avav10985/flightflight/docs/media/boot-screen.jpg

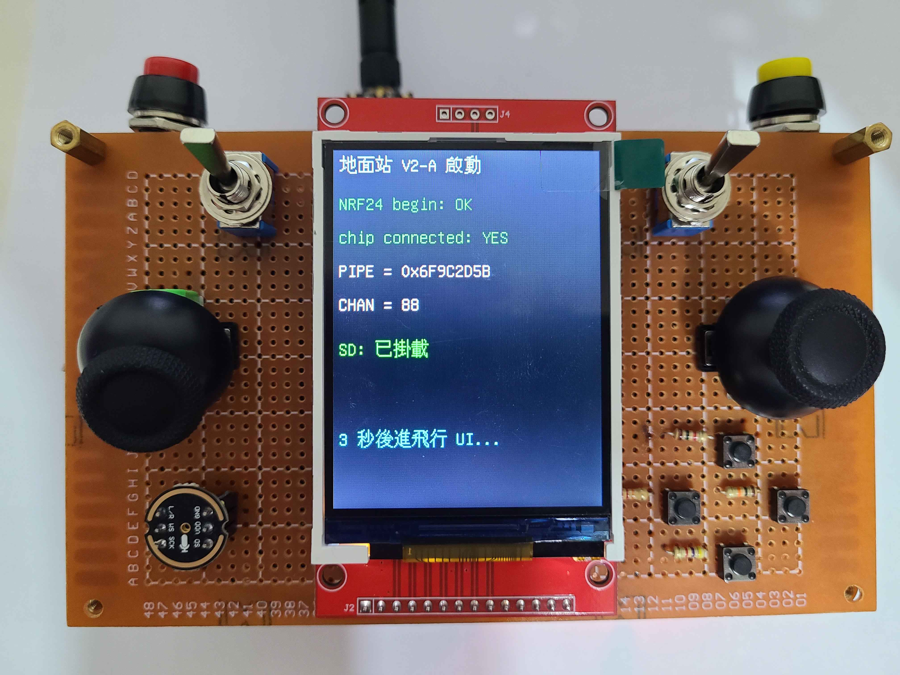
docs/media/boot-screen.jpg
