avav10985/flightflight/docs/media/drone-front.jpg

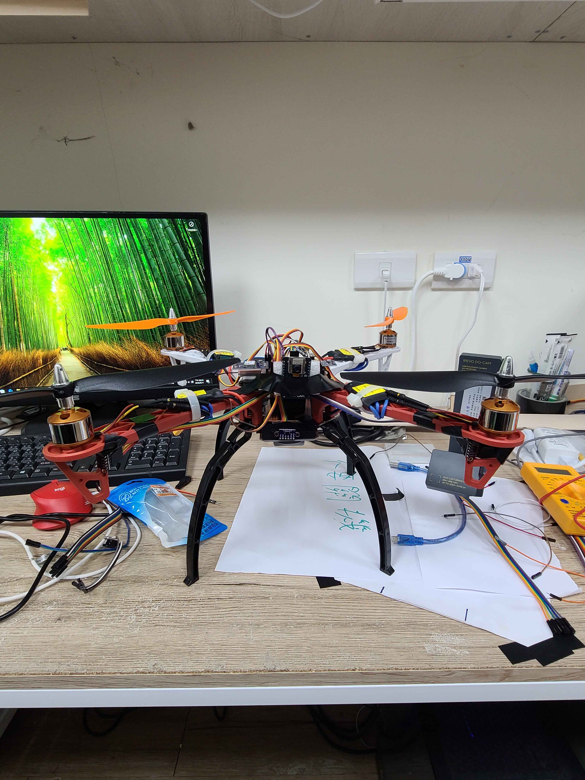
docs/media/drone-front.jpg
