avav10985/flightflight/文件/手把接線總表_V2.md

## 手把接線總表（V2-A：ESP32-S3-N16R8 + MSP2806 SPI TFT 直立）

> 焊接 + 買料用的單一對照表。對應程式：`Ground_TX_ESP32`（V2-A）。
> 設計理由與全套規劃見 `手把V2_討論摘要.md`；本檔只列「買什麼、接哪裡」。
> 注意：V1（30-pin WROOM + 2004A LCD）已跳過，舊的 `手把接線總表.md` 不再對應實作。
>
> **2026-06-02 變更**：螢幕從 MAR2406 並列 8-bit 換成 **MSP2806 2.8" SPI 直立 240×320**，
> 省 9 隻 GPIO（GPIO 11~18 釋出）+ A↔C 杜邦線從 26 降到 17。MAR2406 留為備用。
>
> **2026-06-02 再變更**:左搖桿 X 軸(VRx)從「不接」改接 **GPIO 2**(ADC1_CH1),
> 當作可選的 yaw 來源(預設仍是肩鍵,選擇 UX 等手把做好再加)。
> A↔C 杜邦線 17→18,C↔B 排線 11→12,腳位 26→27。
> V2-B I²S 保留腳 5→4(剛好夠 BCLK/WS/DIN/DOUT)。
>
> **2026-06-03 再三變更**:**GPIO 2 ↔ GPIO 10 對調**——左搖桿 yaw 改 GPIO 2、右搖桿 pitch 改 GPIO 10。
> 規律變整齊:**右側 ESP32 = 左搖桿訊號(throttle GPIO 1 + yaw GPIO 2)**、**左側 ESP32 = 右搖桿訊號(pitch GPIO 10 + roll GPIO 4)**。
>
> **2026-06-03 再再變更**:**TFT MSP2806 物理上搬到 B 板**(裝在前面板上,跟搖桿一起),
> C 板還在(電阻中繼)。TFT 訊號**用一條獨立的 6 條副排線**從 B 走到 C(不擠 12 條主排線),
> 再經 A↔C 杜邦回 A:CS、DC、SCK、MOSI、MISO、**RESET** 共 6 條。
> VCC/GND/LED 從 B 板既有 **3V3 軌**取(維持 3.3V 跟訊號同位準);
> RESET 線從 B 走副排線 #6 進 C 板,經 **R10 10kΩ 上拉到 3V3 軌**(保留未來加 GPIO 控制 RESET 的彈性)。

---

## 〇、元件對元件接線

> **架構**(2026-06-03 最新版):A 板腦 + **C 板電阻中繼** + B 板前面板(含 TFT)。
> A↔C 用**杜邦線 18 條**(可拔);C↔B 用**主排線 12 條**(輸入訊號)+ **副排線 6 條**(TFT 訊號)。
> ⚠️ 2026-06-06 試燒驗證:**MSP2806 LED 腳直接拉 B 板 3V3 軌常亮**(LED 內部沒接 VCC,接 GPIO PWM 不會亮),GPIO 15 回歸真正釋出。
> **11 顆電阻 + 肩鍵連接終點在 C 板**,B 板沒電阻。**TFT MSP2806 物理上裝在 B 板**(前面板),
> 訊號走 4 條副排線到 C → 再經 A↔C 杜邦回 A。
> 左搖桿兩軸都用:Y=油門(拆彈簧)、**X=可選 yaw 來源**(預設肩鍵,程式選單切換)。

### A 板(腦)上有什麼

| 元件 | 數量 | 備註 |
|--|:--:|--|
| ESP32-S3-N16R8 | 1 | 用 2×22 排母可拔 |
| NRF24L01+PA/LNA | 1 | 用排母可拔,緊貼右側 GPIO 38~42 |
| 100µF 電解電容 C1 | 1 | 焊在 NRF24 VCC↔GND(< 5mm)|
| 0.1µF 陶瓷電容 C2 / C3 / C4 | 3 | 選用:NRF24、S3、buck 出口各一 |
| buck 降壓模組 | 1 | MP1584 或 LM2596,OUT 先量好調 5.0V |
| 電源開關(SPST) | 1 | 串電池 + |
| 電池接頭(2S 7.4V) | 1 | XT60 / JST |
| **18 條杜邦排針**(4 組) | 1 套 | 對外接 C 板:電源3 + TFT 中繼2(CS/DC) + SPI/SD 4(SCK/MOSI/MISO/SD_CS,C 板上分歧給 SD 和 TFT) + B訊號9(含左搖桿 X) |

> A 板**沒有電阻**(R11 已搬到 C 板,跟其他電阻集中)。

### C 板(電阻中繼 + 訊號分歧點)

| 元件 | 數量 | 備註 |
|--|:--:|--|
| **R1:1kΩ** | 1 | ＋鈕串聯 |
| **R2:4.7kΩ** | 1 | −鈕串聯 |
| **R3、R5、R6、R7、R8、R9、R10、R11:10kΩ ×8** | 8 | OK 串聯 + 選單下拉 + SW_A 分壓×2 + SW_B 分壓×2 + **R10 LCD_RST 上拉**(從副排線 #6 進來) + SD_CS 上拉 |
| **R4:22kΩ** | 1 | 返回鈕串聯 |
| 肩鍵 L、R 連接終點 | 2 套 | 實體鈕鎖在外殼,線拉到 C |
| microSD 卡模組 | 1 | **定案用這個**(免轉接卡,模組小不頂搖桿)。MSP2806 內建 SD 座永遠空著別插卡 |
| 18 條杜邦排針(對 A 板) | 1 套 | 跟 A 板分組順序一致 |
| 12 條主排線接座(對 B,輸入訊號) | 1 套 | 給 B 板主排線插 |
| **6 條副排線接座(對 B,TFT 訊號)** | 1 套 | 給 B 板 TFT 副排線插(CS / DC / SCK / MOSI / MISO / RESET) |

> R10 重新啟用:TFT RESET 從 B 板經副排線 #6 進 C 板,接 R10 一端,R10 另一端接 C 板 3V3 軌(平常拉高 = 不重置;保留未來加 GPIO 控制 RESET 的彈性)。
> **TFT 不在 C 板了,搬到 B 板**。C 板變純電阻中繼 + SPI 訊號分歧點(SCK/MOSI/MISO 在 C 板上分歧:一路給 SD,一路經副排線給 B 板 TFT)。

### B 板(前面板:玩家會看到/摸到的東西)

| 元件 | 數量 | 備註 |
|--|:--:|--|
| **TFT MSP2806(2.8" SPI ILI9341)** | 1 | 鎖在前面板正中,**單排 14 隻排針**直接插 B 板的母排座 |
| **1×14 母排座(2.54mm)** | 1 | 插 MSP2806 那排排針(完全對齊洞洞板) |
| 搖桿模組(PS5 拇指搖桿) | 2 | 左=油門(Y,拆彈簧)**+ 可選 yaw(X,留彈簧)**;右=pitch/roll(留彈簧)|
| MTS-103 3 段開關 | 2 | SW_A、SW_B,ON-OFF-ON |
| 6mm 輕觸按鈕 | 4 | 選單 ＋/−/OK/Back |
| 12 條主排線接座(對 C,輸入訊號) | 1 套 | 給 C 板主排線插 |
| **6 條副排線接座(對 C,TFT 訊號)** | 1 套 | 給 C 板 TFT 副排線插(CS / DC / SCK / MOSI / MISO / RESET) |

> B 板**沒有電阻、沒有肩鍵**,但**有 TFT**(2026-06-03 從 C 搬過來,因為螢幕本來就要在前面板上跟搖桿一起)。

### 不在板上(整套手把的一部分)

- **肩鍵 L、R**:實體鎖在外殼上半部(食指位置),線拉到 C 板
- **2S LiPo 電池**
- **杜邦線 18 條**(A↔C,可彩虹色)
- **主排線 12 條**(C↔B,輸入訊號)
- **副排線 6 條**(C↔B,TFT 訊號:CS / DC / SCK / MOSI / MISO / RESET)
- **TFT LED 腳** 直接接 B 板 3V3 軌(不走副排線、不接 GPIO)
- **外殼**:面板開孔給 TFT、搖桿、開關、按鈕;上半部開孔給肩鍵

### V2-B 階段才會加(現在還沒放)

| 元件 | 數量 | 備註 |
|--|:--:|--|
| INMP441 麥克風模組 | 1 | I²S 數位麥克風,語音輸入用 |
| MAX98357A I²S 放大模組 | 1 | I²S → 喇叭驅動 |
| 小喇叭 | 1 | 4Ω 或 8Ω,3W 內 |
| I²S 4 條線 | — | BCLK、WS(LRCK)、DIN(麥)、DOUT(喇叭) |
| (V2-B 開工時)犧牲一條 debug UART | — | 釋出 GPIO 19/20(原生 USB)或 43/44(UART0)給 I²S |

> V2-B 走線:**I²S 4 條腳改用釋出腳 GPIO 11~14**(MSP2806 SPI 換來的)。GPIO 19/20、43/44 保持作為 debug 序列埠(兩條都活)。

---

### 螢幕(MSP2806 2.8" SPI ILI9341)↔ ESP32-S3

> MSP2806 **物理上裝在 B 板**(前面板),單排 14 隻排針插 B 板的 1×14 母排座。
> 訊號從 B 板出來經 **5 條副排線 → C 板 → A↔C 杜邦 → A 板**(SPI 部分跟 NRF24/SD 共用,在 C 板上分歧)。

| ESP32-S3 | MSP2806 排針 | 訊號路徑 |
|:--:|:--:|--|
| GPIO 48 | **CS** | A 板 GPIO 48 → A↔C 杜邦「TFT CS」→ C 板 → 副排線 #1 → B 板 TFT CS |
| GPIO 21 | **DC**(或 RS) | A 板 GPIO 21 → A↔C 杜邦「TFT DC」→ C 板 → 副排線 #2 → B 板 TFT DC |
| GPIO 38 | **SCK** | A 板 GPIO 38 → A↔C 杜邦「SCK」→ C 板(分歧:給 SD + 副排線 #3 → B 板 TFT SCK)|
| GPIO 39 | **SDI(MOSI)** | A 板 GPIO 39 → A↔C 杜邦「MOSI」→ C 板(分歧:給 SD + 副排線 #4 → B 板 TFT MOSI)|
| GPIO 40 | **SDO(MISO)** | A 板 GPIO 40 → A↔C 杜邦「MISO」→ C 板(分歧:給 SD + 副排線 #5 → B 板 TFT MISO)|
| (不接 GPIO) | **RESET** | B 板 TFT RESET → 副排線 #6 → C 板 R10 一端 → R10 另一端 → 3V3 軌(平常拉高)|
| (不接 GPIO)| **LED**(背光) | **直接接 B 板 3V3 軌常亮**(MSP2806 LED 內部沒接 VCC,試燒驗證 PWM 不會亮)|

TFT 其他腳(在 B 板上**直接**接,不走副排線):

| MSP2806 排針 | 接到 | 說明 |
|:--:|--|--|
| **VCC** | B 板 3V3 軌(3V3 從 C↔B 主排線 #1 來) | 主電源 |
| **GND** | B 板 GND 軌 | — |
| **T_CLK / T_CS / T_DIN / T_DO / T_IRQ** | **不接** | 觸控版才用,V2-A 沒觸控 |

(**RESET** 走副排線 #6 到 C 板的 R10 上拉、**LED** 直接接 B 板 3V3 軌常亮)

**省下來的 GPIO 11~18**(原本給並列資料的 8 隻)**全部釋出**——可給 V2-B、額外按鈕、LED 等。
**R10 變備用**:留 C 板上但無功能(MSP2806 不需要 RESET 上拉,直接拉 3V3 軌即可)。

---

### NRF24L01+PA/LNA ↔ ESP32-S3

| ESP32-S3 | NRF24 |
|:--:|:--:|
| GPIO 41 | CE |
| GPIO 42 | CSN |
| GPIO 38 | SCK |
| GPIO 39 | MOSI |
| GPIO 40 | MISO |

NRF24 其他腳:

| NRF24 腳 | 接到 |
|:--:|--|
| VCC | 3V3 |
| GND | GND |
| IRQ | 不接 |
| 100µF 一端 | NRF24 VCC |
| 100µF 另一端 | NRF24 GND |

---

### SD 卡 ↔ ESP32-S3(獨立 microSD 模組,放 C 板)

> ⚠️ **2026-06-09 暫時停用**:現有 SD 模組内含 level shifter,共 SPI 會搶 bus 拖爆
> NRF24 init(實證 begin: FAIL)。**飛行測試先把 SD VCC 拔掉**,程式 `ENABLE_SD = 0`
> 跳過 init。GPIO 47(SD CS)暫時空閒。
> 長期解法:換 3V3 直連、不含 level shifter 的 SD 模組。

> **定案用獨立 microSD 模組**(放 C 板)。
> 原因:MSP2806 內建是全尺寸 SD 座,卡插入後會凸出 ~7mm 頂到搖桿。
> MSP2806 板上的 SD 座**永遠空著別插卡**(電氣上 CS 也不接)。

| ESP32-S3 | 獨立 microSD 模組 | 說明 |
|:--:|:--:|--|
| **GPIO 0** | **CS** | 經 **R11:10kΩ 上拉**到 3V3;BOOT 腳開機 HIGH 安全 |
| GPIO 38 | **SCK** | 跟 NRF24 / TFT 共用 |
| GPIO 39 | **MOSI** | 跟 NRF24 / TFT 共用 |
| GPIO 40 | **MISO** | 跟 NRF24 / TFT 共用 |
| 3V3 軌 | VCC | |
| GND 軌 | GND | |

---

### 左搖桿(油門 + 可選 yaw)↔ ESP32-S3

| ESP32-S3 | 左搖桿 |
|:--:|:--:|
| GPIO 1 | VRy(Y 軸抽頭 → 油門,拆彈簧)|
| **GPIO 2** | **VRx(X 軸抽頭 → 可選 yaw,留彈簧)** |
| 3V3 | VCC |
| GND | GND |

左搖桿的 SW 不接。
**yaw 來源預設用肩鍵**;選單可切換到左搖桿 X(UX 等手把做好再加)。
**訊號全在 ESP32 右側**(GPIO 1 右#4 + GPIO 2 右#5,相鄰整齊)。

---

### 右搖桿(pitch / roll)↔ ESP32-S3

**訊號全在 ESP32 左側**(GPIO 10 左#16 + GPIO 4 左#4)。

| ESP32-S3 | 右搖桿 |
|:--:|:--:|
| **GPIO 10** | VRy(Y 軸抽頭 → pitch) |
| GPIO 4 | VRx(X 軸抽頭 → roll) |
| 3V3 | VCC |
| GND | GND |

右搖桿的 SW 不接。

---

### 模式開關 SW_A(MTS-103,3 段)↔ ESP32-S3

| ESP32-S3 | SW_A |
|:--:|:--:|
| GPIO 5 | 中腳(common) |
| 3V3 | 上腳(throw1) |
| GND | 下腳(throw2) |

GPIO 5 上同時並聯兩顆電阻:

| 電阻 | 一端 | 另一端 |
|:--:|--|--|
| R6:10kΩ | GPIO 5 | 3V3 |
| R7:10kΩ | GPIO 5 | GND |

---

### 模式開關 SW_B(MTS-103,3 段)↔ ESP32-S3

| ESP32-S3 | SW_B |
|:--:|:--:|
| GPIO 6 | 中腳(common) |
| 3V3 | 上腳 |
| GND | 下腳 |

GPIO 6 上同時並聯兩顆電阻:

| 電阻 | 一端 | 另一端 |
|:--:|--|--|
| R8:10kΩ | GPIO 6 | 3V3 |
| R9:10kΩ | GPIO 6 | GND |

---

### 選單 4 鈕(共用 GPIO 7,4 顆鈕電阻不同)

每顆鈕**有 2 腳**:一腳接 3V3,另一腳經自己的電阻接到 GPIO 7。

| ESP32-S3 | 經這顆電阻 | 來自哪顆鈕的「非 3V3 那腳」 |
|:--:|:--:|:--|
| GPIO 7 | R1:1kΩ | ＋鈕 |
| GPIO 7 | R2:4.7kΩ | −鈕 |
| GPIO 7 | R3:10kΩ | OK 鈕 |
| GPIO 7 | R4:22kΩ | 返回鈕 |

GPIO 7 還有一顆下拉:

| 電阻 | 一端 | 另一端 |
|:--:|--|--|
| R5:10kΩ | GPIO 7 | GND |

每顆鈕的「另一腳」全部接 3V3。

---

### 肩鍵 L ↔ ESP32-S3

| ESP32-S3 | 肩鍵 L |
|:--:|:--:|
| GPIO 8 | 一腳 |
| GND | 另一腳 |

---

### 肩鍵 R ↔ ESP32-S3

| ESP32-S3 | 肩鍵 R |
|:--:|:--:|
| GPIO 9 | 一腳 |
| GND | 另一腳 |

---

### 電源(buck / 電池 / 開關)

| 一端 | 另一端 |
|:--:|:--:|
| 電池 + 紅線 | 電源開關 一端 |
| 電源開關 另一端 | buck IN+ |
| 電池 − 黑線 | buck IN− |
| buck OUT+ | ESP32-S3 5V 腳;再經 A↔C 杜邦 → C 板 5V 軌(若 TFT 用 5V 則經主排線到 B 板 TFT VCC)|
| buck OUT− | ESP32-S3 GND;GND 全部共接 |

---

### C↔B 板 12 條排線(C 是中繼,B 沒有電阻)

| # | C 板端(電阻/節點端) | B 板端(實體元件端) |
|:--:|--|--|
| 1 | C 板 3V3 軌 | B 板 3V3 軌 |
| 2 | C 板 GND 軌 | B 板 GND 軌 |
| 3 | (上接 A 杜邦 → GPIO 1) | 左搖桿 VRy(throttle) |
| 4 | (上接 A 杜邦 → **GPIO 2**)| **左搖桿 VRx(可選 yaw)** |
| 5 | (上接 A 杜邦 → **GPIO 10**)| 右搖桿 VRy(pitch) |
| 6 | (上接 A 杜邦 → GPIO 4) | 右搖桿 VRx(roll) |
| 7 | (上接 A 杜邦 → GPIO 5)+ R6/R7 分壓 | SW_A 中腳 |
| 8 | (上接 A 杜邦 → GPIO 6)+ R8/R9 分壓 | SW_B 中腳 |
| 9 | R1(1kΩ)→ 選單節點 | ＋鈕「非 3V3 腳」 |
| 10 | R2(4.7kΩ)→ 選單節點 | −鈕「非 3V3 腳」 |
| 11 | R3(10kΩ)→ 選單節點 | OK 鈕「非 3V3 腳」 |
| 12 | R4(22kΩ)→ 選單節點 | 返回鈕「非 3V3 腳」 |

> 選單節點(R1~R4 匯流 + R5 下拉)在 C 板,4 顆鈕各自拉一條線過來。
> 肩鍵 L/R 不在 B↔C 排線裡,從外殼直接拉短線到 C 板。

### C↔B 板 6 條副排線(TFT 訊號專用)

> TFT MSP2806 物理上在 B 板,訊號從 B 板的 14 隻母排座引出 7 條,經副排線送到 C 板,再經 A↔C 杜邦回 A 板。
> **跟 12 條主排線分開**(實體用兩束排線,免訊號擠在一起)。

| # | C 板端 | B 板端(MSP2806 排針) |
|:--:|--|--|
| 1 | (從 A 來)GPIO 48「TFT CS」| **CS** |
| 2 | (從 A 來)GPIO 21「TFT DC」| **DC**(或 RS)|
| 3 | C 板 SPI SCK 節點(分歧:給 SD + 給此線)| **SCK** |
| 4 | C 板 SPI MOSI 節點(分歧:給 SD + 給此線)| **SDI(MOSI)** |
| 5 | C 板 SPI MISO 節點(分歧:給 SD + 給此線)| **SDO(MISO)** |
| 6 | C 板 **R10 一端**(R10 另一端接 3V3 軌,上拉)| **RESET** |

> **VCC/GND 從 B 板既有 3V3/GND 軌取**(維持 3.3V 跟訊號同位準),所以副排線只有 7 條訊號(原本含 LED 應該再多 1 條,但 LED 走 PWM 是訊號線,放在副排線裡)。

### A↔C 板 18 條杜邦線(分 4 組排針)

| 組 | 內容 | 條數 |
|--|--|:--:|
| 電源 | 3V3、5V、GND | **3** |
| **TFT 中繼**(進 C 後轉副排線給 B) | CS(GPIO 48)、DC(GPIO 21) | **2** |
| SPI / SD(共用) | SCK、MOSI、MISO、SD_CS(SCK/MOSI/MISO 在 C 板上分歧:給 SD + 給副排線到 B 的 TFT)| **4** |
| B 訊號 + 肩鍵 | throttle / 左搖桿 X(yaw)/ pitch / roll / SW_A / SW_B / 選單節點 / 肩L / 肩R | **9** |
| **小計** | | **19** |

> 從 26 條(MAR2406 並列年代)降到 18 條——SPI 換掉並列省 9 條,加左搖桿 X(+1)。LED PWM(2026-06-04 一度加入,2026-06-06 試燒驗證 MSP2806 LED 不能 PWM 撤回)。
> 兩端排針順序**完全一樣**,杜邦線一條條平行插不交叉。V2-B 加 I²S 時還不用多杜邦(I²S 走 11~14,跟 V2-A 線路無關)。
> TFT 訊號(CS/DC + SCK/MOSI/MISO + RESET)**在 C 板上轉換成副排線 6 條**送到 B 板的 TFT 母排座。LED 直接在 B 板接 3V3 軌不走副排線。

---

### 11 顆電阻(整理:每顆兩端接哪)

| 電阻 | 一端 | 另一端 |
|:--:|--|--|
| R1:1kΩ | ＋鈕 一腳 | ESP32-S3 GPIO 7 |
| R2:4.7kΩ | −鈕 一腳 | ESP32-S3 GPIO 7 |
| R3:10kΩ | OK 鈕 一腳 | ESP32-S3 GPIO 7 |
| R4:22kΩ | 返回鈕 一腳 | ESP32-S3 GPIO 7 |
| R5:10kΩ | ESP32-S3 GPIO 7 | GND 軌 |
| R6:10kΩ | ESP32-S3 GPIO 5 | 3V3 軌 |
| R7:10kΩ | ESP32-S3 GPIO 5 | GND 軌 |
| R8:10kΩ | ESP32-S3 GPIO 6 | 3V3 軌 |
| R9:10kΩ | ESP32-S3 GPIO 6 | GND 軌 |
| R10:10kΩ | (備用,**留在 C 板但不接**;原本 TFT RESET 上拉,改為 RESET 在 B 板直接接 3V3 軌)| — |
| R11:10kΩ | ESP32-S3 GPIO 0 | 3V3 軌 |

### 4 顆電容(整理:每顆兩端接哪)

| 電容 | 一端 | 另一端 |
|:--:|--|--|
| C1:100µF 電解(必接) | NRF24 VCC 腳 | NRF24 GND 腳 |
| C2:0.1µF 陶瓷(選用) | NRF24 VCC 腳 | NRF24 GND 腳(跟 C1 並聯)|
| C3:0.1µF 陶瓷(選用) | ESP32-S3 3V3 腳 | ESP32-S3 GND 腳(就近)|
| C4:0.1µF 陶瓷(選用) | buck OUT+ | buck OUT− |

---

## 一、材料清單

| 元件 | 數量 | 規格 | 備註 |
|---|:--:|---|---|
| **ESP32-S3-N16R8** | 1 | 44 腳, 16MB Flash + 8MB OCTAL PSRAM, 雙 USB-C, IPEX 天線 | 已有 |
| **MSP2806 TFT**(主用) | 1 | 2.8", 240×320, ILI9341 **SPI**, 板上含 SD 座(**不用,空著**), 無觸控;**裝在 B 板上**(前面板)| 已有 |
| 1×14 母排座(2.54mm) | 1 | 裝在 B 板上,插 MSP2806 那排排針 | |
| 6 條短排線(B↔C TFT 副排線) | 1 套 | 給 TFT 訊號 CS/DC/SCK/MOSI/MISO/RESET 用 | |
| ~~MAR2406 TFT~~(備用) | 1 | 2.4", 320×240, ILI9341 並列 8-bit | 留備用,不在 V2-A 接線中 |
| **NRF24L01+PA/LNA** | 1 | 另需 100µF（VCC-GND，不能省）| 沿用 V1 |
| 100µF 電解電容 | 1 | ≥10V，焊在 NRF24 VCC-GND | |
| **搖桿模組** | 2 | 左=油門（拆彈簧）、右=pitch/roll（留彈簧）| 沿用 V1（PS5 拇指搖桿） |
| 3 段開關 MTS-103 | 2 | ON-OFF-ON, 3 腳（中間斷開）| 沿用 V1 |
| 輕觸按鈕 6mm | 6 | 4 選單鈕 + 2 肩鍵 | 沿用 V1 |
| 電阻 1/4W | 9 | 見「電阻總表」 | 沿用 V1 |
| **buck 模組** | 1 | MP1584/LM2596，調 **5.0V** | 沿用 V1 |
| 2S LiPo + 接頭 | 1 | 7.4V | 已有 |
| 電源開關（建議） | 1 | SPST 串電池正極 | |
| SD 卡（選） | 1 | 用 TFT 板上的座；也可不放 | |
| 主控與螢幕**插拔座** | — | 排針排母（方便燒錄取下） | 使用者習慣 |

V2-B 之後才買的:INMP441 麥克風、MAX98357A 放大、**喇叭(已備:JINHUA 28mm 8Ω/2W 內磁,跟 MAX98357A 完美配對)**。

---

## 二、完整腳位表（V2-A 18 個 GPIO + V2-B 4 個 = 22 個 GPIO)

| GPIO | 接什麼 | 怎麼接 | 階段 |
|:--:|---|---|:--:|
| **0** | SD CS(10k 上拉到 3V3)| BOOT 腳,開機 HIGH 安全;接獨立 microSD 模組 CS | V2-A |
| **1** | 左搖桿 油門(Y)抽頭 | ADC1;搖桿兩端 3V3/GND | V2-A |
| **2** | **左搖桿 X(VRx)= 可選 yaw** | ADC1_CH1;預設不啟用,選單切換 | V2-A |
| **4** | 右搖桿 roll(X)抽頭 | ADC1 | V2-A |
| **5** | 模式開關 A common | ADC1 三階 + 10k/10k 分壓 | V2-A |
| **6** | 模式開關 B common | ADC1 三階 + 10k/10k 分壓 | V2-A |
| **7** | 選單鈕電阻階梯節點 | ADC1 + 電阻階梯 | V2-A |
| **8** | 肩鍵 L(預設 yaw 左) | 另一腳 → GND(內部上拉)| V2-A |
| **9** | 肩鍵 R(預設 yaw 右) | 另一腳 → GND(內部上拉)| V2-A |
| **10** | **右搖桿 pitch(Y)抽頭** | ADC1_CH9 | V2-A |
| **11** | **I²S BCLK** | 共用:INMP441 SCK + MAX98357A BCLK | **V2-B** |
| **12** | **I²S WS / LRCLK** | 共用:INMP441 WS + MAX98357A LRC | **V2-B** |
| **13** | **I²S DOUT** | MAX98357A DIN(ESP32→放大器) | **V2-B** |
| **14** | **I²S DIN** | INMP441 SD(麥克風→ESP32) | **V2-B** |
| **15** | **真正釋出可用**(原本想 TFT LED PWM,2026-06-06 撤回)| 不接 | — |
| 16、17、18、47 | **真正釋出可用**(V2-C/D 用) | — | — |
| **21** | MSP2806 **DC**(在 B 板) | 經 A↔C 杜邦 → C 中繼 → 副排線 #2 | V2-A |
| **48** | MSP2806 **CS**(在 B 板) | 經 A↔C 杜邦 → C 中繼 → 副排線 #1 | V2-A |
| MSP2806 RESET | 走副排線 #6 → C 板 R10 → 3V3 軌(經 10kΩ 上拉)| 不接 GPIO | V2-A |
| **38** | NRF24 SCK + SD SCK + TFT SCK(共用 SPI)| C 板上分歧 | V2-A |
| **39** | NRF24 MOSI + SD MOSI + TFT MOSI(共用)| C 板上分歧 | V2-A |
| **40** | NRF24 MISO + SD MISO + TFT MISO(共用)| C 板上分歧 | V2-A |
| **41** | NRF24 CE | | V2-A |
| **42** | NRF24 CSN | | V2-A |
| **19** | **保留**:native USB CDC debug(USB-C 直接看 Serial)| 不接 | debug |
| **20** | **保留**:native USB CDC debug | 不接 | debug |
| **43** | **保留**:UART0 debug TX(CH-340 那邊)| 不接 | debug |
| **44** | **保留**:UART0 debug RX | 不接 | debug |

**V2-B I²S 語音 4 隻**:**11、12、13、14**(BCLK/WS/DOUT/DIN,用 MSP2806 SPI 換來的釋出腳)。
**TFT LED**:直接接 B 板 3V3 軌常亮(不接 GPIO,2026-06-06 試燒確認)。
**真正釋出可用** 5 隻:**15**、16、17、18、47(2026-06-06 起含 GPIO 15)。
**Debug 序列埠都保留**:19/20(native USB CDC)+ 43/44(UART0)——V2-B 加完還能燒程式 + 看 Serial。
**避開**:3(避開)、26~37(內部 Flash + PSRAM 永久佔用)、45、46(strapping)。

---

## 三、各元件接法細節

### 搖桿（2 顆）
- **左搖桿**:上下(Y) → **GPIO1**(油門,已拆彈簧);**左右(X) → GPIO 2**(可選 yaw,彈簧留著)。
- **右搖桿**:上下(Y) → **GPIO 10**(pitch)、左右(X) → **GPIO4**(roll);彈簧留著。
- VCC → **3V3（不能 5V！）**、GND → GND、各軸抽頭 → 對應 ADC 腳。
- yaw 控制有兩個來源,**預設用肩鍵**(GPIO 8/9);程式選單可切換到左搖桿 X 軸(GPIO 2)。
- 規律:**左搖桿訊號全在 ESP32 右側**(GPIO 1+2 相鄰)、**右搖桿訊號全在左側**(GPIO 4+10)。

### 模式開關 A / B（各一顆 MTS-103，3 腳）
```
上腳 ──────── 3V3
中腳(common) ─ GPIO（A=5 / B=6）
下腳 ──────── GND

節點(GPIO) 加分壓定義中檔：
節點 ──[10kΩ]── 3V3
節點 ──[10kΩ]── GND
```
撥上=0、中(斷)=1、下=2；**模式 = A×10 + B 兩位數編碼**（00/01/02/10/11/12/20/21/22，見 `Ground_TX_ESP32.ino` L876）。

### 選單鈕電阻階梯（4 鈕共用 GPIO7）
```
3V3 ─┬─[＋鈕]──[1kΩ]───┐
     ├─[−鈕]──[4.7kΩ]──┤
     ├─[確定]──[10kΩ]───┼──→ GPIO7
     └─[返回]──[22kΩ]───┘
                         │
                       [10kΩ]   ← 下拉，定義「都沒按 = 0V」
                         │
                        GND
```
門檻與 V1 同（3250 / 2415 / 1665 / 640），程式內可實測微調。

### 肩鍵 L / R
每顆按鈕：一腳 → GPIO8 / 9，另一腳 → GND。按下接通（內部上拉，按下讀 LOW）。

### TFT MSP2806(2.8" SPI ILI9341,直立 240×320)— **物理在 B 板**

| MSP2806 排針 | 接到 | 路徑 |
|--|--|--|
| **CS** | GPIO 48 | 副排線 #1 → C 板 → A↔C 杜邦「TFT CS」→ A 板 GPIO 48 |
| **DC**(或 RS) | GPIO 21 | 副排線 #2 → C 板 → A↔C 杜邦「TFT DC」→ A 板 GPIO 21 |
| **RESET** | **副排線 #6 → C 板 R10 → 3V3 軌**(經 10kΩ 上拉)| 平常拉高 = 不重置 |
| **SDI(MOSI)** | GPIO 39 | 副排線 #4 → C 板 SPI 分歧點 → A↔C 杜邦「MOSI」→ A 板 GPIO 39(跟 NRF24/SD 共用)|
| **SCK** | GPIO 38 | 副排線 #3 → C 板 SPI 分歧點 → A↔C 杜邦「SCK」→ A 板 GPIO 38(共用)|
| **SDO(MISO)** | GPIO 40 | 副排線 #5 → C 板 SPI 分歧點 → A↔C 杜邦「MISO」→ A 板 GPIO 40(共用;TFT 用來回傳 ID,init 確認晶片)|
| **LED** | **B 板 3V3 軌** | 背光常亮 |
| **VCC** | **B 板 3V3 軌**(推薦)或 5V 軌(都可) | 規格 3.3V~5V,90mA |
| **GND** | **B 板 GND 軌** | |
| **T_CLK / T_CS / T_DIN / T_DO / T_IRQ** | **不接** | MSP2806 無觸控,觸控腳留空 |
| **板上 SD 卡座** | **永遠空著別插卡**(全尺寸 SD 卡會頂搖桿,改用 C 板上的獨立 microSD 模組) | 不接 CS |

> MSP2806 排針單排 14 隻 2.54mm,**插 B 板的 1×14 母排座**——免做轉接小板。
> ⚠️ 訊號線**必須 3.3V 邏輯**(ESP32-S3 原生支援)。不能用 5V MCU 直接接,會燒。

### NRF24L01+PA/LNA（與 SD 共用 SPI）
| NRF24 腳 | 接 ESP32-S3 | 備註 |
|--|--|--|
| VCC | **3V3（不能 5V！）** | + **100µF 電容 VCC-GND** |
| GND | GND | |
| CE | **GPIO 41** | |
| CSN | **GPIO 42** | |
| SCK | **GPIO 38**（與 SD 共用）| |
| MOSI | **GPIO 39**（與 SD 共用）| |
| MISO | **GPIO 40**（與 SD 共用）| |

---

## 四、供電（2S 7.4V → buck → 5V）

```
2S 7.4V ─[電源開關]─→ buck(調 5.0V) ─┬→ ESP32-S3 5V/VIN
                                       └→ (V2-B 加 MAX98357A 5V)

ESP32-S3 3V3 ─┬→ NRF24 VCC (+100µF)
              └→ 經 A↔C 杜邦進 C 板 3V3 軌
                  ├→ R6 / R8(SW 上拉)
                  ├→ R10 一端(另一端 → 副排線 #6 → B 板 TFT RESET)
                  ├→ R11(SD_CS 上拉,SD 視位置在 B 或 C)
                  └→ 經 C↔B 主排線 #1 進 B 板 3V3 軌
                      ├→ 兩顆搖桿 VCC
                      ├→ MSP2806 TFT VCC + LED(LED 跟 VCC 都接 3V3 軌常亮)
                      └→ 模式開關 / 選單階梯 的 3V3 參考

所有 GND 共接。
```

⚠️ **手把不做電池監測**（V2 設計決定，LCD 變暗自己會發現要充電）。

---

## 五、電阻總表（共 11 顆，1/4W）

| 阻值 | 數量 | 用在哪 |
|:--:|:--:|---|
| 1kΩ | 1 | 選單「＋」串聯 |
| 4.7kΩ | 1 | 選單「−」串聯 |
| 10kΩ | **8** | 選單「確定」串聯×1 + 選單節點下拉×1 + 開關 A 2 顆 + 開關 B 2 顆 + LCD_RST 上拉×1 + SD_CS 上拉×1 |
| 22kΩ | 1 | 選單「返回」串聯 |

---

## 六、三條鐵則

1. **搖桿、NRF24 都吃 3V3，不能 5V**（搖桿超壓打壞 ADC、NRF24 直接燒）。
2. **buck 先接電池量 OUT、轉到剛好 5.0V，再接 ESP32**（LM2596 出廠電壓亂的）。
3. **NRF24 的 100µF 電容不能省**（發射尖峰微秒級，靠它補，buck 來不及）。

---

## 七、燒錄後桌上驗證

| 驗證 | 怎麼看 / 怎麼修 |
|---|---|
| 油門方向 | 推到底 TFT 顯示 `Thr 0%`；反了改程式 `REV_THROTTLE` |
| 模式碼 | 撥開關，模式應為 上上=0 … 下下=8；不對改 `readSwitch3` 門檻 |
| 選單鈕 | 按各鈕認對；ADC 偏了改 `readMenuBtn` 門檻 |
| 肩鍵 yaw 方向 | 反了把 GPIO 8/9 兩腳對調 |
| TFT 顯示 | 開機看到模式名稱 + 遙測；亂碼/反色檢查 LovyanGFX 的 panel config |
| NRF24 雙向遙測 | TFT 出現飛機姿態/電量、`Link OK`（要飛機端同時開機） |
| SD 卡 | 序列埠看 `SD mounted` 或 `SD missing`；V2-A 不寫入，能掛載即可 |

> ⚠️ 飛機端 `Drone_FC_PID` 已改成 9 模式封包（V1 時改的），與 V2 手把相容。**兩支同時重燒**，不然封包對不上會收到亂碼。

---

## 八、Arduino IDE 設定

| 項目 | 設定 |
|--|--|
| 開發板 | **ESP32S3 Dev Module** |
| USB CDC On Boot | **Enabled**（從原生 USB 拿 Serial）|
| Flash Size | **16MB** |
| Partition Scheme | **16M Flash (3MB APP/9.9MB FATFS)** 或類似有 OTA 的 |
| PSRAM | **OPI PSRAM**（N16R8 是 OCTAL）|
| Upload Speed | 921600 |
| USB Mode | Hardware CDC and JTAG |

> 函式庫:**LovyanGFX**(Library Manager 搜尋)、**RF24**(TMRh20)、**SD**(內建)、**SPI**(內建)。

---

## 九、完整逐 pin 接線表

> 焊接時對著這節看,每顆元件、每隻腳、每顆電阻、每條線都寫出來。
> 「→」=「接到」;**節點**=洞洞板上同一個焊點(可以是多隻腳共享)。
> 軌(GND / 3V3 / 5V)= 沿洞洞板邊邊那條粗線。

### 9.1 ESP32-S3 左側 22 隻 pin(由天線端往 USB 端)

| # | 絲印 | V2-A 用途 | 接到 |
|:--:|:--:|--|--|
| 1 | 3V3 | 3V3 輸出 | 3V3 軌 |
| 2 | 3V3 | 3V3 輸出 | 3V3 軌(同上,並聯) |
| 3 | RST | reset | 不接(板上 RST 鈕已夠) |
| 4 | 4 | **roll** | B 排線 #5 → 右搖桿 X 軸抽頭 |
| 5 | 5 | **SW_A** | B 排線 #6 → 模式開關 A 節點 |
| 6 | 6 | **SW_B** | B 排線 #7 → 模式開關 B 節點 |
| 7 | 7 | **MENU_BTN** | B 排線 #8 → 選單階梯節點 |
| 8 | 15 | **真正釋出可用** | 不接(原本想做 TFT LED PWM,2026-06-06 試燒驗證 LED 不能 PWM 控,改成直接接 3V3 軌)|
| 9 | 16 | **釋出**(原 TFT D5) | 同上 |
| 10 | 17 | **釋出**(原 TFT D6) | 同上 |
| 11 | 18 | **釋出**(原 TFT D7) | 同上 |
| 12 | 8 | **SHOULDER_L** | B 排線 #9 → 肩鍵 L 一腳 |
| 13 | 3 | 避開 | 不接 |
| 14 | 46 | ⚠️ strapping,避開 | **絕對不接**(N16R8 的 strapping 腳)|
| 15 | 9 | **SHOULDER_R** | B 排線 #10 → 肩鍵 R 一腳 |
| 16 | 10 | **右搖桿 VRy(pitch)** | A↔C 杜邦「pitch」→ B 排線 #5 → 右搖桿 Y 軸抽頭 |
| 17 | 11 | **V2-B I²S BCLK** | 給 INMP441 SCK + MAX98357A BCLK(共用) |
| 18 | 12 | **V2-B I²S WS/LRCLK** | 給 INMP441 WS + MAX98357A LRC(共用) |
| 19 | 13 | **V2-B I²S DOUT** | 給 MAX98357A DIN(ESP32→放大器) |
| 20 | 14 | **V2-B I²S DIN** | 給 INMP441 SD(麥克風→ESP32) |
| 21 | 5V | 5V 輸入 | 5V 軌(從 buck OUT+) |
| 22 | GND | GND | GND 軌 |

### 9.2 ESP32-S3 右側 22 隻 pin(由天線端往 USB 端)

| # | 絲印 | V2-A 用途 | 接到 |
|:--:|:--:|--|--|
| 1 | GND | GND | GND 軌 |
| 2 | TX(43) | UART0 debug TX | **保留**(V2-B 改用釋出腳 11~14,不犧牲 debug)|
| 3 | RX(44) | UART0 debug RX | **保留**(同上)|
| 4 | 1 | **THROTTLE** | B 排線 #3 → 左搖桿 Y 軸抽頭 |
| 5 | 2 | **左搖桿 X(可選 yaw)** | A↔C 杜邦「左 X」→ B 排線 #4 → 左搖桿 X 軸抽頭 |
| 6 | 42 | **NRF24 CSN** | NRF24 CSN(板內短線) |
| 7 | 41 | **NRF24 CE** | NRF24 CE(板內短線) |
| 8 | 40 | **SPI MISO** | NRF24 MISO + SD MISO(共用) |
| 9 | 39 | **SPI MOSI** | NRF24 MOSI + SD MOSI(共用) |
| 10 | 38 | **SPI SCK** | NRF24 SCK + SD SCK(共用) |
| 11 | 37 | ❌ OPI PSRAM 佔用 | **絕對不接**(N16R8 內部接 PSRAM,碰它 PSRAM 會掛)|
| 12 | 36 | ❌ OPI PSRAM 佔用 | **絕對不接** |
| 13 | 35 | ❌ OPI PSRAM 佔用 | **絕對不接** |
| 14 | 0 | **SD CS** | 經 R11 10kΩ 上拉 → 接 C 板上獨立 microSD 模組的 CS |
| 15 | 45 | 避開 | 不接 |
| 16 | 48 | **TFT CS** | 經 A↔C 杜邦 → C 板 → 副排線 #1 → B 板 TFT CS |
| 17 | 47 | **釋出**(原 TFT WR) | SPI 不用,可給 V2-B |
| 18 | 21 | **TFT DC** | 經 A↔C 杜邦 → C 板 → 副排線 #2 → B 板 TFT DC |
| 19 | 20 | native USB CDC debug | **保留**(V2-B 改用釋出腳,不犧牲)|
| 20 | 19 | native USB CDC debug | **保留**(同上)|
| 21 | GND | GND | GND 軌 |
| 22 | 3V3 | 3V3 輸出 | 3V3 軌 |

### 9.3 NRF24L01+PA/LNA(在 A 板上,排母可拔)

| NRF24 腳 | 接到 |
|--|--|
| VCC | 3V3 軌 |
| GND | GND 軌 |
| **100µF 電容** | 跨在 NRF24 的 VCC 腳 ↔ GND 腳之間(< 5mm) |
| 0.1µF 電容(選) | 同上位置,跟 100µF 並聯 |
| CE | S3 右 #7(GPIO 41) |
| CSN | S3 右 #6(GPIO 42) |
| SCK | S3 右 #10(GPIO 38) |
| MOSI | S3 右 #9(GPIO 39) |
| MISO | S3 右 #8(GPIO 40) |
| IRQ | 不接 |

### 9.4 buck 模組(在 A 板上)

| buck 腳 | 接到 |
|--|--|
| IN+ | 電源開關輸出端 |
| IN− | GND 軌(= 電池 −) |
| OUT+ | 5V 軌(經 0.1µF 對 GND 補一顆,選) |
| OUT− | GND 軌 |

### 9.5 電源(電池 + 開關)

| 元件腳 | 接到 |
|--|--|
| 電池接頭 紅(+) | 電源開關 一端 |
| 電池接頭 黑(−) | GND 軌(= buck IN−) |
| 電源開關 一端 | 電池 + |
| 電源開關 另一端 | buck IN+ |

### 9.6 TFT MSP2806(鎖在外殼前面板,**插 B 板的 1×14 母排座**)

> MSP2806 排針**單排 14 隻 2.54mm**,直接對齊 B 板洞洞板,免轉接小板。
> **訊號 6 條走副排線到 C 板**(CS / DC / SCK / MOSI / MISO / RESET);電源 VCC/GND/**LED 都接 B 板 3V3 軌**(LED 常亮)。

| MSP2806 排針 | 接到(B 板上) |
|--|--|
| **CS** | C↔B 副排線 #1(→ C 板 → A↔C 杜邦 → S3 GPIO 48) |
| **DC**(或 RS) | C↔B 副排線 #2(→ C 板 → A↔C 杜邦 → S3 GPIO 21) |
| **SCK** | C↔B 副排線 #3(→ C 板 SPI 分歧點 → 共用 SPI → S3 GPIO 38) |
| **SDI(MOSI)** | C↔B 副排線 #4(→ C 板 SPI 分歧點 → 共用 SPI → S3 GPIO 39) |
| **SDO(MISO)** | C↔B 副排線 #5(→ C 板 SPI 分歧點 → 共用 SPI → S3 GPIO 40;LovyanGFX init 用來讀 ID 確認晶片)|
| **RESET** | C↔B 副排線 #6(→ C 板 R10 10kΩ 上拉 → 3V3 軌;平常拉高 = 不重置)|
| **LED**(背光) | **B 板 3V3 軌**(直接接,常亮 100%;2026-06-06 試燒驗證 MSP2806 LED 不能 PWM)|
| **VCC** | **B 板 3V3 軌**(**用 3V3 跟訊號同位準才穩,不要接 5V**)|
| **GND** | **B 板 GND 軌** |
| T_CLK / T_CS / T_DIN / T_DO / T_IRQ | **不接**(MSP2806 無觸控) |

### 9.7 SD 卡(獨立 microSD 模組,放 C 板)

> **定案用獨立 microSD 模組**。MSP2806 內建的全尺寸 SD 座永遠空著別插卡(卡會凸出頂搖桿)。

| SD 模組腳 | 接到 |
|--|--|
| CS | S3 GPIO 0,**經 R11 10kΩ 上拉到 3V3** |
| SCK | GPIO 38(跟 NRF24/TFT 共用) |
| MOSI | GPIO 39(共用) |
| MISO | GPIO 40(共用) |
| VCC | C 板 3V3 軌 |
| GND | C 板 GND 軌 |

> 程式跟 MSP2806 內建版**完全相容**——對 ESP32 來說都只是一張接在 SPI 上的 SD。

### 9.8 左搖桿(B 板,油門 Y 拆彈簧、X 留彈簧當可選 yaw)

| 搖桿腳 | 接到 |
|--|--|
| VCC | 3V3 軌 |
| GND | GND 軌 |
| VRy(Y 軸抽頭) | B 排線 #3(→ S3 GPIO 1, throttle) |
| **VRx(X 軸抽頭)** | **B 排線 #4(→ S3 GPIO 2, 可選 yaw)** |
| SW(按下) | 不接 |

> Y 軸拆彈簧(油門要停留)、X 軸留彈簧(yaw 要自動回中);程式預設用肩鍵 yaw,選單切換到 X 才會讀。

### 9.9 右搖桿(B 板,pitch/roll)

| 搖桿腳 | 接到 |
|--|--|
| VCC | 3V3 軌 |
| GND | GND 軌 |
| VRy(Y 軸抽頭) | B 排線 #5(→ S3 GPIO 10, pitch) |
| VRx(X 軸抽頭) | B 排線 #6(→ S3 GPIO 4, roll) |
| SW(按下) | 不接 |

### 9.10 模式開關 A(B 板,MTS-103)

| 開關腳 | 接到 |
|--|--|
| 上腳(throw1) | 3V3 軌 |
| 中腳(common) | **「SW_A 節點」** |
| 下腳(throw2) | GND 軌 |

「SW_A 節點」還連:
- R6:10kΩ → 3V3 軌
- R7:10kΩ → GND 軌
- B 排線 #7(→ S3 GPIO 5)

### 9.11 模式開關 B(B 板,MTS-103)

| 開關腳 | 接到 |
|--|--|
| 上腳 | 3V3 軌 |
| 中腳(common) | **「SW_B 節點」** |
| 下腳 | GND 軌 |

「SW_B 節點」還連:
- R8:10kΩ → 3V3 軌
- R9:10kΩ → GND 軌
- B 排線 #8(→ S3 GPIO 6)

### 9.12 選單 4 鈕電阻階梯(B 板)

4 顆鈕**共用「選單節點」**,各自串聯不同電阻:

| 按鈕 | 接腳 1 | 接腳 2 | 串聯電阻 |
|--|--|--|--|
| ＋ | 3V3 軌 | R1:1kΩ → 選單節點 | R1 = 1kΩ |
| − | 3V3 軌 | R2:4.7kΩ → 選單節點 | R2 = 4.7kΩ |
| OK | 3V3 軌 | R3:10kΩ → 選單節點 | R3 = 10kΩ |
| 返回 | 3V3 軌 | R4:22kΩ → 選單節點 | R4 = 22kΩ |

「選單節點」(在 C 板)還連:
- R5:10kΩ → GND 軌(下拉,定義「都沒按」)
- **A↔C 杜邦「選單節點」線(→ S3 GPIO 7)**

> 流向:＋/−/OK/返回 各自從 B 板經 B 排線 #9~#12 → C 板上的 R1~R4 → 匯流到「選單節點」→ 再一條 A↔C 杜邦線回 A 板 GPIO 7。

### 9.13 肩鍵 L、R(實體鈕鎖外殼,線拉到 C 板)

| 肩鍵 | 腳 | 接到 |
|--|--|--|
| L | 一腳 | A↔C 杜邦線「肩 L」(→ S3 GPIO 8) |
| L | 另一腳 | C 板 GND 軌 |
| R | 一腳 | A↔C 杜邦線「肩 R」(→ S3 GPIO 9) |
| R | 另一腳 | C 板 GND 軌 |

> 肩鍵不在 B↔C 排線裡,從外殼直接拉短線進 C 板。預設用作 yaw 控制。

### 9.15 ⚠️ (歷史)A↔B 10 條排線——已不適用,僅供對照

> **舊版**(C 板架構出現前的「A 直連 B」版本)。
> 目前架構是 **A↔C 18 條杜邦 + C↔B 12 條排線**,請看 **〇節**「A↔C 板 18 條杜邦線」+「C↔B 板 12 條排線」兩張表。
> 此表保留只是讓你對照「以前長什麼樣 / 信號名對得起來」,**焊接時不要照這張**。

| #(芯) | 顏色建議 | A 板端 | B 板端 |
|:--:|--|--|--|
| 1 | 棕 | 3V3 軌 | 3V3 軌 |
| 2 | 紅 | GND 軌 | GND 軌 |
| 3 | 橙 | S3 GPIO 1(右#4) | 左搖桿 VRy |
| 4 | 黃 | S3 GPIO 2(右#5) | 左搖桿 VRx(可選 yaw) |
| 5 | 綠 | S3 GPIO 4(左#4) | 右搖桿 VRx |
| 6 | 藍 | S3 GPIO 5(左#5) | SW_A 節點 |
| 7 | 紫 | S3 GPIO 6(左#6) | SW_B 節點 |
| 8 | 灰 | S3 GPIO 7(左#7) | 選單節點 |
| 9 | 白 | S3 GPIO 8(左#12) | 肩鍵 L 一腳 |
| 10 | 黑 | S3 GPIO 9(左#15) | 肩鍵 R 一腳 |

> 兩端各寫個 ▲ 標記同一邊朝上,焊歪會把 3V3 接到 GND 燒板。

### 9.16 TFT MSP2806 在 B 板:訊號清單

> MSP2806 SPI 介面,**單排 14 隻排針插 B 板的母排座**(完全對齊 B 板洞洞板)。
> 訊號 **4 條走副排線到 C 板**(CS / DC / SCK / MOSI),其他從 B 板既有 3V3/GND 軌取。

| MSP2806 排針 | 接到(在 B 板上) | 走線 |
|--|--|--|
| **VCC** | B 板 3V3 軌(推薦)/ 5V 軌 | (B 板既有電源軌)|
| **GND** | B 板 GND 軌 | (同上)|
| **CS** | 副排線 #1 → C 板 → A 板 GPIO 48 | 副排線 |
| **RESET** | 副排線 #6 → C 板 R10 → 3V3 軌(經 10kΩ 上拉)| 副排線 |
| **DC** | 副排線 #2 → C 板 → A 板 GPIO 21 | 副排線 |
| **SDI(MOSI)** | 副排線 #4 → C 板 SPI 分歧點 → A 板 GPIO 39 | 副排線(共用 SPI)|
| **SCK** | 副排線 #3 → C 板 SPI 分歧點 → A 板 GPIO 38 | 副排線(共用 SPI)|
| **LED** | B 板 3V3 軌(直接接) | 常亮 100%(MSP2806 LED 內部沒接 VCC,需外接)|
| **SDO(MISO)** | 副排線 #5 → C 板 SPI 分歧點 → A 板 GPIO 40 | 副排線(共用 SPI;LovyanGFX init 讀 ID 用)|
| 板上 SD CS | **不接**(MSP2806 內建 SD 座不用,改走 C 板上的獨立 microSD 模組) | — |
| T_CLK / T_CS / T_DIN / T_DO / T_IRQ | **不接** | MSP2806 無觸控 |

> 訊號跟 A 板的連接走 **18 條杜邦線**(A↔C)+ **6 條副排線**(C↔B,TFT 專用)。
> 完整分組見〇節「A↔C 板 18 條杜邦線」+「C↔B 板 6 條副排線」兩張表。

### 9.17 全部電阻清單(11 顆,1/4W 金屬膜)

| 編號 | 阻值 | 一端 | 另一端 | 在哪片板 |
|:--:|:--:|--|--|--|
| R1 | 1kΩ | ＋鈕 一腳(經 B 排線 #8 過來) | 選單節點 | **C 板** |
| R2 | 4.7kΩ | −鈕 一腳(經 B 排線 #9) | 選單節點 | **C 板** |
| R3 | 10kΩ | OK 鈕 一腳(經 B 排線 #10) | 選單節點 | **C 板** |
| R4 | 22kΩ | 返回鈕 一腳(經 B 排線 #11) | 選單節點 | **C 板** |
| R5 | 10kΩ | 選單節點 | GND 軌 | **C 板**(下拉) |
| R6 | 10kΩ | SW_A 節點 | 3V3 軌 | **C 板** |
| R7 | 10kΩ | SW_A 節點 | GND 軌 | **C 板** |
| R8 | 10kΩ | SW_B 節點 | 3V3 軌 | **C 板** |
| R9 | 10kΩ | SW_B 節點 | GND 軌 | **C 板** |
| R10 | 10kΩ | TFT LCD_RST(從副排線 #6 進來)| 3V3 軌 | **C 板** |
| R11 | 10kΩ | S3 GPIO 0(SD CS,經 A↔C 杜邦線 SD_CS 那條) | 3V3 軌 | **C 板** |

**統計**:1kΩ ×1、4.7kΩ ×1、**10kΩ ×8**、22kΩ ×1 = **11 顆**

### 9.18 全部電容清單

| 電容 | 規格 | 兩端接 | 在哪片板 | 作用 |
|--|--|--|--|--|
| C1 | 100µF / ≥10V 電解 | NRF24 VCC ↔ GND | A 板(緊貼 NRF24) | 補發射尖峰,**不能省** |
| C2 | 0.1µF 陶瓷 | NRF24 VCC ↔ GND | A 板(跟 C1 並聯,選用) | 補高頻 |
| C3 | 0.1µF 陶瓷 | S3 VIN ↔ GND | A 板(緊貼 S3 電源腳,選用) | S3 高頻穩 |
| C4 | 0.1µF 陶瓷 | buck OUT+ ↔ GND | A 板(緊貼 buck 輸出,選用) | 補 buck 輸出 |

> C2/C3/C4 是「選用」——沒接也能跑,接了更穩。C1 是必接。

### 9.19 共享節點清單(同一個焊點要接多隻腳的)

| 節點名稱 | 位置 | 連到哪些 |
|--|--|--|
| 3V3 軌 | A 板頂邊 | S3 三個 3V3 腳、NRF24 VCC、兩顆搖桿 VCC、開關/階梯的 3V3 端,詳見下面 |
| 5V 軌 | A 板頂邊 | S3 5V 腳、TFT VCC、buck OUT+ |
| GND 軌 | A 板頂邊 | 所有元件的 GND |
| SW_A 節點 | **C 板** | R6 一端、R7 一端、B 排線 #7(從 SW_A common 來)、A↔C 杜邦「SW_A」(→ S3 GPIO 5) |
| SW_B 節點 | **C 板** | R8 一端、R9 一端、B 排線 #8(從 SW_B common 來)、A↔C 杜邦「SW_B」(→ S3 GPIO 6) |
| 選單節點 | **C 板** | R1~R4 一端、R5 一端、A↔C 杜邦「選單」(→ S3 GPIO 7) |

**3V3 軌實際連到**:
- S3 左 #1、#2(兩個 3V3)
- S3 右 #22(3V3)
- NRF24 VCC + 100µF 一端
- 經 A↔C 杜邦進 C 板 3V3 軌:
  - R6、R8(SW 上拉)
  - R10(TFT RESET 上拉,線從副排線 #6 進來)
  - R11(SD_CS 上拉)
- 經 C↔B 主排線進 B 板 3V3 軌:
  - 兩顆搖桿 VCC
  - MTS-103 A/B 各自上腳
  - 4 個選單鈕的 3V3 那腳
  - TFT VCC + LED(兩個都接 3V3 軌,LED 常亮)

> 看起來很多,實際就是「沿 A 板頂邊一條粗紅線,沿途分支接出去」。

---

**全部接線到此為止。** 焊每個焊點前對著這節找一次,焊完打勾。
