avav10985/flightflight/文件/程式說明.md

# 四軸無人機 飛控程式說明報告

> 專案：ESP32 (LOLIN D32) 四軸無人機
> 主控：LOLIN D32（ESP32-WROOM-32）
> 遙控：Arduino Nano + NRF24L01+PA/LNA

---

## 1. 概述

本專案的飛控程式採「**分階段開發**」設計，每個階段一支獨立程式，
功能由簡到繁逐步疊加。每通過一個階段的驗證，才進入下一支程式，
目的是讓除錯範圍縮小、避免一次堆太多功能找不到問題。

飛機端程式共 4 支（依階段）：

```
Gyro ──→ Manual ──→ PID ──→ Full
階段1     階段2      階段3    階段4
```

另有地面端發射器程式 1 支與多支感測器獨立測試程式。

---

## 2. 飛機端飛控程式

### 2.1 Drone_FC_Gyro（階段 1：感測器驗證）

| 項目 | 內容 |
|---|---|
| **目的** | 驗證 MPU6050 姿態感測器接線正確、讀數合理 |
| **硬體** | LOLIN D32 + MPU6050（I²C）|
| **功能** | 讀加速度計 + 陀螺儀、互補濾波算出 Roll/Pitch、序列埠輸出 |
| **不含** | NRF24、ESC、PID |

**用途說明：**
最基礎的程式，只做一件事——確認 MPU6050 能正確讀到姿態。
開機自動校正陀螺儀偏移，並用「互補濾波」融合加速度計與陀螺儀，
輸出 Roll（翻滾角）、Pitch（俯仰角）、Yaw 角速度。
此階段用來確認感測器軸向對齊與讀值正確。

---

### 2.2 Drone_FC_Manual（階段 2：手動油門）

| 項目 | 內容 |
|---|---|
| **目的** | 驗證無線通訊與 4 顆馬達接線、轉向 |
| **硬體** | 階段 1 + NRF24L01+PA/LNA + ESC × 4 |
| **功能** | 接收搖桿訊號、4 顆馬達「同油門」轉動、失聯保護 |
| **不含** | PID 自穩（所以**不會飛**）|

**用途說明：**
在感測器驗證後，加入無線遙控與動力。此版本 4 顆馬達**轉速相同**，
不做姿態修正，因此無法穩定飛行，僅用於驗證：
- NRF24 通訊正常（搖桿數值有傳到）
- 4 顆 ESC 接線正確
- 馬達轉向符合 X 型配置（對角同向、相鄰反向）

⚠️ 此階段**絕對不裝螺旋槳**。

---

### 2.3 Drone_FC_PID（階段 3：PID 自穩）★ 主力版本

| 項目 | 內容 |
|---|---|
| **目的** | 飛機能自我穩定、可實際飛行 |
| **硬體** | 同階段 2 |
| **功能** | PID 自穩、X 型馬達混控、序列埠即時調參、aux2 觸發校正 |

**用途說明：**
加入飛控核心——PID 控制器。透過比較「搖桿期望姿態」與
「MPU6050 實測姿態」，計算修正量並分配給 4 顆馬達，
使飛機保持水平或依搖桿傾斜。

**核心技術：**
- **Roll / Pitch**：角度模式 PID（搖桿給期望角度）
- **Yaw**：角速度模式 PID（無磁力計，只控旋轉速度）
- **X 型混控公式**：
  ```
  M1 (前左) = 油門 + pitch + roll - yaw
  M2 (前右) = 油門 + pitch - roll + yaw
  M3 (後左) = 油門 - pitch + roll + yaw
  M4 (後右) = 油門 - pitch - roll - yaw
  ```

**特色功能：**
- 開機自動校正陀螺儀偏移 + 水平基準
- 序列埠即時調 PID 參數（kp/ki/kd/ypp/yi），不必重燒
- **9 模式武裝邏輯**：mode 00=安全/校準（永遠 disarm）；可武裝白名單 `modeFlyable()` = **01 手動自穩、10 語音控制**；其餘模式拒武裝
- **開機 LOCK**：上電後必須先把模式開關切到 00 一次才解鎖，否則拒絕武裝
- **進入 mode 0 自動觸發陀螺儀校正**（取代舊的 aux2）
- 失聯 1 秒自動解除武裝
- **NRF24 雙向 ACK：回傳遙測（姿態/電量/武裝）給地面站**
- **可接收地面站傳來的 PID 參數，即時套用**
- **電池電壓監測（GPIO34 分壓）**

**已調定參數：** Kp=2.0、Ki=0.02、Kd=0.5（Roll/Pitch）、Kp_y=1.5、Ki_y=0.02（Yaw）

這是目前可實際試飛的版本。

---

### 2.4 Drone_FC_Full（階段 4：完整版）

| 項目 | 內容 |
|---|---|
| **目的** | 加入定位、定高、避障感測器，邁向自動飛行 |
| **硬體** | 階段 3 + BMP280 + GPS + VL53L0X |
| **功能** | PID 全部 + 三組感測器（旗標啟用）|

**用途說明：**
在 PID 自穩基礎上，加入三組進階感測器，用 `ENABLE_xxx` 旗標
逐個啟用（接好哪個就開哪個），避免未接的感測器卡住程式：

```cpp
#define ENABLE_BMP280   0   // 氣壓計（定高）
#define ENABLE_GPS      0   // GPS（定位、自動飛行）
#define ENABLE_VL53L0X  0   // 雷射測距（避障）
```

**三組感測器用途：**
| 感測器 | 介面 | 未來功能 |
|---|---|---|
| BMP280 | I²C | 自動維持高度 |
| GY-NEO6MV2 GPS | UART | 飛到指定座標、自動返航 |
| VL53L0X × 2 | I²C（透過 TCA9548A）| 前後障礙偵測、自動煞車 |

目前感測器只讀值、印序列埠，**尚未整合進飛行控制邏輯**
（定高、導航、避障為後續開發）。

---

## 3. 地面端程式

地面端有兩個版本：簡易的 Nano 版（備援）與功能完整的 ESP32 版。

### 3.1 Ground_TX（Nano 版，備援）

| 項目 | 內容 |
|---|---|
| **硬體** | Arduino Nano + NRF24L01+PA/LNA + 雙搖桿 + 開關 |
| **功能** | 讀搖桿、打包指令、單向發送給飛機 |

沿用原本 6 通道發射器電路，**佈局已從固定翼改成四軸 Mode 2**
（左搖桿 油門+yaw、右搖桿 pitch+roll）。
程式頂端有 `REV_xxx` 方向反轉設定，測試後不對就改 true/false。
NRF24 設定與飛機端一致（pipe `0xABCDABCD71`、channel 88、250kbps）。※ 原寫 channel 100 與飛機不符;此 Nano 版原始碼已於 2026-07 清理時移出 repo。

### 3.2 Ground_TX_ESP32（V2-A：ESP32-S3 + MAR2406 彩色 TFT）★

> **V1 已跳過**（原本的 30-pin WROOM + 2004A LCD 不做了），直接做 V2-A。
> 規劃文件：`手把V2_討論摘要.md`、`手把接線總表_V2.md`。
> 舊文件（`手把系統規格.md`、`手把接線總表.md`）保留供參考但**不對應實作**。

| 項目 | 內容 |
|---|---|
| **硬體** | ESP32-S3-N16R8 + MAR2406 並列 8-bit TFT 320×240 + 雙搖桿（油門拆彈簧）+ 3 段開關 × 2 + 肩鍵 × 2 + 選單鈕 × 4 + NRF24 + SD 卡 |
| **功能** | 9 模式控制 + 肩鍵 yaw + 彩色 TFT 遙測 + 手把上 PID 選單調參 + SD（V2-A 只 mount） |

**用途說明：**
V2-A 是完整地面站。除了發送指令，還能：
- **TFT 彩色顯示**（模式名稱、姿態、武裝狀態、電量、連線、SD）；未定義模式顯示「保留」
- **9 模式**：兩個 3 段開關組合 `mode = A×10 + B` 兩位數編碼（00=安全校準、01=手動自穩、02=GPS導航、10=語音控制、11=電腦控制、12/20/21/22=保留）
- **肩鍵 yaw**：L/R 肩鍵按著＝固定 ±60°/s 原地旋轉
- **選單系統**：只在 mode 0 按「OK」進入，4 個電阻階梯鈕（＋/−/OK/Back）調 PID，
  改完即時透過 NRF24 傳給飛機
- **開機安全**：飛機端上電 LOCKED，須先切到 mode 00 解鎖（飛機端邏輯）
- NRF24 雙向 ACK Payload（送指令同時收遙測）
- **NRF24 與 SD 卡共用 SPI**（CS 各自獨立）

**接腳：**
| 功能 | GPIO |
|---|---|
| 油門（左上下，無彈簧）/ pitch / roll | 1 / 2 / 4（ADC1）|
| 模式開關 A / B（3 段，ADC 三階） | 5 / 6 |
| 選單鈕 ＋/−/OK/Back（電阻階梯） | 7 |
| 肩鍵 L / R（yaw，數位 PULLUP） | 8 / 9 |
| TFT 並列 D0~D7 / RS / WR / CS | 11~18 / 21 / 47 / 48（RST/RD 接 3V3）|
| NRF24 + SD（共用 SPI） | SCK=38 MOSI=39 MISO=40；NRF CE=41 CSN=42；SD CS=0 |

**函式庫**：LovyanGFX（per-sketch config，免改 library 檔）、RF24、SD、SPI。

**V2-B（之後）**：加 INMP441 麥克風 + MAX98357A 放大 + 喇叭做語音 I/O，需犧牲一條 debug 序列埠釋出 I²S 腳。

---

## 4. 感測器獨立測試程式

開發過程中，每個感測器先用獨立程式驗證「沒壞、接線對」，
再整合進飛控。這些程式燒在不同板子上：

| 程式 | 測試對象 | 燒在哪 |
|---|---|---|
| **BMP280_Test** | BMP280 氣壓計 | LOLIN D32 |
| **GPS_Test** | GY-NEO6MV2 GPS（含衛星 SNR + 藍牙輸出）| LOLIN D32 |
| **ESP32CAM_Test** | ESP32-CAM 相機（AP 模式）| ESP32-CAM |
| **ESP32CAM_Flight** | ESP32-CAM 飛行版（Station 模式 + 即時調畫質）| ESP32-CAM |

---

## 5. 系統架構

```
┌─────────────── 無人機 ───────────────┐
│  LOLIN D32（飛控）                    │
│   ├ MPU6050（姿態）                   │
│   ├ BMP280（氣壓，預留）              │
│   ├ GPS（定位，預留）                 │
│   ├ VL53L0X × 2（避障，預留）         │
│   ├ 電池監測（GPIO34 分壓）           │
│   ├ NRF24（雙向：收指令 + 回傳遙測）  │
│   └ ESC × 4 → 無刷馬達 × 4            │
│                                       │
│  ESP32-CAM（影像，獨立 WiFi）         │
└───────────────────────────────────────┘
   ▲ 2.4G NRF24（雙向）    ▲ WiFi
   │                       │
┌──┴──────────────────────────┐   ┌┴────────────┐
│ ESP32-S3 地面站（V2-A）      │   │  電腦/手機  │
│ + 雙搖桿（油門拆彈簧）       │   │  看影像/AI  │
│ + 9 模式開關 + 肩鍵 yaw      │   └─────────────┘
│ + MAR2406 並列彩色 TFT       │
│ + NRF24 + SD + PID 選單      │
└──────────────────────────────┘
```

接線圖：`drone_wiring2.png`（飛機端）、`ground_wiring.png`（地面站）

---

## 6. 開發進度

| 階段 | 程式 | 狀態 |
|---|---|---|
| 1 | Drone_FC_Gyro | ✅ 完成（感測器驗證）|
| 2 | Drone_FC_Manual | ✅ 完成（通訊 + 馬達）|
| 3 | Drone_FC_PID | ✅ PID 調定 + 雙向遙測，待試飛 |
| 4 | Drone_FC_Full | ⏳ 感測器整合中 |
| — | Ground_TX_ESP32 | ✅ V2-A 程式完成（S3 + MAR2406 TFT），待接線測試 |
| — | BMP280 | ✅ 測試正常 |
| — | GPS | ⏳ 測試中（戶外衛星數待提升）|
| — | ESP32-CAM | ✅ 影像 OK + 即時調畫質 |

---

## 7. 後續開發方向

1. **拘束測試 + 首飛**：用 Drone_FC_PID，裝螺旋槳做繩綁測試後試飛
2. **地面站接線測試**：ESP32 + 搖桿 + LCD + NRF24，確認雙向遙測顯示
3. **感測器整合**：BMP280 定高、GPS 自動導航、VL53L0X 避障
4. **影像 + AI**：ESP32-CAM 串流到電腦，YOLO 物體辨識
5. **語音控制**：電腦端 Whisper 語音 → 指令（或手把 ESP32-S3）

---

*本報告隨開發進度更新。最新程式碼見專案各資料夾。*
