avav10985/flightflight/文件/進度.md

# 四軸無人機 + 多功能手把 進度確認表

> 單一進度來源(高層級)。詳細決策日誌看 `對話紀錄/`。
> 三欄定義:
> - **程式** = 對應程式碼寫好(能編譯燒錄)
> - **硬體** = 該模組實體接線/焊接完成
> - **實測** = 接好後實際通電、行為驗證通過
>
> 符號:✅ 完成 ｜ ⏳ 進行中 ｜ ❓ 待確認 ｜ ☐ 未做 ｜ — 不適用
>
> **最後更新:2026-06-14**

---

## 1. 飛機端飛控(Drone_FC_Full,主力,LOLIN D32)

| 項目 | 程式 | 硬體 | 實測 | 備註 |
|---|:--:|:--:|:--:|---|
| MPU6050 姿態 + 互補濾波 | ✅ | ✅ | ✅ | 0.98/0.02 融合 |
| NRF24 雙向通訊 + ACK 遙測 | ✅ | ✅ | ✅ | CH88,姿態/高度/航向/GPS 回傳 |
| ESC × 4 動力 + X 型混控 | ✅ | ✅ | ✅ | 轉向校正完成 |
| 三軸 PID 自穩 | ✅ | ✅ | ⏳ | 程式 OK;穩定飛行調校未完成 |
| 武裝安全鏈(開機 LOCK / 白名單 / 油門 / 失聯)| ✅ | — | ✅ | 失聯 1 秒 disarm |
| IMU 校準(快速/完整 + 動作偵測拒寫)| ✅ | ✅ | ✅ | NVS 持久化 |
| 懸停水平自學習 | ✅ | — | ⏳ | 需穩定懸停才驗得到 |
| 線上 PID 調參(NVS 保存)| ✅ | ✅ | ✅ | 手把選單即時調 |
| QMC5883 磁力計(航向)| ✅ | ✅ | ❓ | 自動偵測 3 種晶片 |
| 語音單馬達 demo(mode 10 paramID 110/111)| ✅ | ✅ | ☐ | 待接飛機實測(之前手邊無機) |

## 2. 地面站手把(Ground_TX_ESP32,ESP32-S3 N16R8)

| 項目 | 程式 | 硬體 | 實測 | 備註 |
|---|:--:|:--:|:--:|---|
| 雙搖桿 + 肩鍵 yaw + 模式開關 + 按鍵叢 | ✅ | ✅ | ✅ | |
| **MSP2806 2.8" SPI TFT**(ILI9341)| ✅ | ✅ | ✅ | LovyanGFX,中文;非舊版 MAR2406 |
| NRF24 雙向(SPI2:38/39/40,CE41/CSN42)| ✅ | ✅ | ✅ | |
| SD 卡(獨立 SPI3:15/17/47/0)| ✅ | ✅ | ✅ | level shifter 搶 bus 已解 |
| PID 調參選單 | ✅ | ✅ | ✅ | |
| **Mode 10 語音控制**(雲端 Whisper+Llama)| ✅ | ✅ | ✅ | 辨識通;雙核心不卡控制迴圈 |
| Mode 10 語音回應(預錄 WAV)| ✅ | ✅ | ✅ | 喇叭唸確認句 |
| **Mode 12 媒體**(SD 影片 MJPEG + 音樂)| ✅ | ✅ | ✅ | 含選單/音量/暫停 |
| **Mode 22 WiFi 環境掃描**(被動)| ✅ | ✅ | ☐ | 剛完成,待燒測 |

## 3. 進階感測器(飛機端)

| 項目 | 程式 | 硬體 | 實測 | 備註 |
|---|:--:|:--:|:--:|---|
| BMP280 氣壓計 | ✅ | ✅ | ✅ | 驅動 OK,定高 PID 未整合 |
| GPS GY-NEO6MV2 | ✅ | ✅ | ⏳ | 戶外鎖星待驗(下雨收不到) |
| TCA9548A I²C 多工器 | ✅ | ✅ | ✅ | |
| VL53L0X × 4 雷射 | ☐ | ✅ | ☐ | **硬體已全裝**,避障邏輯待寫 |
| Mode 02 GPS 導航 | ⏳ | — | ☐ | 數學+狀態機完成,待接 PID |

## 4. 電源(手把,雙 LDO 架構)

| 項目 | 程式 | 硬體 | 實測 | 備註 |
|---|:--:|:--:|:--:|---|
| 2S 電池 → buck 5V | — | ✅ | ✅ | |
| 板載 AMS1117(晶片軌)| — | ✅ | ✅ | WiFi brown-out 已解 |
| 外掛 LD1117(周邊軌)+ 100µF | — | ✅ | ✅ | TFT/NRF24/麥克風 |
| USB / 電池互斥規則 | — | — | ✅ | 燒寫拔電池、飛行拔 USB |

## 5. 語音 / 影像

| 項目 | 程式 | 硬體 | 實測 | 備註 |
|---|:--:|:--:|:--:|---|
| INMP441 麥克風(I²S)| ✅ | ✅ | ✅ | |
| MAX98357A 喇叭(I²S)| ✅ | ✅ | ✅ | 開機靜音消雜訊 |
| ESP32-CAM 串流 | ✅ | ✅ | ✅ | AP 模式 192.168.4.1 |

## 6. 遊戲模擬器(手把當掌機)

| 項目 | 程式 | 硬體 | 實測 | 備註 |
|---|:--:|:--:|:--:|---|
| NES_Test(arduino-nofrendo)| ✅ | ✅ | ✅ | 單獨 NES,Arduino |
| **Retro-Go 全主機**(NES/GB/GBC/SMS/GG)| ✅ | ✅ | ✅ | ESP-IDF,神奇寶貝實測 OK |
| └ 自訂 target + 編譯 + 燒錄 | ✅ | — | ✅ | 畫面方向已喬正(MADCTL 0x08)|

## 7. 報告 / 文件

| 項目 | 狀態 | 備註 |
|---|:--:|---|
| 技術報告網站(GitHub Pages)| ✅ | 6 章 + 互動圖 + 實機照片影片 + QR |
| README | ✅ | repo 首頁 |
| 接線總表 / 程式說明 | ✅ | |

---

## 8. 整機里程碑(飛行向,照順序)

- ☐ **拘束測試**:綁桿裝槳,調 PID(不自由飛)
- ☐ 室內手動懸停
- ☐ 戶外首飛
- ☐ Mode 02 GPS 導航閉環
- ☐ BMP280 定高整合
- ☐ VL53L0X × 4 避障整合
- ☐ 語音→飛行完整映射(現為單馬達 demo,程式已備)

## 9. 未來大版本

- **ESP-SR 本地離線語音**(取代雲端,免 WiFi/限流)
- **手把 v3**:Pi 主控 + ESP32 協處理器雙腦、物件導向,趨近 Linux 掌上電腦(報告後)

---

> 更新方式:做完一項改符號,或跟 Claude 說「XX 完成了」幫你改。
