avav10985/flightflight/docs/media/drone-serial.png

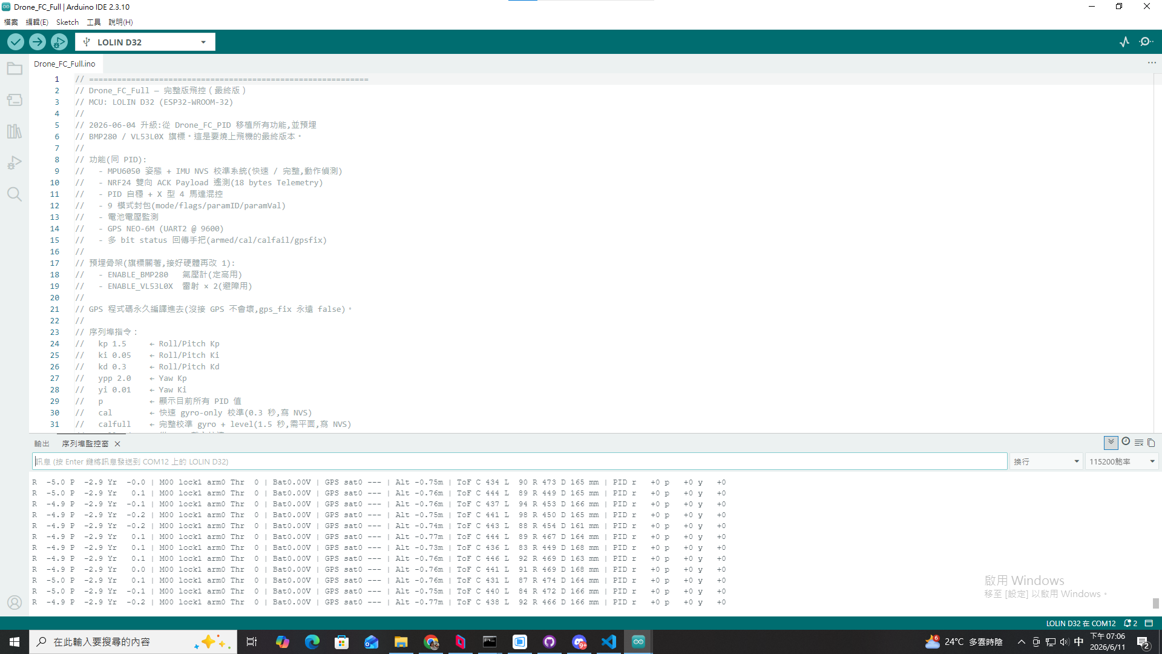
docs/media/drone-serial.png
