avav10985/flightflight/docs/media/drone-top.jpg

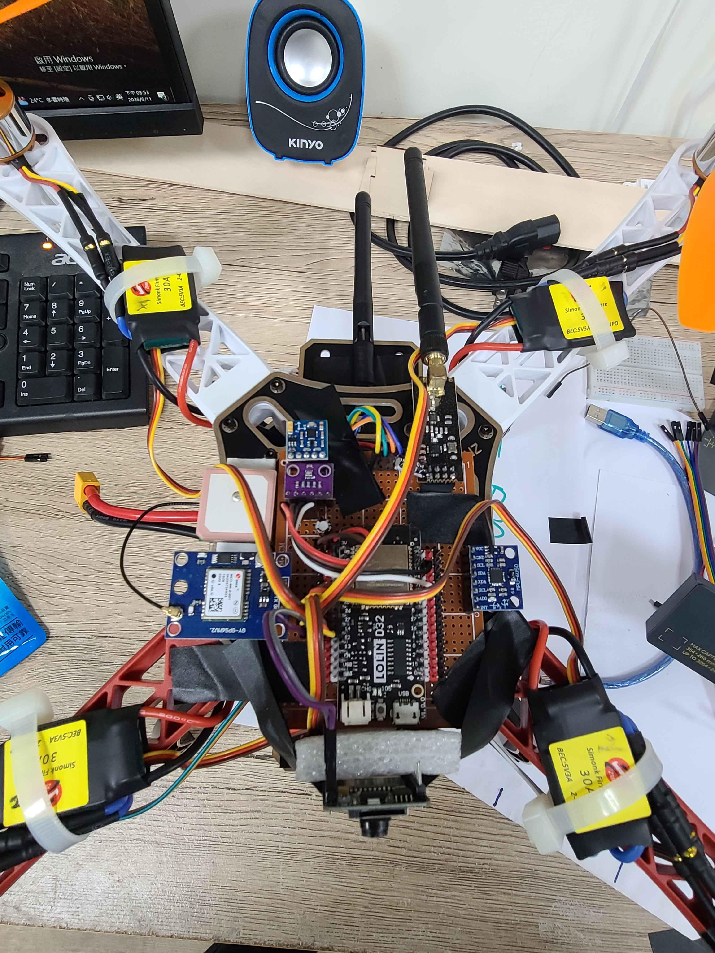
docs/media/drone-top.jpg
