avav10985/flightflight/docs/media/handle-front.jpg

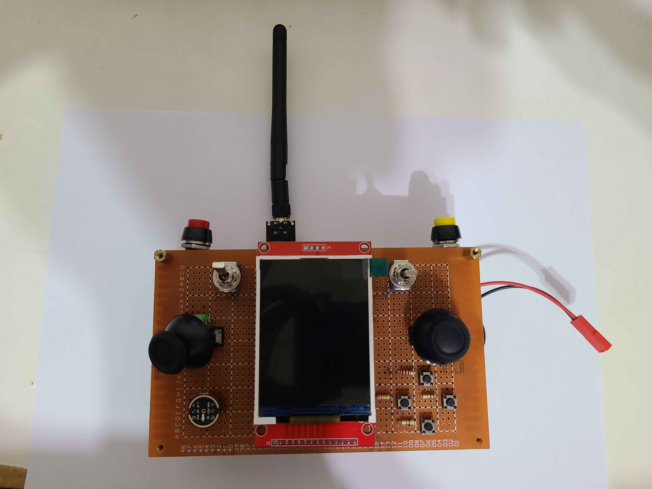
docs/media/handle-front.jpg
