avav10985/flightflight/docs/media/mode00.jpg

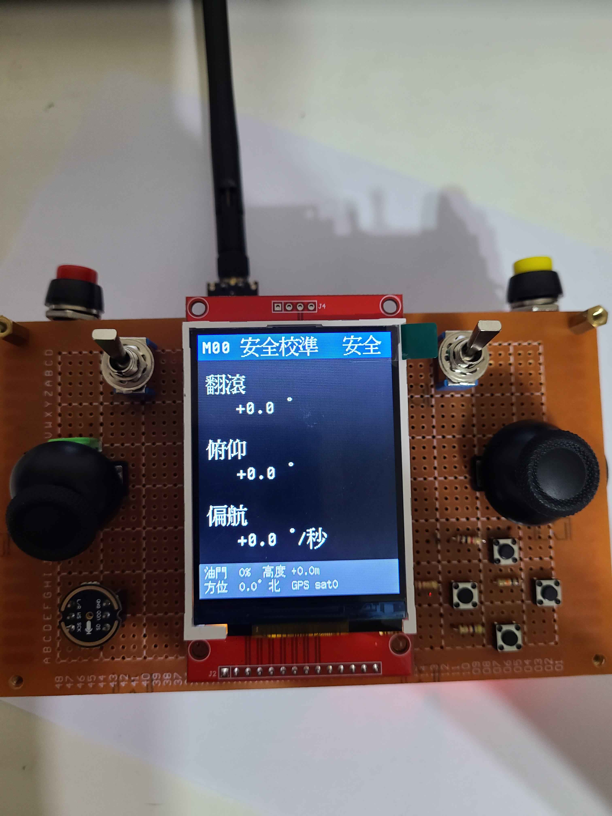
docs/media/mode00.jpg
