avav10985/flightflight/docs/media/mode01.jpg

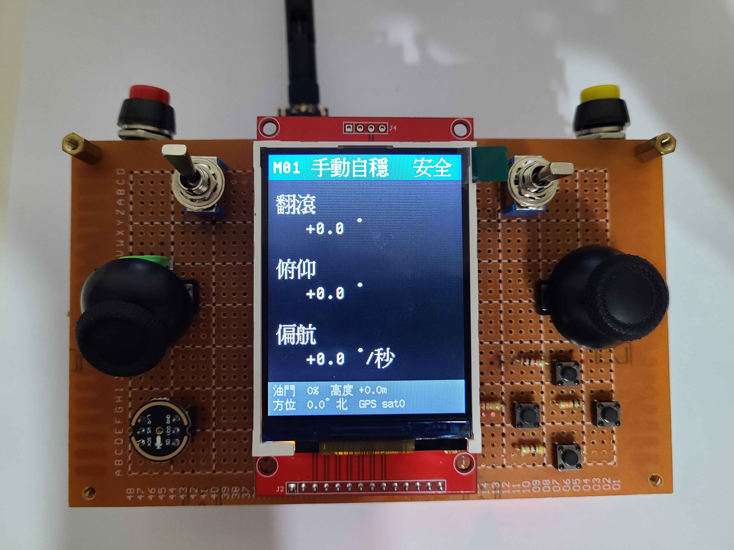
docs/media/mode01.jpg
