avav10985/flightflight/docs/media/pid-menu.jpg

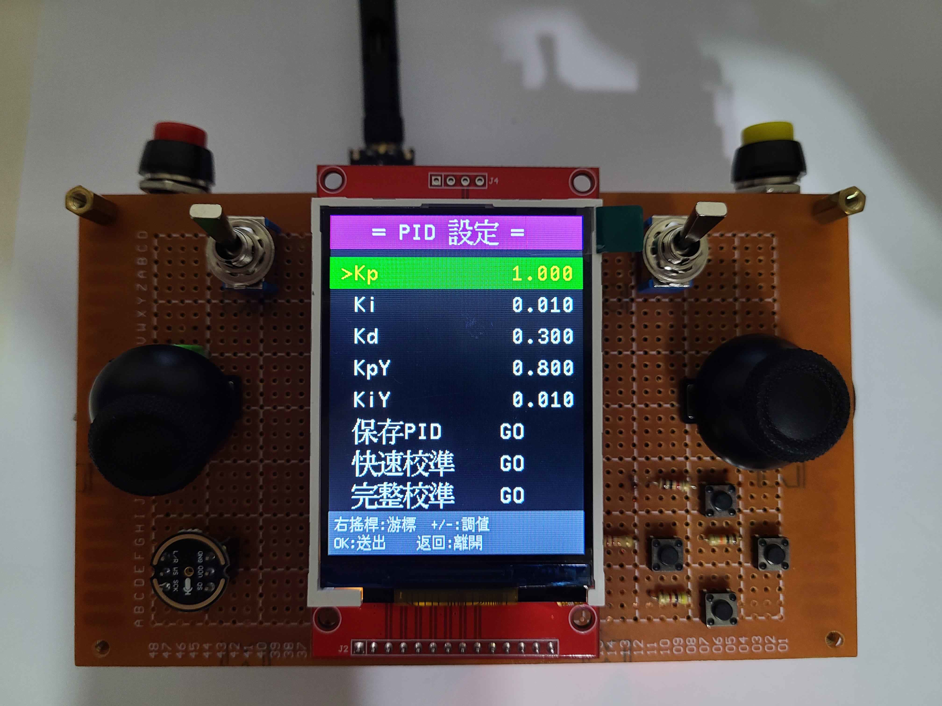
docs/media/pid-menu.jpg
