avav10985/flightflight/docs/qr.png

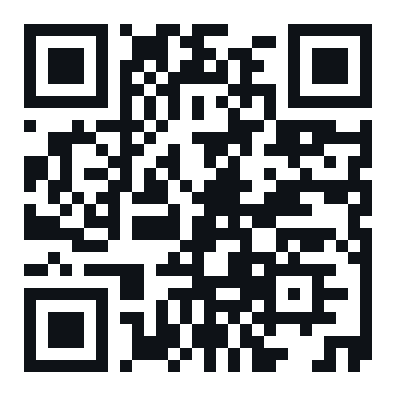
docs/qr.png
