avav10985/flightflight/Ground_TX_ESP32/Ground_TX_ESP32.ino

// ============================================================
// 地面站發射器 V2-A:ESP32-S3-N16R8 + MSP2806 2.8" SPI TFT(直立)
//
// 功能:
//   - 油門(左搖桿上下,拆彈簧)/ pitch / roll
//   - yaw 由肩鍵 L / R(按著 = 固定 ±60°/s)
//   - 兩個 3 段開關組 9 模式,**mode = A×10 + B 兩位數編碼**:
//     00=安全/校準、01=手動、02=GPS、10=語音、11=PC、12/20/21/22=預留
//   - NRF24 雙向 ACK(送指令 + 收遙測)
//   - MSP2806 2.8" SPI ILI9341 TFT 240×320 直立顯示模式/姿態/狀態
//     (跟 NRF24/SD 共用 SPI 匯流排,只佔 CS=48 + DC=21 兩隻獨立腳)
//   - mode 0 按「OK」進選單,4 鈕電阻階梯調 PID
//   - SD 卡與 NRF24 共用 SPI(V2-A 只 mount,未寫入)
//
// 硬體接線見 手把接線總表_V2.md。
//
// 開發板:ESP32S3 Dev Module;USB CDC On Boot=Enabled;
//          Flash=16MB;PSRAM=OPI PSRAM;Partition=16M with OTA。
//
// 函式庫:LovyanGFX(per-sketch config,下面 LGFX class)、RF24、SD、SPI。
//
// 飛機端 Drone_FC_PID 已改成新封包(mode/flags/paramID/paramVal),
// 兩端必須同時重燒,封包對不上會收到亂碼。
//
// V2-A 變更歷程:
//   - 原本用 MAR2406 並列 8-bit TFT,佔 11 隻 GPIO
//   - 2026-06-02 換成 MSP2806 SPI TFT,只佔 2 隻 + 共用 SPI,省 9 隻
//     GPIO 11~18 全部釋出給 V2-B 或其他擴充
// ============================================================

#include <SPI.h>
#include <RF24.h>
#include <SD.h>
#include <driver/i2s_std.h>   // 音樂播放 I²S TX(ENABLE_MUSIC)
#define LGFX_USE_V1
#include <LovyanGFX.hpp>

// ============================================================
// LovyanGFX：MSP2806 2.8" SPI ILI9341
// 配置照 tyty/tyty.ino 試燒成功的設定為基準,只改我們共用 SPI 必要的部分
// 直立 240×320
// ============================================================
class LGFX : public lgfx::LGFX_Device {
  lgfx::Bus_SPI       _bus_instance;
  lgfx::Panel_ILI9341 _panel_instance;
public:
  LGFX() {
    {
      auto cfg = _bus_instance.config();
      cfg.spi_host    = SPI2_HOST;
      cfg.spi_mode    = 0;
      cfg.freq_write  = 40000000;
      cfg.freq_read   = 16000000;
      cfg.pin_sclk    = 38;                // 跟 NRF24/SD 共用(設計如此)
      cfg.pin_mosi    = 39;                // 同上
      cfg.pin_miso    = 40;                // 跟 SD 共用 SPI 必須設 40,否則 SD 拿不到 MISO 掛載失敗
      cfg.pin_dc      = 21;
      _bus_instance.config(cfg);
      _panel_instance.setBus(&_bus_instance);
    }
    {
      auto cfg = _panel_instance.config();
      cfg.pin_cs        = 48;
      cfg.pin_rst       = 16;              // GPIO 16 主動驅動(同 tyty,沒上拉電阻)
      cfg.pin_busy      = -1;
      cfg.memory_width  = 240;
      cfg.memory_height = 320;
      cfg.panel_width   = 240;
      cfg.panel_height  = 320;
      cfg.readable      = false;
      cfg.invert        = false;
      cfg.rgb_order     = false;
      cfg.dlen_16bit    = false;
      cfg.bus_shared    = true;            // ★ 跟 NRF24/SD 共用 SPI 必開(tyty 是 false 因獨立)
      _panel_instance.config(cfg);
    }
    setPanel(&_panel_instance);
  }
};
LGFX tft;

// ---- 腳位（V2-A 已定案,見 手把接線總表_V2.md）----
// 2026-06-04 GPIO 2 ↔ 10 對調:左搖桿訊號集中右側、右搖桿集中左側
// 2026-06-07 試燒實測:使用者只接了油門(GPIO 1)+ 右搖桿 Y(GPIO 4)
//   GPIO 2(左 X)、GPIO 10(右 X) 兩條線還沒接
//   把 J_PITCH 改到 GPIO 4(有訊號),J_ROLL 留 GPIO 10(以後接 右 X 才動)
#define J_THROTTLE   1    // 左搖桿 Y(油門,拆彈簧)— ✅ 已接
#define J_LEFT_X     2    // 左搖桿 X(可選 yaw)— ❌ 還沒接
#define J_PITCH      4    // 右搖桿 Y(俯仰)— ✅ 已接(從 GPIO 10 對調過來)
#define J_ROLL      10    // 右搖桿 X(翻滾)— ❌ 還沒接(從 GPIO 4 對調過來)
#define SW_A         5
#define SW_B         6
#define MENU_BTN     7
#define SHOULDER_L   8
#define SHOULDER_R   9

// TFT LED:MSP2806 的 LED 腳沒內接 VCC,**直接外接 B 板 3V3 軌常亮**(不走 GPIO/PWM)
// GPIO 15 因此回歸「真正釋出」可用腳
#define PIN_NRF_CE   41
#define PIN_NRF_CSN  42
#define PIN_SPI_SCK  38
#define PIN_SPI_MOSI 39
#define PIN_SPI_MISO 40
// SD 卡:獨立第二組 SPI(SPI3/HSPI),跟 NRF24/TFT 的 bus 完全分開。
// 2026-06-12 實測:SD 模組 level shifter 在共用 bus 上不放開 MISO,
// 連新電源架構也救不了 → 搬到專用腳位,讓它佔自己的線。
// MISO 曾誤選 GPIO 3(接線總表標「避開」,實測也失敗),改用 47;
// CS 回歸接線總表原始設計 GPIO 0(BOOT 腳輸出閒置 HIGH 安全,R11 上拉)
#define PIN_SD_CS    0   // SD CS(原始設計,R11 10k 上拉)
#define PIN_SD_SCK  15   // SD 專用 SCK(真正釋出腳)
#define PIN_SD_MOSI 17   // SD 專用 MOSI(真正釋出腳)
#define PIN_SD_MISO 47   // SD 專用 MISO(原 CS 腳讓出來)

// ====== V2-B 跟其他 feature 旗標(2026-06-06)======
// 硬體 / API key 齊全才改 1,**程式編譯時不會占用太多 flash**
#define ENABLE_PC_MODE11        0   // Mode 11:PC 透過 USB Serial 控制飛機(透明橋接)
#define ENABLE_VOICE_MODE10     1   // Mode 10:語音控制(需 secrets.h + WiFi 熱點,2026-06-12 開)
#define ENABLE_MUSIC            1   // 任意 mode 都可放音樂(需 SD + MAX98357A,2026-06-12 開)
#define ENABLE_VIDEO_MODE12     1   // Mode 12:媒體模式,SD /video/*.mjp 影片播放
                                    // (需 ENABLE_MUSIC=1 共用 I²S + JPEGDEC 函式庫)
#define ENABLE_WIFI_SCAN_MODE22 1   // Mode 22:WiFi 環境掃描(被動,列附近 AP 訊號/通道)
#define ENABLE_PERSISTENT_MENU  0   // TFT 下方常駐選單(肩鍵 L 長按 1 秒進入)
#define ENABLE_SD               1   // SD 卡模組:1 = 啟用(2026-06-11 新電源架構後重測。
                                    // 2026-06-09 曾因模組 level shifter 搶 SPI bus 拖爆 NRF24 停用;
                                    // 若 chip connected 變 NO 或飛機連不上,改回 0)
#define PIN_I2S_BCLK   11           // V2-B 語音模組腳位(共用 INMP441 + MAX98357A)
#define PIN_I2S_WS     12
#define PIN_I2S_DOUT   13           // → MAX98357A DIN
#define PIN_I2S_DIN    14           // INMP441 SD →
#define PIN_AMP_SD     18           // MAX98357A SD(shutdown):LOW=休眠靜音、HIGH=啟用
                                    // 預設拉低消除「沙沙」雜訊,Mode 10 / 音樂 要播放時設 HIGH

#if ENABLE_VIDEO_MODE12
#include <JPEGDEC.h>                // Library Manager 搜 JPEGDEC(Larry Bank)
#if !ENABLE_MUSIC
#error "ENABLE_VIDEO_MODE12 需要 ENABLE_MUSIC=1(共用 I2S TX 通道)"
#endif
void enterVideoMode();
void exitVideoMode();
void videoModeLoop(int btnEdge);
#endif

#if ENABLE_VOICE_MODE10
#include <esp_task_wdt.h>
#include <WiFi.h>
#include <WiFiClientSecure.h>
#include "secrets.h"                // WIFI_SSID / WIFI_PASS / GROQ_API_KEY(gitignore 擋住)
#if !ENABLE_MUSIC
#error "ENABLE_VOICE_MODE10 需要 ENABLE_MUSIC=1(I2S 全雙工共用時脈)"
#endif
void enterVoiceMode();
void exitVoiceMode();
void voiceModeUi();
void applyVoiceOverride();
void voiceTask(void* arg);

// ---- 主迴圈(核心1)↔ 語音 task(核心0)共享變數,單寫者原則 ----
volatile bool    g_vMode10 = false;  // 主迴圈寫:目前在 mode 10
volatile bool    g_vPTT    = false;  // 主迴圈寫:左肩鈕按住中
volatile uint8_t g_vAction = 0;      // task 寫:0無 1takeoff 2land 3stop 4move
volatile int8_t  g_vDirX = 0, g_vDirY = 0, g_vDirZ = 0;   // move 方向(roll/pitch/throttle)
volatile uint8_t g_vDur  = 0;        // move 秒數
volatile uint8_t g_vMotor = 1;       // spin 動作:轉哪顆馬達(1~4)
volatile uint8_t g_vSpeak = 0;       // 語音回應:0無 1起飛 2降落 3停 4~7馬達1-4 8聽不懂
volatile bool    g_vFresh = false;   // task 寫 true → 主迴圈消化後寫 false
char             g_vStatus[48] = "開機中";   // task 寫狀態字串(主迴圈顯示)

#define VREC_RATE     32000          // I²S 實際取樣(跟音樂共用時脈,不能改)
#define VREC_WAV_RATE 16000          // 上傳取樣率:2:1 降採樣,檔小一半傳更快
#define VREC_MAXSEC   8
#define VREC_MAXSAMP  (VREC_WAV_RATE * VREC_MAXSEC)
int16_t* vRecBuf   = nullptr;        // PSRAM 錄音緩衝(setup 配置)
uint32_t vRecCount = 0;
#endif

// ---- 方向反轉（測試後不對就改）----
const bool REV_THROTTLE = true;
const bool REV_PITCH    = true;
const bool REV_ROLL     = true;
// yaw 方向若相反，把 SHOULDER_L / SHOULDER_R 兩腳對調即可

// ---- NRF24 ----
// 2026-06-07 換新 pipe + channel(跟 Drone_FC_Full PIPE_IN 必須一致)
const uint64_t PIPE_OUT    = 0x4E6F9C2D5BLL;
const uint8_t  NRF_CHANNEL = 88;

RF24 radio(PIN_NRF_CE, PIN_NRF_CSN);

// ---- 通訊結構（與飛機端一致）----
// mode 兩位數編碼,9 個值:00/01/02/10/11/12/20/21/22(見上面 header)
struct Signal {
  byte throttle, pitch, roll, yaw;
  byte mode;        // SW_A×10 + SW_B(各 0/1/2),例:01=A上+B中
  byte flags;       // bit0=完整校準觸發
  byte paramID;     // 0=無、1=Kp、2=Ki、3=Kd、4=Kp_y、5=Ki_y
  float paramVal;
};

// 飛機 → 手把(NRF24 ACK Payload,**必須跟飛機端 Telemetry struct 完全一致**)
// 2026-06-09 移除 battery_mV(使用者沒裝),改放 altitude + heading
struct Telemetry {
  int16_t  roll;        // 角度 ×10
  int16_t  pitch;       // 角度 ×10
  int16_t  yawRate;     // 角速度 ×10°/s
  int16_t  altitude_dm; // 相對高度 ×10(decimeter,範圍 ±3276.7m)
  int16_t  heading;     // 機頭方位 ×10(0~3599,0=北 900=東 1800=南 2700=西)
  uint8_t  status;      // 多 bit:見下面 STATUS_*
  uint8_t  satCount;    // GPS 衛星數
  int32_t  lat_e7;      // 緯度 ×10^7
  int32_t  lon_e7;      // 經度 ×10^7
  // 2026-06-18 飛機回傳目前 PID(各 ×1000),開機同步顯示 + 存檔確認
  int16_t  kp_rp_m;     // Kp_rp × 1000
  int16_t  ki_rp_m;     // Ki_rp × 1000
  int16_t  kd_rp_m;     // Kd_rp × 1000
  int16_t  kp_y_m;      // Kp_y  × 1000
  int16_t  ki_y_m;      // Ki_y  × 1000
};   // 30 bytes(對齊 32 = ACK 上限,**必須跟飛機端一起重燒**)

// status 位元定義(跟飛機端一致)
#define STATUS_ARMED         0x01   // bit0:已 armed
#define STATUS_CALIBRATING   0x02   // bit1:正在校準
#define STATUS_CAL_FAILED    0x04   // bit2:上次校準失敗
#define STATUS_GPS_FIX       0x08   // bit3:GPS 有效定位

Signal    data;
Telemetry tele;
bool      teleOK = false;
bool      sdOK   = false;
#if ENABLE_SD
SPIClass  spiSD(HSPI);   // SD 專用第二組 SPI(S3 上 HSPI = SPI3)
#endif

// ---- 模式名稱(中文化,2026-06-06)----
// 兩位數 mode 編碼,值為 0/1/2/10/11/12/20/21/22(9 個離散值)
const char* getModeName(byte m) {
  switch (m) {
    case 0:  return "安全校準";   // 安全 / 校準 / 設定 hub
    case 1:  return "手動自穩";   // 手動自穩(目前唯一可飛)
    case 2:  return "GPS導航";    // GPS 自動到目標 + 避障 + 降落
    case 10: return "語音控制";   // 喚醒詞「啟動」
    case 11: return "電腦控制";   // PC 透過 USB 控制
    case 12: case 20:
    case 21: case 22:    return "保留";    // 預留
    default:             return "未知";    // 無效值
  }
}

// 哪些 mode 已實作(影響 TFT「MODE NOT IMPLEMENTED」提示)。
// 目前只有 00(安全/設定畫面)跟 01(手動飛行)有完整 UI 跟邏輯。
// 將來 02 / 10 / 11 加進來後也要更新這個 list。
bool modeImplemented(byte m) { return m == 0 || m == 1; }

// ---- 選單鈕 ----
enum { BTN_NONE, BTN_PLUS, BTN_MINUS, BTN_OK, BTN_BACK };

// ---- UI 狀態 ----
enum UiState { UI_FLIGHT, UI_MENU };
UiState ui = UI_FLIGHT;

// PID 本地副本(開機與飛機預設一致)
// 2026-06-09 跟飛機 Drone_FC_Full(commit fe466f0)同步降到保守值
// 避免一進選單就送舊高值給飛機 → 飛機 PID 被覆蓋成激進值
// isAction = true → 動作項目(校準/存檔),OK 觸發、不顯示數值
// 動作項目用 paramVal 當 pulse counter,每按一次 +1,飛機 dedup 看 (id,val) 變化才動作
struct Param { const char* name; float val; float step; byte id; bool isAction; };
Param params[] = {
  { "Kp ",      1.0f,  0.1f,   1,   false },
  { "Ki ",      0.01f, 0.005f, 2,   false },
  { "Kd ",      0.3f,  0.05f,  3,   false },
  { "KpY",      0.8f,  0.1f,   4,   false },
  { "KiY",      0.01f, 0.005f, 5,   false },
  { "保存PID",  0.0f,  1.0f,   102, true  },
  { "快速校準",  0.0f,  1.0f,   100, true  },
  { "完整校準",  0.0f,  1.0f,   101, true  },
  { "音樂",     0.0f,  1.0f,   200, true  },   // id 200 = 本地動作,不送飛機
};
const int N_PARAM = 9;

#if ENABLE_MUSIC
void musicToggle();   // 前置宣告,實作在音樂區塊
#endif
int menuCursor = 0;

unsigned long lastDrawTime = 0;

// ============================================================
// 公用函式
// ============================================================
int centerMap(int raw, bool reverse) {
  raw = constrain(raw, 0, 4095);
  int out = map(raw, 0, 4095, 0, 255);
  return reverse ? 255 - out : out;
}

// ESP32 ADC 單次讀會跳幾十,多次取樣平均壓雜訊(12 次約 0.6ms,50Hz 迴圈吃得下)
int analogReadAvg(int pin) {
  long s = 0;
  for (int i = 0; i < 12; i++) s += analogRead(pin);
  return (int)(s / 12);
}

byte readSwitch3(int pin) {
  int v = analogRead(pin);
  // 2026-06-06 試燒發現實體開關上下與 ADC 讀值相反,把回傳值對調
  // 撥到上 = ADC 低電位 → 回傳 0;撥到下 = ADC 高電位 → 回傳 2
  if (v > 2730) return 2;   // 下
  if (v < 1365) return 0;   // 上
  return 1;                  // 中(開路分壓中點)
}

// 全 redraw flag:drawFlightStatic 設 true,drawFlightDynamic 第一次跑會強制重畫所有
// (從 PID 選單返回後 mode 沒變但畫面被清掉,沒這個會空一片)
bool g_flightDirty = false;
bool g_menuDirty   = false;

// ---- 校準畫面提示 ----
// FC 校準時 sampleIMU() 會阻塞 0.3~1.5 秒,期間不回 telemetry,所以「校準中」
// 不能等 telemetry 的 STATUS_CALIBRATING(手把根本收不到那個瞬間),改由手把
// 「自己送出校準觸發」的時刻驅動;校準中結束後再讀 STATUS_CAL_FAILED 判成敗。
unsigned long g_calBusyStart    = 0;    // 校準開始 millis(算進度條用)
unsigned long g_calBusyUntil    = 0;    // 顯示「校準中」到此 millis
const char*   g_calBusyName     = "";   // "快速校準" / "完整校準"
bool          g_calResultPending = false; // 校準中結束後,要顯示一次成敗

void triggerCalPrompt(const char* name, unsigned long durMs) {
  g_calBusyName      = name;
  g_calBusyStart     = millis();
  g_calBusyUntil     = millis() + durMs;
  g_calResultPending = true;
}

// 參數重送窗口:調 PID / 觸發動作後,持續送同一個 paramID 一小段時間,
// 避免 nRF24 偶爾丟一包就漏掉(FC 端 lastID/lastVal 去重,重送只會套用一次)
unsigned long g_paramHoldUntil = 0;

// 最近一次收到遙測的時刻:判斷飛機是否真的在線(校準結果不能在飛機沒開時誤報完成)
unsigned long g_lastTeleMs = 0;

// PID:開機收到第一筆有效遙測後,把選單值同步成飛機的實際 PID(一次性,之後手把端為主)
bool          g_pidSynced    = false;
unsigned long g_pidSaveUntil = 0;   // 顯示「PID 已存」確認屏到此 millis

// 把選單 PID(前 5 列)同步成飛機回傳的實際值。只在開機第一筆有效遙測時做一次,
// 之後手把端為準(使用者調的值送給飛機,不再被回傳覆蓋)。
void syncPidFromTele() {
  // 防呆:飛機若還是舊韌體(沒回傳 PID),欄位會是 0/垃圾 → Kp 不可能 ≤0,跳過不同步
  if (tele.kp_rp_m <= 0 || tele.kp_rp_m > 30000) return;
  params[0].val = tele.kp_rp_m / 1000.0f;   // Kp
  params[1].val = tele.ki_rp_m / 1000.0f;   // Ki
  params[2].val = tele.kd_rp_m / 1000.0f;   // Kd
  params[3].val = tele.kp_y_m  / 1000.0f;   // KpY
  params[4].val = tele.ki_y_m  / 1000.0f;   // KiY
  g_pidSynced = true;
  g_menuDirty = true;   // 選單若正開著,強制重畫成新值
}

// 2026-06-07 試燒實測:+ 3810~3850、− 2640~2690、OK 1910~1940、返回 1160~1200
// 門檻取中點,邊緣最穩(舊門檻邊緣太靠近實測值,瞬間切換時容易誤觸)
int readMenuBtn() {
  int v = analogRead(MENU_BTN);
  if (v > 3300) return BTN_PLUS;
  if (v > 2300) return BTN_MINUS;
  if (v > 1550) return BTN_OK;
  if (v > 600)  return BTN_BACK;
  return BTN_NONE;
}

void readInputs(byte mode) {
  data.throttle = centerMap(analogReadAvg(J_THROTTLE), REV_THROTTLE);
  data.pitch    = centerMap(analogReadAvg(J_PITCH),    REV_PITCH);
  data.roll     = centerMap(analogReadAvg(J_ROLL),     REV_ROLL);

  // 中位死區:搖桿放中間時殘餘 ±幾 的抖動歸零,送出穩定中立 127
  if (abs((int)data.pitch - 127) <= 3) data.pitch = 127;
  if (abs((int)data.roll  - 127) <= 3) data.roll  = 127;
  if (data.throttle <= 4) data.throttle = 0;   // 油門到底吸成 0,怠速穩定

  // yaw 由肩鍵：L→42、R→212、都沒按/同時按→127（對應 ±60°/s）
  // mode 10 例外:左肩鈕是語音 PTT,yaw 固定中立(語音 yaw 之後再說)
  if (mode == 10) {
    data.yaw = 127;
  } else {
    bool yawL = (digitalRead(SHOULDER_L) == LOW);
    bool yawR = (digitalRead(SHOULDER_R) == LOW);
    data.yaw = (yawL && !yawR) ? 42 : (yawR && !yawL) ? 212 : 127;
  }

  data.mode = mode;

  // 進入 mode 0 → 送一次校準旗標（持續 600ms 確保飛機收到 0→1 邊緣）
  static byte lastMode = 255;
  static unsigned long calHoldUntil = 0;
  if (mode == 0 && lastMode != 0) {
    calHoldUntil = millis() + 600;
    triggerCalPrompt("進場自動校準", 2400);   // FC 進 mode 0 自動跑 quick+full(~1.8s 阻塞 + 餘裕)
  }
  lastMode = mode;
  data.flags = (millis() < calHoldUntil) ? 0x01 : 0x00;
}

void handleMenuCursor() {
  // 2026-06-07 修:推下選下、推上選上(用 REV_PITCH 跟飛行 mode 同方向)
  // 死區 55/200 改成 15/240(搖桿中位偏離時不誤觸)
  static unsigned long lastMove = 0;
  if (millis() - lastMove < 250) return;
  int p = centerMap(analogRead(J_PITCH), REV_PITCH);   // 跟 data.pitch 用同方向
  if (p > 240) { menuCursor = (menuCursor + 1) % N_PARAM;            lastMove = millis(); }
  if (p < 15)  { menuCursor = (menuCursor - 1 + N_PARAM) % N_PARAM;  lastMove = millis(); }
}

void handleMenuButton(int btn) {
  if (btn == BTN_BACK) { ui = UI_FLIGHT; drawFlightStatic(); return; }
  Param &p = params[menuCursor];
  if (p.isAction) {
    // 動作項目:只認 OK,每按一次 paramVal +1 當 pulse,飛機看 val 變才會做
    if (btn == BTN_OK) {
#if ENABLE_MUSIC
      if (p.id == 200) { musicToggle(); return; }   // 本地動作,不送飛機
#endif
      p.val += 1.0f;
      data.paramID  = p.id;
      data.paramVal = p.val;
      g_paramHoldUntil = millis() + 400;   // 重送窗口,避免丟包漏掉
      if (p.id == 100) triggerCalPrompt("快速校準", 700);    // FC 阻塞 ~0.3s
      if (p.id == 101) triggerCalPrompt("完整校準", 2200);   // FC 阻塞 ~1.5s + 餘裕
      if (p.id == 102) g_pidSaveUntil = millis() + 2800;     // 顯示「PID 已存」確認屏
    }
  } else {
    if (btn == BTN_PLUS)  p.val += p.step;
    if (btn == BTN_MINUS) p.val -= p.step;
    if (p.val < 0) p.val = 0;
    data.paramID  = p.id;
    data.paramVal = p.val;
    g_paramHoldUntil = millis() + 400;     // 重送窗口,避免丟包漏掉
  }
}

// ============================================================
// TFT UI(直立 240×320):static 一次畫底色 + dynamic 文字覆寫
// ============================================================
void drawFlightStatic() {
  tft.fillScreen(TFT_BLACK);
  tft.fillRect(0,   0, 240, 32, TFT_NAVY);     // 頂部標題列
  tft.fillRect(0, 280, 240, 40, TFT_DARKGREY); // 底部狀態列

  // 三個姿態 label 預先畫上(不會變,不用每次重畫)
  tft.setFont(&fonts::efontTW_24);
  tft.setTextColor(TFT_WHITE, TFT_BLACK);
  tft.setCursor(10, 50);  tft.print("翻滾");
  tft.setCursor(10, 130); tft.print("俯仰");
  tft.setCursor(10, 210); tft.print("偏航");

  g_flightDirty = true;   // 強制下一次 drawFlightDynamic 重畫所有 cached 部分
}

void drawFlightDynamic(byte mode) {
  char buf[40];
  bool armed = tele.status & STATUS_ARMED;

  // === 頂部 mode 文字:只在 mode 改變時重畫 ===
  static byte lastModeDrawn = 255;
  if (mode != lastModeDrawn || g_flightDirty) {
    tft.fillRect(0, 0, 175, 32, TFT_NAVY);   // 先清舊文字(留 165 給已武/安全)
    tft.setFont(&fonts::efontTW_24);
    tft.setTextColor(TFT_WHITE, TFT_NAVY);
    tft.setCursor(5, 4);
    snprintf(buf, sizeof(buf), "M%02d %s", mode, getModeName(mode));
    tft.print(buf);
    lastModeDrawn = mode;
  }

  // === 武裝狀態:只在改變時重畫 ===
  static bool lastArmed = false;
  static bool armedInit = false;
  if (armed != lastArmed || !armedInit || g_flightDirty) {
    tft.fillRect(175, 0, 65, 32, TFT_NAVY);
    tft.setFont(&fonts::efontTW_24);
    tft.setTextColor(armed ? TFT_RED : TFT_LIGHTGREY, TFT_NAVY);
    tft.setCursor(180, 4);
    tft.print(armed ? "已武" : "安全");
    lastArmed = armed;
    armedInit = true;
  }

  // === 主體:已實作/未實作 切換時清主體 + 重畫 label ===
  static byte lastBlock = 255;
  byte block = modeImplemented(mode) ? 1 : 0;
  if (block != lastBlock || g_flightDirty) {
    tft.fillRect(0, 34, 240, 244, TFT_BLACK);
    if (modeImplemented(mode)) {
      // 把 label 補回去(static 第一次有畫,主體被清掉後再補)
      tft.setFont(&fonts::efontTW_24);
      tft.setTextColor(TFT_WHITE, TFT_BLACK);
      tft.setCursor(10, 50);  tft.print("翻滾");
      tft.setCursor(10, 130); tft.print("俯仰");
      tft.setCursor(10, 210); tft.print("偏航");
    } else {
      tft.setFont(&fonts::efontTW_24);
      tft.setTextColor(TFT_YELLOW, TFT_BLACK);
      tft.setCursor(40, 140); tft.print("此模式");
      tft.setCursor(40, 175); tft.print("未實作");
    }
    lastBlock = block;
    g_flightDirty = true;   // 主體被清過,下面值檢查強制重畫(否則 tele 沒變就空白)
  }

  // === 姿態數值:只在改變時重畫 ===
  if (modeImplemented(mode)) {
    static int16_t lastRoll = -32000, lastPitch = -32000, lastYaw = -32000;
    tft.setFont(&fonts::efontTW_24);
    tft.setTextColor(TFT_WHITE, TFT_BLACK);
    // 重畫門檻(deg×10):靜止時 ±0.x° 感測雜訊不重畫,不閃也不延遲真實值
    if (abs(tele.roll - lastRoll) >= 8 || g_flightDirty) {
      tft.fillRect(10, 80, 200, 30, TFT_BLACK);
      tft.setCursor(10, 80);
      snprintf(buf, sizeof(buf), "%+7.1f °", tele.roll / 10.0);
      tft.print(buf);
      lastRoll = tele.roll;
    }
    if (abs(tele.pitch - lastPitch) >= 8 || g_flightDirty) {
      tft.fillRect(10, 160, 200, 30, TFT_BLACK);
      tft.setCursor(10, 160);
      snprintf(buf, sizeof(buf), "%+7.1f °", tele.pitch / 10.0);
      tft.print(buf);
      lastPitch = tele.pitch;
    }
    if (abs(tele.yawRate - lastYaw) >= 20 || g_flightDirty) {
      tft.fillRect(10, 240, 230, 30, TFT_BLACK);
      tft.setCursor(10, 240);
      snprintf(buf, sizeof(buf), "%+7.1f °/秒", tele.yawRate / 10.0);
      tft.print(buf);
      lastYaw = tele.yawRate;
    }
  }
  g_flightDirty = false;   // 消耗 dirty 旗標

  // 底部狀態列(三行,塞 GPS / 高度 / 方位 / 油門 / 連線)
  tft.setFont(&fonts::efontTW_14);
  tft.setTextColor(TFT_WHITE, TFT_DARKGREY);
  // 第 1 行:油門 + 高度
  snprintf(buf, sizeof(buf), "油門%3d%%  高度%+5.1fm",
           (int)(data.throttle * 100 / 255),
           tele.altitude_dm / 10.0);
  tft.setCursor(5, 283);
  tft.print(buf);
  // 第 2 行:方位 + GPS 衛星數
  const char* dir = "?";
  int h10 = tele.heading;
  if      (h10 >= 3375 || h10 < 225)  dir = "北";
  else if (h10 <  675)                dir = "東北";
  else if (h10 < 1125)                dir = "東";
  else if (h10 < 1575)                dir = "東南";
  else if (h10 < 2025)                dir = "南";
  else if (h10 < 2475)                dir = "西南";
  else if (h10 < 2925)                dir = "西";
  else                                dir = "西北";
  snprintf(buf, sizeof(buf), "方位%5.1f° %s  GPS sat%d",
           tele.heading / 10.0, dir, tele.satCount);
  tft.setCursor(5, 300);
  tft.print(buf);
}

void drawMenuStatic() {
  tft.fillScreen(TFT_BLACK);
  tft.fillRect(0,   0, 240, 32, TFT_PURPLE);
  tft.fillRect(0, 280, 240, 40, TFT_DARKGREY);

  tft.setFont(&fonts::efontTW_24);
  tft.setTextColor(TFT_WHITE, TFT_PURPLE);
  tft.setCursor(40, 4);
  tft.print("═ PID 設定 ═");

  tft.setFont(&fonts::efontTW_14);
  tft.setTextColor(TFT_WHITE, TFT_DARKGREY);
  tft.setCursor(5, 285);
  tft.print("右搖桿:游標  +/-:調值");
  tft.setCursor(5, 302);
  tft.print("OK:送出    返回:離開");
  g_menuDirty = true;   // 進選單後第一次 drawMenuDynamic 強制畫所有列
}

void drawMenuDynamic() {
  // 只重畫狀態變過的列(cursor 跳走 / 值改了),避免閃爍
  static int   lastCursor = -1;
  static float lastVal[N_PARAM] = { -999, -999, -999, -999, -999, -999, -999, -999, -999 };
  char buf[24];
  const int rowH = 26;     // 9 列要塞進 40~280 px(9×26=234),行高再壓低

  for (int i = 0; i < N_PARAM; i++) {
    bool sel    = (i == menuCursor);
    bool wasSel = (i == lastCursor);
    bool valChanged = (lastVal[i] != params[i].val);

    if (sel != wasSel || valChanged || lastCursor == -1 || g_menuDirty) {
      int y = 40 + i * rowH;
      uint16_t bg = sel ? TFT_DARKGREEN : TFT_BLACK;
      uint16_t fg = sel ? TFT_YELLOW    : TFT_WHITE;
      tft.fillRect(0, y, 240, rowH, bg);
      tft.setFont(&fonts::efontTW_24);
      tft.setTextColor(fg, bg);
      tft.setCursor(10, y + 1);
      tft.print(sel ? ">" : " ");
      tft.print(params[i].name);
      tft.setCursor(160, y + 1);
      if (params[i].isAction) {
        tft.print("GO");
      } else {
        snprintf(buf, sizeof(buf), "%6.3f", params[i].val);
        tft.print(buf);
      }
      lastVal[i] = params[i].val;
    }
  }
  lastCursor = menuCursor;
  g_menuDirty = false;
}

// 全畫面 modal(校準提示 / PID 存檔確認):回傳 true 代表 modal 正佔用畫面,
// 呼叫端應跳過一般繪製。結束後自動還原底層畫面。
bool drawCalOverlay() {
  static uint8_t shown = 0;            // 0=無 modal、1=校準中、2=校準結果、3=PID已存
  static unsigned long resultUntil = 0;

  // --- PID 已存確認(讀飛機回傳的實際 PID 顯示)---
  if (millis() < g_pidSaveUntil) {
    if (shown != 3) {
      bool live = (millis() - g_lastTeleMs < 1000);
      char b[44];
      tft.fillScreen(TFT_DARKGREEN);
      tft.setFont(&fonts::efontTW_24);
      tft.setTextColor(TFT_WHITE, TFT_DARKGREEN);
      tft.setCursor(25, 25); tft.print("PID 已存飛機");
      tft.setFont(&fonts::efontTW_16);
      if (live) {
        snprintf(b, sizeof(b), "Kp  %.3f", tele.kp_rp_m / 1000.0f); tft.setCursor(20, 85);  tft.print(b);
        snprintf(b, sizeof(b), "Ki  %.3f", tele.ki_rp_m / 1000.0f); tft.setCursor(20, 115); tft.print(b);
        snprintf(b, sizeof(b), "Kd  %.3f", tele.kd_rp_m / 1000.0f); tft.setCursor(20, 145); tft.print(b);
        snprintf(b, sizeof(b), "KpY %.3f", tele.kp_y_m  / 1000.0f); tft.setCursor(20, 175); tft.print(b);
        snprintf(b, sizeof(b), "KiY %.3f", tele.ki_y_m  / 1000.0f); tft.setCursor(20, 205); tft.print(b);
      } else {
        tft.setCursor(20, 120); tft.print("飛機未連線,無法確認值");
      }
      shown = 3;
    }
    return true;
  }

  // --- 校準中(由手把觸發時刻 + 預估阻塞時間驅動)+ 進度條 ---
  if (millis() < g_calBusyUntil) {
    if (shown != 1) {
      tft.fillScreen(TFT_NAVY);
      tft.setFont(&fonts::efontTW_24);
      tft.setTextColor(TFT_YELLOW, TFT_NAVY);
      tft.setCursor(55, 70); tft.print("校準中…");
      tft.setFont(&fonts::efontTW_16);
      tft.setTextColor(TFT_WHITE, TFT_NAVY);
      tft.setCursor(20, 115); tft.print(g_calBusyName);
      tft.setFont(&fonts::efontTW_14);
      tft.setCursor(20, 150); tft.print("機體放平、保持不動");
      tft.drawRect(20, 195, 200, 24, TFT_WHITE);   // 進度條外框
      shown = 1;
    }
    // 進度條填充:每次重繪更新(觸發→結束的時間比例),只增不減免清背景
    unsigned long total = g_calBusyUntil - g_calBusyStart;
    long w = total ? (long)(196 * (millis() - g_calBusyStart) / total) : 196;
    if (w < 0) w = 0; if (w > 196) w = 196;
    tft.fillRect(22, 197, (int)w, 20, TFT_GREEN);
    return true;
  }

  // --- 校準中剛結束 → 讀 telemetry 顯示一次結果 ---
  // 三態:飛機沒連線(收不到遙測)→ 不能說完成;有連線再分成功/失敗
  if (g_calResultPending) {
    g_calResultPending = false;
    bool linkAlive = (millis() - g_lastTeleMs < 1000);   // 校準視窗結束時應已有新鮮遙測
    bool failed    = tele.status & STATUS_CAL_FAILED;
    tft.setFont(&fonts::efontTW_24);
    tft.setTextColor(TFT_WHITE);
    if (!linkAlive) {
      tft.fillScreen(TFT_DARKGREY);
      tft.setCursor(30, 95);  tft.print("飛機未連線");
      tft.setFont(&fonts::efontTW_14);
      tft.setCursor(15, 145); tft.print("沒收到回應,校準未確認");
    } else if (failed) {
      tft.fillScreen(TFT_MAROON);
      tft.setCursor(45, 95);  tft.print("校準失敗");
      tft.setFont(&fonts::efontTW_14);
      tft.setCursor(15, 145); tft.print("偵測到晃動,放平後重試");
    } else {
      tft.fillScreen(TFT_DARKGREEN);
      tft.setCursor(45, 95);  tft.print("校準完成");
    }
    shown = 2;
    resultUntil = millis() + 2500;
    return true;
  }
  if (shown == 2 && millis() < resultUntil) return true;

  // --- 沒有 modal 該顯示:若剛從 modal 退出,還原底層畫面 ---
  if (shown != 0) {
    if (ui == UI_FLIGHT) drawFlightStatic(); else drawMenuStatic();
    shown = 0;
  }
  return false;
}

// ============================================================
void setup() {
  Serial.begin(115200);
  // 等 USB CDC 真的連上(最多 3 秒),沒 host 連接也照樣繼續
  // 比固定 delay(2000) 可靠:有 Serial Monitor 接著就立刻過,沒接就 3 秒後超時
  unsigned long t0 = millis();
  while (!Serial && millis() - t0 < 3000) delay(10);
  delay(200);   // 額外緩衝,讓 host 端 buffer 準備好
  Serial.println("\n=== 地面站 V2-A 啟動 ===");
  Serial.flush();

  // 關掉 ESP32-S3 板上的 WS2812 RGB LED(常在 GPIO 48,跟我們 TFT CS 共腳)
  // 在 tft.init() 之前送一次「全 0 = 關燈」訊號,之後 GPIO 48 切換成 SPI CS
  // 用,LED 會保持上次的狀態(熄滅)。如果你的板 LED 不在 GPIO 48,改下面數字。
  neopixelWrite(48, 0, 0, 0);

  pinMode(SHOULDER_L, INPUT_PULLUP);
  pinMode(SHOULDER_R, INPUT_PULLUP);
  analogReadResolution(12);

  // MAX98357A SD 拉低 → 休眠,沒「沙沙」雜訊。Mode 10 / 音樂播放時程式再設 HIGH
  pinMode(PIN_AMP_SD, OUTPUT);
  digitalWrite(PIN_AMP_SD, LOW);

  // TFT 背光:MSP2806 的 LED 腳直接接 B 板 3V3 軌常亮,不需要程式控制
  // (試燒驗證:LED 接 GPIO 15 PWM 不會亮,直接拉 3V3 才亮)

  // === SPI / NRF24 / SD 先 init,TFT 後加入共用 ===
  // 順序顛倒(TFT 先)會讓 SD 拿不到 MISO 掛載失敗(2026-06-06 試燒實證)
  SPI.begin(PIN_SPI_SCK, PIN_SPI_MISO, PIN_SPI_MOSI, -1);

  // NRF24
  Serial.print("[*] NRF24 radio.begin() ... ");
  bool nrfOK = radio.begin();
  Serial.println(nrfOK ? "OK" : "FAIL");
  Serial.printf("[*] NRF24 chip connected: %s\n",
                radio.isChipConnected() ? "YES" : "NO ⚠️ 模組沒回應 SPI");
  if (!nrfOK || !radio.isChipConnected()) {
    Serial.println("[!] 手把 NRF24 init 失敗,通常是:");
    Serial.println("    1. 100µF 電容沒焊");
    Serial.println("    2. CE/CSN/SCK/MISO/MOSI 接線錯");
    Serial.println("    3. 模組壞了");
    Serial.println("    4. 3V3 軌電壓不夠");
  }
  radio.openWritingPipe(PIPE_OUT);
  radio.setChannel(NRF_CHANNEL);
  radio.setAutoAck(true);
  radio.enableAckPayload();
  radio.setDataRate(RF24_250KBPS);
  // 2026-06-09 PA_HIGH 還是讓 3V3 軌 sag(LDO 撐不住 50mA 尖峰)
  // 降到 PA_MIN(~7mA 尖峰),確認對通邏輯先,距離 ~10m 夠桌面測試
  // 飛實機要長距離再加大電容 / 加獨立 LDO 後改回 HIGH 或 MAX
  radio.setPALevel(RF24_PA_MIN);
  radio.stopListening();
  Serial.println("[+] NRF24 就緒");

#if ENABLE_SD
  // SD(選用,沒卡也繼續)— 用獨立 SPI3,不碰 NRF24/TFT 的 bus
  pinMode(PIN_SD_CS, OUTPUT);
  digitalWrite(PIN_SD_CS, HIGH);
  spiSD.begin(PIN_SD_SCK, PIN_SD_MISO, PIN_SD_MOSI, PIN_SD_CS);
  // 20MHz 餵影片才夠(4MHz 只有 ~400KB/s 會卡),掛不上自動降速
  if (SD.begin(PIN_SD_CS, spiSD, 20000000) ||
      SD.begin(PIN_SD_CS, spiSD, 10000000) ||
      SD.begin(PIN_SD_CS, spiSD, 4000000)) {
    sdOK = true;
    Serial.println("[+] SD 卡掛載成功(獨立 SPI3)");
  } else {
    Serial.println("[*] SD 卡未接或初始化失敗(繼續)");
  }
#else
  // ENABLE_SD = 0:跳過 SD init,GPIO 47 不操作,留給未來其他用途
  Serial.println("[*] SD 停用(ENABLE_SD = 0)");
  sdOK = false;
#endif

  // MAX98357A SD 腳:開機立刻拉低靜音(浮空會放大 I²S 雜訊,memory 老坑)
  pinMode(PIN_AMP_SD, OUTPUT);
  digitalWrite(PIN_AMP_SD, LOW);
#if ENABLE_MUSIC
  initMusicI2S();
  Serial.println("[+] 音樂 I²S 就緒(選單→音樂 播放/停止)");
#endif

#if ENABLE_VOICE_MODE10
  // 錄音緩衝(PSRAM)+ 語音管線 task 釘在核心 0(主迴圈在核心 1)
  // 關閉 task watchdog:語音 task 的 TLS 加密/上傳即使逐塊讓出 CPU,
  // 仍可能讓核心 0 IDLE 超過 5 秒沒跑滿觸發重啟(2026-06-12 兩度實測)。
  // 手把非飛行安全件,關掉換穩定;之後 ESP-SR 本地辨識取代雲端就能開回來。
  esp_task_wdt_deinit();
  vRecBuf = (int16_t*)heap_caps_malloc(VREC_MAXSAMP * 2, MALLOC_CAP_SPIRAM);
  if (vRecBuf) {
    xTaskCreatePinnedToCore(voiceTask, "voice", 16384, NULL, 1, NULL, 0);
    Serial.println("[+] 語音 task 啟動(核心 0)");
  } else {
    Serial.println("[!] PSRAM 配置失敗,Mode 10 停用");
  }
#endif

  // TFT(SD 之後 init,共用 SPI bus_shared 模式)
  tft.init();
  tft.setRotation(2);   // 240×320 portrait 翻 180°
  tft.fillScreen(TFT_BLACK);
  tft.setFont(&fonts::efontTW_16);

  // 開機狀態畫面(因 USB CDC 在 ESP32-S3 有問題,debug 訊息全部上 TFT)
  tft.setTextColor(TFT_WHITE, TFT_BLACK);
  tft.setCursor(5, 5);
  tft.print("地面站 V2-A 啟動");

  // NRF24 狀態:大字顯示 OK / FAIL,3 秒後才進飛行 UI
  tft.setCursor(5, 40);
  tft.setTextColor(nrfOK ? TFT_GREEN : TFT_RED, TFT_BLACK);
  tft.print("NRF24 begin: ");
  tft.print(nrfOK ? "OK" : "FAIL");

  tft.setCursor(5, 70);
  bool chipOK = radio.isChipConnected();
  tft.setTextColor(chipOK ? TFT_GREEN : TFT_RED, TFT_BLACK);
  tft.print("chip connected: ");
  tft.print(chipOK ? "YES" : "NO");

  tft.setCursor(5, 100);
  tft.setTextColor(TFT_WHITE, TFT_BLACK);
  tft.printf("PIPE = 0x%04X%04X", (uint16_t)(PIPE_OUT >> 16), (uint16_t)PIPE_OUT);
  tft.setCursor(5, 130);
  tft.printf("CHAN = %d", NRF_CHANNEL);

  // 上次重啟原因:除錯語音辨識中途重啟用(電池模式看不到 Serial)
  {
    esp_reset_reason_t rr = esp_reset_reason();
    const char* rs = (rr == ESP_RST_POWERON) ? "正常上電" :
                     (rr == ESP_RST_BROWNOUT) ? "BROWNOUT 電壓不足!" :
                     (rr == ESP_RST_PANIC)    ? "PANIC 程式崩潰!" :
                     (rr == ESP_RST_TASK_WDT) ? "看門狗 WDT!" :
                     (rr == ESP_RST_INT_WDT)  ? "中斷 WDT!" :
                     (rr == ESP_RST_SW)       ? "軟體重啟" : "其他";
    tft.setCursor(5, 200);
    tft.setTextColor(rr == ESP_RST_POWERON ? TFT_DARKGREY : TFT_ORANGE, TFT_BLACK);
    tft.printf("上次重啟:%s", rs);
  }

  tft.setCursor(5, 170);
  if (sdOK) {
    tft.setTextColor(TFT_GREEN, TFT_BLACK);
    tft.print("SD: 已掛載");
  } else {
    tft.setTextColor(TFT_YELLOW, TFT_BLACK);
    tft.print("SD: 未接");
  }

  tft.setCursor(5, 250);
  tft.setTextColor(TFT_CYAN, TFT_BLACK);
  tft.print("3 秒後進飛行 UI...");

  delay(3000);

  drawFlightStatic();
  Serial.println("地面站 V2-A 就緒");
}

// ============================================================
#if ENABLE_WIFI_SCAN_MODE22
void enterScanMode();
void exitScanMode();
void scanModeLoop(int btnEdge);
#endif

void loop() {
  byte mode = readSwitch3(SW_A) * 10 + readSwitch3(SW_B);   // 兩位數編碼:A 十位 + B 個位

  // 按鈕單一邊緣偵測
  int btn = readMenuBtn();
  static int lastBtn = BTN_NONE;
  bool btnEdge = (btn != lastBtn && btn != BTN_NONE);
  lastBtn = btn;

#if ENABLE_VOICE_MODE10
  // Mode 10 語音控制:50Hz 控制照跑(這是飛行模式!),語音管線在
  // 核心 0 背景跑,主迴圈只做 PTT 偵測 + 虛擬搖桿覆寫 + UI
  static bool inVoiceMode = false;
  if (mode == 10) {
    if (!inVoiceMode) { inVoiceMode = true; enterVoiceMode(); }
    g_vPTT = (digitalRead(SHOULDER_L) == LOW);   // 左肩鈕 = PTT
    readInputs(mode);                            // data.mode = 10,yaw 中立
    applyVoiceOverride();                        // 語音程式覆寫虛擬搖桿
    bool vok = radio.write(&data, sizeof(Signal));
    if (vok && radio.isAckPayloadAvailable()) {
      radio.read(&tele, sizeof(tele));
      teleOK = true;
      g_lastTeleMs = millis();
    }
    voiceModeUi();
#if ENABLE_MUSIC
    // 語音回應:task 設 g_vSpeak,主迴圈用音樂管線非阻塞播 SD 上的預錄句
    if (g_vSpeak) {
      static const char* SPK[] = { "", "/voice/takeoff.wav", "/voice/land.wav",
        "/voice/stop.wav", "/voice/motor1.wav", "/voice/motor2.wav",
        "/voice/motor3.wav", "/voice/motor4.wav", "/voice/unknown.wav" };
      uint8_t id = g_vSpeak;
      g_vSpeak = 0;
      if (id <= 8 && sdOK) musicPlay(SPK[id]);
    }
    musicUpdate();
#endif
    return;
  } else if (inVoiceMode) {
    inVoiceMode = false;
    exitVoiceMode();
    ui = UI_FLIGHT;
    drawFlightStatic();
  }
#endif

#if ENABLE_VIDEO_MODE12
  // Mode 12 媒體模式:接管整個 loop。NRF24 照送(mode=12 → 飛機白名單
  // 擋掉自動 disarm),模式開關一撥走立刻退出
  static bool inVideoMode = false;
  if (mode == 12) {
    if (!inVideoMode) { inVideoMode = true; enterVideoMode(); }
    videoModeLoop(btnEdge ? btn : BTN_NONE);
    readInputs(mode);                       // data.mode = 20
    radio.write(&data, sizeof(Signal));
    return;
  } else if (inVideoMode) {
    inVideoMode = false;
    exitVideoMode();
    ui = UI_FLIGHT;
    drawFlightStatic();
  }
#endif

#if ENABLE_WIFI_SCAN_MODE22
  // Mode 22 WiFi 掃描:被動列出附近 AP。接管整個 loop,不送 NRF
  //(飛機 1 秒沒收到會自動 failsafe disarm,安全)
  static bool inScanMode = false;
  if (mode == 22) {
    if (!inScanMode) { inScanMode = true; enterScanMode(); }
    scanModeLoop(btnEdge ? btn : BTN_NONE);
    return;
  } else if (inScanMode) {
    inScanMode = false;
    exitScanMode();
    ui = UI_FLIGHT;
    drawFlightStatic();
  }
#endif

  // UI 狀態機
  if (ui == UI_FLIGHT) {
    if (btnEdge && mode == 0 && btn == BTN_OK) {
      ui = UI_MENU;
      drawMenuStatic();
    }
  } else {  // UI_MENU
    if (mode != 0) {
      ui = UI_FLIGHT;
      drawFlightStatic();
    } else {
      handleMenuCursor();
      if (btnEdge) handleMenuButton(btn);
    }
  }

  readInputs(mode);

#if ENABLE_MUSIC
  musicUpdate();   // 非阻塞餵 I²S,DMA 滿了立刻返回
#endif

  // 送指令 + 收遙測(ACK payload)
  // Debug:每秒印一次 TX 統計,看到底有沒有送出去 + 飛機有沒有 ACK 回來
  static uint32_t txOk = 0, txFail = 0, lastTxStat = 0;
  bool ok = radio.write(&data, sizeof(Signal));
  if (ok) {
    txOk++;
    if (radio.isAckPayloadAvailable()) {
      radio.read(&tele, sizeof(tele));
      teleOK = true;
      g_lastTeleMs = millis();
      if (!g_pidSynced) syncPidFromTele();   // 開機第一筆遙測 → 選單顯示飛機實際 PID
    }
  } else {
    txFail++;
    teleOK = false;
  }
  if (millis() - lastTxStat > 1000) {
    lastTxStat = millis();
    Serial.printf("[NRF] TX ok=%lu fail=%lu (1 秒內) | mode=%02d throttle=%d\n",
                  txOk, txFail, data.mode, data.throttle);
    txOk = 0; txFail = 0;
  }
  if (millis() > g_paramHoldUntil) data.paramID = 0;   // 過了重送窗口才清(期間每包連送,抗丟包)

  // TFT 更新（每 150ms）
  if (millis() - lastDrawTime > 150) {
    lastDrawTime = millis();
    if (drawCalOverlay()) {
      // 校準提示 modal 正佔畫面,跳過一般繪製
    } else if (ui == UI_FLIGHT) {
      drawFlightDynamic(mode);
    } else {
      drawMenuDynamic();
    }
  }

  delay(20);   // 約 50Hz
}


// ============================================================
// ============================================================
//                  以下都是 feature 骨架
//   ENABLE_XXX 旗標 = 0 時不會啟用,只是先把架構放這方便將來補
// ============================================================
// ============================================================


// ============================================================
// Mode 11:PC 控制(USB CDC 透明橋接)
//
// 開啟方法:#define ENABLE_PC_MODE11 1
//
// 使用流程:
// 1. PC 用 USB 接手把(會佔用 Serial 0,無法看 debug log)
// 2. 撥到 mode = 11(SW_A 中 + SW_B 中),手把進入 PC 橋接模式
// 3. PC 端 app 透過 USB Serial 送 13-byte PcCommand,手把轉成 Signal 送 NRF24
// 4. NRF24 回的 telemetry 透過 USB Serial 回 PC
//
// PC 端 app 建議:Python + pyserial + pygame.joystick + opencv(相機影像)
// 詳細實作等使用者要做時再細談
// ============================================================
#if ENABLE_PC_MODE11
struct PcCommand {
  uint8_t startByte;    // 必須 0xAA
  uint8_t throttle, pitch, roll, yaw;
  uint8_t mode;         // PC 可強制覆蓋手把開關位置
  uint8_t flags;
  uint8_t paramID;
  float   paramVal;
  uint8_t checksum;     // sum of bytes 1~11 取低 8 bit
};

void pcBridgeUpdate(Signal& sig) {
  // 從 USB Serial 讀 PC 指令,覆蓋 sig
  if (Serial.available() >= (int)sizeof(PcCommand)) {
    PcCommand cmd;
    Serial.readBytes((uint8_t*)&cmd, sizeof(cmd));
    if (cmd.startByte != 0xAA) return;
    // TODO:checksum 驗證
    sig.throttle = cmd.throttle;
    sig.pitch    = cmd.pitch;
    sig.roll     = cmd.roll;
    sig.yaw      = cmd.yaw;
    sig.mode     = cmd.mode;
    sig.flags    = cmd.flags;
    sig.paramID  = cmd.paramID;
    sig.paramVal = cmd.paramVal;
  }
  // 把當前 telemetry 推給 PC(每次都送,讓 PC 端隨時有最新狀態)
  Serial.write((const uint8_t*)&tele, sizeof(Telemetry));
}
#endif


// ============================================================
// Mode 10:AI 語音控制
//
// 開啟方法:#define ENABLE_VOICE_MODE10 1 + 建立 secrets.h 含:
//   WIFI_SSID / WIFI_PASS
//   WIT_AI_TOKEN(免費,Wit.ai 中文 STT)
//   GROQ_API_KEY(免費 14400 req/day,Llama 3.3)
//   VOICERSS_API_KEY(免費 350 req/day,中文 TTS)
//
// 流程:
//   ESP-SR 監聽喚醒詞「啟動」(本地,免雲端)
//   ↓ 偵測到
//   錄音 5 秒 → 上傳 Wit.ai → 取得 STT 結果(中文文字)
//   ↓
//   比對本地指令清單(起飛/降落/返航/懸停/聊天/取消/狀態/加速/減速)
//   ↓ 是本地指令 → 直接執行(改 Signal.mode 或 flags)
//   ↓ 否則 → 送 Groq LLM 取得對話回應 → 上傳 VoiceRSS 取得 MP3 → 播放
//
// 詳細申請 API key 跟 ESP-SR 設定 在 [[mode-10-ai-voice-apis]] 記憶
// ============================================================
#if ENABLE_VOICE_MODE10
#include <WiFi.h>
#include <HTTPClient.h>
#include "secrets.h"   // 自己建立,git ignore

enum VoiceState { VS_IDLE, VS_WAKE, VS_RECORDING, VS_STT, VS_LLM, VS_TTS, VS_PLAY };
VoiceState voiceState = VS_IDLE;

const char* LOCAL_CMDS[] = {
  "啟動", "起飛", "降落", "返航", "懸停",
  "取消", "狀態", "加速", "減速", "聊天"
};

void initVoice() {
  // WiFi 連線
  WiFi.begin(WIFI_SSID, WIFI_PASS);
  unsigned long t0 = millis();
  while (WiFi.status() != WL_CONNECTED && millis() - t0 < 10000) { delay(500); }
  if (WiFi.status() == WL_CONNECTED) {
    Serial.printf("[+] WiFi:%s\n", WiFi.localIP().toString().c_str());
  } else {
    Serial.println("[!] WiFi 連線失敗,Mode 10 雲端 STT/LLM/TTS 無法使用");
  }
  // TODO:ESP-SR MultiNet 載入「啟動」喚醒詞模型
}

void voiceUpdate() {
  // 狀態機:每次 loop 呼叫一次,各狀態做一小段工作避免卡 NRF24
  switch (voiceState) {
    case VS_IDLE:
      // TODO:if (espSrDetectWakeWord("啟動")) voiceState = VS_WAKE;
      break;
    case VS_WAKE:
      // TODO:嗶提示音 → voiceState = VS_RECORDING
      break;
    case VS_RECORDING:
      // TODO:錄音 5 秒到 PSRAM buffer
      break;
    case VS_STT:
      // TODO:HTTPS POST 到 https://api.wit.ai/speech,header WIT_AI_TOKEN
      break;
    case VS_LLM:
      // TODO:HTTPS POST 到 https://api.groq.com/openai/v1/chat/completions
      break;
    case VS_TTS:
      // TODO:HTTPS GET https://api.voicerss.org/?key=...&hl=zh-tw&src=回應
      break;
    case VS_PLAY:
      // TODO:解 MP3 推 I²S → MAX98357A
      break;
  }
}
#endif


// ============================================================
// 音樂播放(SD 上 /music/*.WAV → I²S → MAX98357A)
//
// 開啟:#define ENABLE_MUSIC 1
// 觸發:常駐選單 → 「音樂」項目 → 選曲 → OK 播放
//      或 Mode 10 語音「啟動 → 放音樂」
//
// 優先級:警示音 > Mode 10 語音回應 > 背景音樂
// 預設音量 60%,Mode 10 識別期間自動降到 20%
// ============================================================
#if ENABLE_MUSIC
File     musicFile;
bool     musicPlaying = false;
uint8_t  musicVolume  = 60;     // 0~100

#define MUSIC_SAMPLE_RATE 32000  // WAV 需轉成 32kHz / 單聲道 / 16-bit PCM
i2s_chan_handle_t musicTx = nullptr;
#if ENABLE_VOICE_MODE10
i2s_chan_handle_t micRx   = nullptr;   // INMP441,跟喇叭全雙工共 BCLK/WS
#endif

// I²S TX 初始化(沿用 Play_Test 驗證過的設定)
void initMusicI2S() {
  i2s_chan_config_t chan_cfg = I2S_CHANNEL_DEFAULT_CONFIG(I2S_NUM_0, I2S_ROLE_MASTER);
  // 主程式 loop 比 Play_Test 忙(NRF24 重試 + TFT 重繪),緩衝拉到 ~190ms
  // 6 × 1023 frames × 4B ≈ 24KB 內部 RAM,換 6138 samples 餘裕
  chan_cfg.dma_desc_num  = 6;
  chan_cfg.dma_frame_num = 1023;
#if ENABLE_VOICE_MODE10
  i2s_new_channel(&chan_cfg, &musicTx, &micRx);   // 同 port 全雙工(共 BCLK/WS)
#else
  i2s_new_channel(&chan_cfg, &musicTx, NULL);
#endif

  i2s_std_config_t std_cfg = {};
  std_cfg.clk_cfg  = I2S_STD_CLK_DEFAULT_CONFIG(MUSIC_SAMPLE_RATE);
  std_cfg.slot_cfg = I2S_STD_PHILIPS_SLOT_DEFAULT_CONFIG(I2S_DATA_BIT_WIDTH_32BIT, I2S_SLOT_MODE_MONO);
  std_cfg.slot_cfg.slot_mask = I2S_STD_SLOT_BOTH;
  std_cfg.gpio_cfg.mclk = I2S_GPIO_UNUSED;
  std_cfg.gpio_cfg.bclk = (gpio_num_t)PIN_I2S_BCLK;
  std_cfg.gpio_cfg.ws   = (gpio_num_t)PIN_I2S_WS;
  std_cfg.gpio_cfg.dout = (gpio_num_t)PIN_I2S_DOUT;
  std_cfg.gpio_cfg.din  = I2S_GPIO_UNUSED;
  i2s_channel_init_std_mode(musicTx, &std_cfg);
  i2s_channel_enable(musicTx);

#if ENABLE_VOICE_MODE10
  // 麥克風 RX:同時脈(32kHz / 32-bit),DIN = INMP441 SD
  i2s_std_config_t rx_cfg = std_cfg;
  rx_cfg.gpio_cfg.dout = I2S_GPIO_UNUSED;
  rx_cfg.gpio_cfg.din  = (gpio_num_t)PIN_I2S_DIN;
  // 關鍵:TX 是雙 slot(喇叭 L+R),RX 必須只收 LEFT(INMP441 L/R 接地)。
  // 繼承 BOTH 會讓錄音 sample 之間穿插垃圾 → Whisper 聽到雜訊亂辨識
  rx_cfg.slot_cfg.slot_mask = I2S_STD_SLOT_LEFT;
  i2s_channel_init_std_mode(micRx, &rx_cfg);
  // 不在這裡 enable:錄音開始才 enable、結束 disable(避免 DMA 堆舊資料)
#endif

  // 預灌 silence 讓 MAX98357A 醒來看到穩定 0 訊號(boot pop 消除)
  int32_t silence[256] = {0};
  size_t w = 0;
  for (int i = 0; i < 4; i++)
    i2s_channel_write(musicTx, silence, sizeof(silence), &w, 50 / portTICK_PERIOD_MS);
}

void musicPlay(const char* path) {
  if (musicPlaying) { musicFile.close(); }
  musicFile = SD.open(path, FILE_READ);
  if (!musicFile) { Serial.printf("[!] 開不了 %s\n", path); return; }
  musicFile.seek(44);   // 跳 WAV header
  musicPlaying = true;
  digitalWrite(PIN_AMP_SD, HIGH);   // 開擴大機
  Serial.printf("[+] 播放 %s\n", path);
}

void musicStop() {
  if (musicPlaying) { musicFile.close(); musicPlaying = false; }
  digitalWrite(PIN_AMP_SD, LOW);    // 關擴大機(靜音 + 消雜訊)
}

// 每迴圈呼叫:非阻塞地把 SD 資料餵進 I²S DMA。
// timeout 0:DMA 滿了就立刻返回,絕不卡住 50Hz 控制迴圈。
void musicUpdate() {
  if (!musicPlaying) return;
  static uint8_t pcm[512];
  static int32_t tx[256];
  for (int round = 0; round < 16; round++) {    // 每迴圈最多餵 4096 samples(128ms 音訊);
                                                 // DMA 滿會提前 return,實際讀 SD 時間只 2~4ms
    int n = musicFile.read(pcm, sizeof(pcm));
    if (n <= 0) {                                // 播完
      Serial.println("[+] 音樂播畢");
      musicStop();
      return;
    }
    int samples = n / 2;
    int16_t* s = (int16_t*)pcm;
    for (int i = 0; i < samples; i++)
      tx[i] = ((int32_t)(s[i] * musicVolume / 100)) << 16;
    size_t written = 0;
    i2s_channel_write(musicTx, tx, samples * 4, &written, 0);   // 非阻塞
    size_t consumedPcm = written / 2;            // tx bytes 是 pcm bytes 的 2 倍
    if ((int)consumedPcm < n) {
      // DMA 滿:把沒寫進去的部分倒帶,下迴圈再餵
      musicFile.seek(musicFile.position() - (n - consumedPcm));
      return;
    }
  }
}

// 選單「音樂」項目:播放 ⇄ 停止
void musicToggle() {
  if (musicPlaying) { musicStop(); return; }
  if (!sdOK) { Serial.println("[!] SD 沒掛載,不能放音樂"); return; }
  // 先找 /music/ 第一首,沒有就退回根目錄 REC_001.WAV
  String list[1];
  extern int musicListFiles(String list[], int maxN);
  if (musicListFiles(list, 1) > 0) {
    String path = String("/music/") + list[0];
    musicPlay(path.c_str());
  } else {
    musicPlay("/REC_001.WAV");
  }
}

// 列出 SD /music/ 資料夾的所有 .WAV 檔(常駐選單呼叫)
int musicListFiles(String list[], int maxN) {
  int n = 0;
  File dir = SD.open("/music");
  if (!dir) return 0;
  while (n < maxN) {
    File f = dir.openNextFile();
    if (!f) break;
    String name = f.name();
    if (name.endsWith(".WAV") || name.endsWith(".wav")) list[n++] = name;
    f.close();
  }
  dir.close();
  return n;
}
#endif


// ============================================================
// Mode 12:媒體模式(SD 影片播放,Video_Test 2026-06-12 移植)
//
// 檔案:/video/*.mjp(MJPEG)+ 同名 .wav 聲音(可無 → 無聲播放)
// 轉檔:ffmpeg -i in.mp4 -vf "scale=240:320:force_original_aspect_ratio=decrease:force_divisible_by=2,fps=15" -q:v 8 -f mjpeg xxx.mjp
//       ffmpeg -i in.mp4 -ar 32000 -ac 1 -sample_fmt s16 xxx.wav
// 操作:右搖桿選檔 → OK 播放 → 返回/OK 停止 → 模式開關撥走立刻退出
// 同步:聲音當時鐘,解碼落後 >2 幀跳幀
// ============================================================
#if ENABLE_VIDEO_MODE12
#define VID_FPS        15.0f
#define VID_FRAME_MAX  (160 * 1024)
#define VID_MAX_FILES  16

JPEGDEC  vidJpeg;
File     vidFile, vidAud;
uint8_t* vidFrameBuf  = nullptr;
bool     vidPlaying   = false;
bool     vidHasAudio  = false;
uint64_t vidAudioFed  = 0;
uint32_t vidFrameShown = 0;
unsigned long vidStartMs = 0;
String   vidList[VID_MAX_FILES];
bool     vidIsVideo[VID_MAX_FILES];   // true=/video/*.mjp,false=/music/*.wav
int      vidCount  = 0;
int      vidCursor = 0;
int      vidScroll = 0;   // 清單捲動視窗起點(一頁 7 列)
bool     mediaPaused = false;
unsigned long vidPauseStart = 0;

int vidJpegDraw(JPEGDRAW* d) {
  tft.pushImage(d->x, d->y, d->iWidth, d->iHeight, (uint16_t*)d->pPixels);
  return 1;
}

void vidScanFiles() {
  vidCount = 0;
  // 影片:/video/*.mjp
  File dir = SD.open("/video");
  if (dir) {
    while (vidCount < VID_MAX_FILES) {
      File f = dir.openNextFile();
      if (!f) break;
      String name = f.name();
      if (name.endsWith(".mjp") || name.endsWith(".MJP")) {
        vidIsVideo[vidCount] = true;
        vidList[vidCount++]  = name;
      }
      f.close();
    }
    dir.close();
  }
  // 音樂:/music/*.wav
  dir = SD.open("/music");
  if (dir) {
    while (vidCount < VID_MAX_FILES) {
      File f = dir.openNextFile();
      if (!f) break;
      String name = f.name();
      if (name.endsWith(".wav") || name.endsWith(".WAV")) {
        vidIsVideo[vidCount] = false;
        vidList[vidCount++]  = name;
      }
      f.close();
    }
    dir.close();
  }
}

void drawVideoMenu() {
  tft.fillScreen(TFT_BLACK);
  tft.fillRect(0, 0, 240, 32, TFT_NAVY);
  tft.setFont(&fonts::efontTW_24);
  tft.setTextColor(TFT_WHITE, TFT_NAVY);
  tft.setCursor(30, 4);
  tft.print("Mode 12 媒體");
  if (vidCount == 0) {
    tft.setTextColor(TFT_ORANGE, TFT_BLACK);
    tft.setCursor(10, 100);
    tft.print("SD /video /music 都空");
    return;
  }
  // 捲動視窗:一頁 7 列,游標超出視窗就捲
  const int VIS = 7;
  if (vidCursor < vidScroll)           vidScroll = vidCursor;
  if (vidCursor >= vidScroll + VIS)    vidScroll = vidCursor - VIS + 1;
  for (int r = 0; r < VIS && vidScroll + r < vidCount; r++) {
    int i = vidScroll + r;
    bool sel = (i == vidCursor);
    int y = 44 + r * 30;
    tft.fillRect(0, y, 240, 30, sel ? TFT_DARKGREEN : TFT_BLACK);
    tft.setTextColor(sel ? TFT_YELLOW : TFT_WHITE, sel ? TFT_DARKGREEN : TFT_BLACK);
    tft.setCursor(10, y + 3);
    tft.print(sel ? ">" : " ");
    tft.print(vidIsVideo[i] ? "[影]" : "[樂]");
    tft.print(vidList[i]);
  }
  // 超過一頁的提示
  if (vidCount > VIS) {
    tft.setFont(&fonts::efontTW_14);
    tft.setTextColor(TFT_DARKGREY, TFT_BLACK);
    tft.setCursor(200, 260);
    tft.printf("%d/%d", vidCursor + 1, vidCount);
  }
  tft.setFont(&fonts::efontTW_14);
  tft.setTextColor(TFT_LIGHTGREY, TFT_BLACK);
  tft.setCursor(5, 290);
  tft.print("搖桿:選 OK:播 ↑↓音量 ←退出");
}

// 播放中的音量提示(畫在頂部,影片下一幀若蓋到會自己消失)
void drawVolOverlay() {
  char buf[20];
  snprintf(buf, sizeof(buf), " 音量 %d%% ", musicVolume);
  tft.setFont(&fonts::efontTW_16);
  tft.setTextColor(TFT_YELLOW, TFT_BLACK);
  tft.setCursor(6, 4);
  tft.print(buf);
}

// 音樂播放畫面
void drawMusicScreen(const String& name) {
  tft.fillScreen(TFT_BLACK);
  tft.fillRect(0, 0, 240, 32, TFT_NAVY);
  tft.setFont(&fonts::efontTW_24);
  tft.setTextColor(TFT_WHITE, TFT_NAVY);
  tft.setCursor(30, 4);
  tft.print("音樂播放中");
  tft.setTextColor(TFT_CYAN, TFT_BLACK);
  tft.setCursor(10, 110);
  tft.println(name);
  tft.setFont(&fonts::efontTW_14);
  tft.setTextColor(TFT_LIGHTGREY, TFT_BLACK);
  tft.setCursor(5, 290);
  tft.print("↑↓音量 →暫停/繼續 ←退出");
}

// 暫停/繼續狀態顯示
void drawPauseState() {
  tft.setFont(&fonts::efontTW_24);
  tft.setTextColor(mediaPaused ? TFT_ORANGE : TFT_GREEN, TFT_BLACK);
  tft.setCursor(90, 160);
  tft.print(mediaPaused ? "[暫停]" : "[播放]");
}

void vidStop() {
  if (vidFile) vidFile.close();
  if (vidAud)  vidAud.close();
  vidPlaying  = false;
  mediaPaused = false;
  digitalWrite(PIN_AMP_SD, LOW);
}

void vidStart(const String& name) {
  vidStop();
  String base = String("/video/") + name;
  vidFile = SD.open(base, FILE_READ);
  if (!vidFile) return;
  String wav = base;                       // 同名 .wav 當聲音
  wav.replace(".mjp", ".wav");
  wav.replace(".MJP", ".WAV");
  vidAud = SD.open(wav, FILE_READ);
  vidHasAudio = (bool)vidAud;
  if (vidHasAudio) { vidAud.seek(44); digitalWrite(PIN_AMP_SD, HIGH); }
  vidAudioFed   = 0;
  vidFrameShown = 0;
  vidStartMs    = millis();
  vidPlaying    = true;
  tft.fillScreen(TFT_BLACK);
}

void vidFeedAudio() {
  if (!vidHasAudio) return;
  static uint8_t pcm[512];
  static int32_t txb[256];
  for (int round = 0; round < 16; round++) {
    int n = vidAud.read(pcm, sizeof(pcm));
    if (n <= 0) {
      // 聲音先播完:把時鐘無縫切到 millis 繼續推影像
      vidHasAudio = false;
      vidStartMs  = millis() - (unsigned long)((vidAudioFed / (float)(MUSIC_SAMPLE_RATE * 2)) * 1000);
      vidAudioFed = 0;
      return;
    }
    int samples = n / 2;
    int16_t* s = (int16_t*)pcm;
    for (int i = 0; i < samples; i++)
      txb[i] = ((int32_t)(s[i] * musicVolume / 100)) << 16;
    size_t written = 0;
    i2s_channel_write(musicTx, txb, samples * 4, &written, 0);
    size_t used = written / 2;
    vidAudioFed += used;
    if ((int)used < n) { vidAud.seek(vidAud.position() - (n - used)); return; }
  }
}

size_t vidReadFrame() {
  static uint8_t chunk[1024];
  int len = 0, prev = -1;
  bool inFrame = false;
  while (true) {
    int n = vidFile.read(chunk, sizeof(chunk));
    if (n <= 0) return 0;
    for (int i = 0; i < n; i++) {
      int c = chunk[i];
      if (!inFrame) {
        if (prev == 0xFF && c == 0xD8) { inFrame = true; vidFrameBuf[0] = 0xFF; vidFrameBuf[1] = 0xD8; len = 2; }
        prev = c;
        continue;
      }
      if (len < VID_FRAME_MAX) vidFrameBuf[len++] = (uint8_t)c;
      if (prev == 0xFF && c == 0xD9) { vidFile.seek(vidFile.position() - (n - i - 1)); return len; }
      prev = c;
    }
  }
}

void vidUpdate() {
  vidFeedAudio();
  uint32_t target = vidHasAudio
      ? (uint32_t)((vidAudioFed / (float)(MUSIC_SAMPLE_RATE * 2)) * VID_FPS)
      : (uint32_t)((millis() - vidStartMs) / 1000.0f * VID_FPS);
  if (vidFrameShown >= target) return;
  size_t len = vidReadFrame();
  if (len == 0) { vidStop(); drawVideoMenu(); return; }   // 播完回選單
  vidFrameShown++;
  if (target - vidFrameShown > 2) return;                  // 跳幀追時鐘
  if (vidJpeg.openRAM(vidFrameBuf, len, vidJpegDraw)) {
    int xoff = (240 - vidJpeg.getWidth())  / 2;
    int yoff = (320 - vidJpeg.getHeight()) / 2;
    if (xoff < 0) xoff = 0;
    if (yoff < 0) yoff = 0;
    vidJpeg.decode(xoff, yoff, 0);
    vidJpeg.close();
  }
}

void enterVideoMode() {
#if ENABLE_MUSIC
  musicStop();   // 影片聲音跟背景音樂共用 I²S,先停音樂
#endif
  if (!vidFrameBuf)
    vidFrameBuf = (uint8_t*)heap_caps_malloc(VID_FRAME_MAX, MALLOC_CAP_SPIRAM);
  tft.setSwapBytes(true);    // JPEGDEC 輸出 RGB565 little-endian,
                             // 沒這行畫面變紅綠雜訊(2026-06-12 實測)
  vidCursor = 0;
  vidScroll = 0;
  vidScanFiles();
  drawVideoMenu();
}

void exitVideoMode() {
  vidStop();
  tft.setSwapBytes(false);   // 還原,避免影響其他畫面
}

// 音量調整(播放中 ↑↓ 鍵)
void mediaVolume(int delta) {
  int v = (int)musicVolume + delta;
  if (v < 0)   v = 0;
  if (v > 100) v = 100;
  musicVolume = (uint8_t)v;
  drawVolOverlay();
}

// 暫停/繼續(→ 鍵)
void mediaTogglePause(bool hasAudioNow) {
  mediaPaused = !mediaPaused;
  if (mediaPaused) {
    vidPauseStart = millis();
    digitalWrite(PIN_AMP_SD, LOW);            // 靜音
  } else {
    vidStartMs += millis() - vidPauseStart;   // millis 時鐘補償暫停時間
    if (hasAudioNow) digitalWrite(PIN_AMP_SD, HIGH);
  }
}

void videoModeLoop(int btnEdge) {
  // --- 影片播放中 ---
  if (vidPlaying) {
    if (btnEdge == BTN_BACK)  { vidStop(); drawVideoMenu(); return; }     // ← 退出
    if (btnEdge == BTN_OK)    { mediaTogglePause(vidHasAudio); drawPauseState(); }  // → 暫停/繼續
    if (btnEdge == BTN_PLUS)  mediaVolume(+10);                            // ↑ 音量
    if (btnEdge == BTN_MINUS) mediaVolume(-10);                            // ↓ 音量
    if (!mediaPaused) vidUpdate();
    return;
  }
  // --- 音樂播放中(共用 ENABLE_MUSIC 的 musicPlay/musicUpdate)---
  if (musicPlaying) {
    if (btnEdge == BTN_BACK)  { musicStop(); mediaPaused = false; drawVideoMenu(); return; }
    if (btnEdge == BTN_OK)    { mediaTogglePause(true); drawPauseState(); }
    if (btnEdge == BTN_PLUS)  mediaVolume(+10);
    if (btnEdge == BTN_MINUS) mediaVolume(-10);
    if (!mediaPaused) {
      musicUpdate();
      if (!musicPlaying) { mediaPaused = false; drawVideoMenu(); }  // 播完回選單
    }
    return;
  }
  // --- 選單瀏覽 ---
  static unsigned long lastMove = 0;
  if (vidCount > 0 && millis() - lastMove > 250) {
    int p = centerMap(analogRead(J_PITCH), REV_PITCH);
    if (p > 240) { vidCursor = (vidCursor + 1) % vidCount;            drawVideoMenu(); lastMove = millis(); }
    if (p < 15)  { vidCursor = (vidCursor - 1 + vidCount) % vidCount; drawVideoMenu(); lastMove = millis(); }
  }
  if (btnEdge == BTN_OK && vidCount > 0) {
    if (vidIsVideo[vidCursor]) {
      vidStart(vidList[vidCursor]);
    } else {
      String path = String("/music/") + vidList[vidCursor];
      musicPlay(path.c_str());
      if (musicPlaying) drawMusicScreen(vidList[vidCursor]);
    }
  }
}
#endif  // ENABLE_VIDEO_MODE12


// ============================================================
// Mode 22:WiFi 環境掃描(被動診斷,2026-06-14)
//
// 列出附近 WiFi AP:名稱 / 訊號強度 / 通道 / 加密。純被動(只「聽」
// 不發射),合法。用 ESP32-S3 內建 WiFi,不用加任何模組。
// 操作:OK = 重新掃描、+/- = 捲動清單、模式開關撥走 = 離開
// ============================================================
#if ENABLE_WIFI_SCAN_MODE22
#define SCAN_MAX_SHOW 32

int  scanCount  = 0;
int  scanCursor = 0;
bool scanBusy   = false;

void drawScanHeader() {
  tft.fillScreen(TFT_BLACK);
  tft.fillRect(0, 0, 240, 32, TFT_DARKCYAN);
  tft.setFont(&fonts::efontTW_24);
  tft.setTextColor(TFT_WHITE, TFT_DARKCYAN);
  tft.setCursor(18, 4);
  tft.print("WiFi 環境掃描");
  tft.setFont(&fonts::efontTW_14);
  tft.setTextColor(TFT_LIGHTGREY, TFT_BLACK);
  tft.setCursor(5, 300);
  tft.print("OK:重掃  +/-:捲動  切模式:離開");
}

void drawScanList() {
  const int VIS = 8, rowH = 30;
  tft.fillRect(0, 36, 240, 260, TFT_BLACK);
  if (scanBusy) {
    tft.setFont(&fonts::efontTW_24);
    tft.setTextColor(TFT_YELLOW, TFT_BLACK);
    tft.setCursor(10, 130);
    tft.print("掃描中...");
    return;
  }
  if (scanCount <= 0) {
    tft.setFont(&fonts::efontTW_24);
    tft.setTextColor(TFT_ORANGE, TFT_BLACK);
    tft.setCursor(10, 130);
    tft.print("找不到 WiFi");
    return;
  }
  if (scanCursor > scanCount - 1) scanCursor = scanCount - 1;
  int top = scanCursor - (scanCursor % VIS);   // 簡單分頁
  for (int r = 0; r < VIS && top + r < scanCount; r++) {
    int i = top + r;
    int y = 38 + r * rowH;
    bool sel = (i == scanCursor);
    int rssi = WiFi.RSSI(i);
    // 訊號強度顏色:強綠 / 中黃 / 弱紅
    uint16_t sigColor = (rssi > -60) ? TFT_GREEN : (rssi > -75) ? TFT_YELLOW : TFT_RED;
    bool enc = (WiFi.encryptionType(i) != WIFI_AUTH_OPEN);
    if (sel) tft.fillRect(0, y, 240, rowH, TFT_NAVY);
    tft.setFont(&fonts::efontTW_16);
    // 第一行:鎖頭 + SSID(截斷)
    tft.setTextColor(sel ? TFT_WHITE : TFT_LIGHTGREY, sel ? TFT_NAVY : TFT_BLACK);
    tft.setCursor(6, y + 1);
    String ssid = WiFi.SSID(i);
    if (ssid.length() == 0) ssid = "(隱藏)";
    if (ssid.length() > 13) ssid = ssid.substring(0, 13);
    tft.printf("%s%s", enc ? "*" : " ", ssid.c_str());
    // 第二行:通道 + RSSI(上色)
    tft.setTextColor(sigColor, sel ? TFT_NAVY : TFT_BLACK);
    tft.setCursor(150, y + 1);
    tft.printf("CH%d", WiFi.channel(i));
    tft.setCursor(150, y + 14);
    tft.printf("%ddBm", rssi);
  }
  // 右下角計數
  tft.setFont(&fonts::efontTW_14);
  tft.setTextColor(TFT_DARKGREY, TFT_BLACK);
  tft.setCursor(195, 282);
  tft.printf("%d/%d", scanCursor + 1, scanCount);
}

void doScan() {
  scanBusy = true;
  drawScanList();
  WiFi.scanDelete();
  scanCount = WiFi.scanNetworks(false, true);   // 同步掃,含隱藏
  if (scanCount > SCAN_MAX_SHOW) scanCount = SCAN_MAX_SHOW;
  scanCursor = 0;
  scanBusy = false;
  drawScanList();
}

void enterScanMode() {
#if ENABLE_MUSIC
  musicStop();
#endif
  WiFi.mode(WIFI_STA);
  WiFi.disconnect();
  drawScanHeader();
  doScan();
}

void exitScanMode() {
  WiFi.scanDelete();
  // WiFi 留著(Mode 10 語音還要用),不關
}

void scanModeLoop(int btnEdge) {
  if (btnEdge == BTN_OK) { doScan(); return; }
  if (scanCount > 0) {
    if (btnEdge == BTN_PLUS  && scanCursor < scanCount - 1) { scanCursor++; drawScanList(); }
    if (btnEdge == BTN_MINUS && scanCursor > 0)             { scanCursor--; drawScanList(); }
  }
}
#endif  // ENABLE_WIFI_SCAN_MODE22


// ============================================================
// Mode 10:語音控制(2026-06-12 整合,Mode10_Test 管線移植)
//
// 架構:語音管線(錄音→WiFi→Groq Whisper→Llama→action)跑在
//   核心 0 的獨立 task;主迴圈(核心 1)50Hz 控制完全不中斷。
//   WiFi(≤2.472GHz)與 NRF CH88(2.488GHz)頻率錯開可共存。
//
// 虛擬搖桿:action 在主迴圈轉成 data.throttle/pitch/roll 覆寫。
// 安全:搖桿一動立刻搶回;move 限時;模式開關最高優先。
// ============================================================
#if ENABLE_VOICE_MODE10
// --- Demo 旗標:還不能穩飛之前,語音動作一律轉成「單馬達輕轉」 ---
// 1 = demo(起飛→轉1號、轉N號馬達→轉N號、降落/停→停轉;不碰虛擬搖桿)
// 0 = 完整飛行映射(虛擬搖桿 takeoff/hover/move/land)
#define VOICE_DEMO_SPIN  1

// --- 可調參數(拆槳地面測試後修正)---
#define VOICE_THR_HOVER  135   // 懸停虛擬油門(0~255);實測懸停點後改
#define VOICE_TILT        50   // move 搖桿偏移(50 ≈ 7.9°,MAX_ANGLE 20° 時)
#define VOICE_THR_VERT    10   // 上升/下降的油門增減
#define VOICE_PITCH_FWD   -1   // 「前進」的 pitch 偏移正負(拆槳測試確認)
#define VOICE_ROLL_RIGHT  +1   // 「右」的 roll 偏移正負(拆槳測試確認)

// (VREC_* 與 vRecBuf 宣告在檔案頂部共享區)

// ---- 虛擬搖桿程式(主迴圈端)----
enum VProg { VP_NONE, VP_TAKEOFF, VP_HOVER, VP_MOVE, VP_LAND };
VProg    vProg = VP_NONE;
unsigned long vProgT0 = 0;
uint8_t  vMoveDur = 0;
int8_t   vMx = 0, vMy = 0, vMz = 0;
uint8_t  vBaseThr = 0, vBasePitch = 127, vBaseRoll = 127;

const char* vProgName() {
  switch (vProg) {
    case VP_TAKEOFF: return "起飛中";
    case VP_HOVER:   return "懸停保持";
    case VP_MOVE:    return "移動中";
    case VP_LAND:    return "降落中";
    default:         return "搖桿控制";
  }
}

void applyVoiceOverride() {
#if VOICE_DEMO_SPIN
  // Demo:語音動作 → 單馬達輕轉指令(paramID 110/111),不碰虛擬搖桿。
  // 飛機端只在「未武裝 + 油門收底」才執行,轉 3 秒自動停。
  if (g_vFresh) {
    g_vFresh = false;
    static float spinPulse = 0;       // 每次 +10,飛機 dedup 看值變化;%10 取馬達編號
    spinPulse += 10;
    if (g_vAction == 1)      { data.paramID = 110; data.paramVal = 1        + spinPulse; }  // 起飛→轉1號
    else if (g_vAction == 5) { data.paramID = 110; data.paramVal = g_vMotor + spinPulse; }  // 轉N號馬達
    else if (g_vAction == 2 || g_vAction == 3) { data.paramID = 111; data.paramVal = spinPulse; }  // 降落/停→停轉
  }
  return;
#endif
  // 收到新動作 → 啟動程式,記錄搖桿基準
  if (g_vFresh) {
    g_vFresh = false;
    switch (g_vAction) {
      case 1: vProg = VP_TAKEOFF; break;
      case 2: vProg = VP_LAND;    break;
      case 3: vProg = VP_HOVER;   break;
      case 4: vProg = VP_MOVE;
              vMx = g_vDirX; vMy = g_vDirY; vMz = g_vDirZ;
              vMoveDur = g_vDur ? g_vDur : 2;
              if (vMoveDur > 10) vMoveDur = 10;
              break;
      default: return;   // unknown → 不動作
    }
    vProgT0 = millis();
    vBaseThr = data.throttle; vBasePitch = data.pitch; vBaseRoll = data.roll;
  }
  if (vProg == VP_NONE) return;

  // 安全 1:搖桿任何軸偏離「程式啟動時的位置」> 25 → 立刻搶回手動
  if (abs((int)data.throttle - vBaseThr)  > 25 ||
      abs((int)data.pitch    - vBasePitch) > 25 ||
      abs((int)data.roll     - vBaseRoll)  > 25) {
    vProg = VP_NONE;
    return;
  }

  float t = (millis() - vProgT0) / 1000.0f;
  int thr = VOICE_THR_HOVER, pit = 127, rol = 127;

  switch (vProg) {
    case VP_TAKEOFF:               // 1.5 秒線性升到懸停油門
      thr = (int)(VOICE_THR_HOVER * (t / 1.5f));
      if (t >= 1.5f) { vProg = VP_HOVER; vProgT0 = millis(); thr = VOICE_THR_HOVER; }
      break;
    case VP_HOVER:                 // 維持到搖桿介入 / 新指令 / 切模式
      break;
    case VP_MOVE:
      thr = VOICE_THR_HOVER + vMz * VOICE_THR_VERT;
      pit = 127 + vMy * VOICE_TILT;
      rol = 127 + vMx * VOICE_TILT;
      if (t >= vMoveDur) { vProg = VP_HOVER; vProgT0 = millis(); }
      break;
    case VP_LAND: {                // 3 秒線性收油門到 0
      float k = 1.0f - t / 3.0f;
      if (k <= 0) { thr = 0; vProg = VP_NONE; }
      else        thr = (int)(VOICE_THR_HOVER * k);
      break;
    }
    default: break;
  }
  data.throttle = (uint8_t)constrain(thr, 0, 255);
  data.pitch    = (uint8_t)constrain(pit, 0, 255);
  data.roll     = (uint8_t)constrain(rol, 0, 255);
  data.yaw      = 127;
}

// ---- 語音 task 端:HTTP 工具(Mode10_Test 移植)----
String vJsonEscape(const String& s) {
  String out; out.reserve(s.length() + 8);
  for (size_t i = 0; i < s.length(); i++) {
    char c = s[i];
    if (c == '"' || c == '\\') { out += '\\'; out += c; }
    else if (c == '\n') out += "\\n";
    else if (c == '\r') out += "\\r";
    else out += c;
  }
  return out;
}

String vJsonUnescape(const String& s) {
  String out; out.reserve(s.length());
  for (size_t i = 0; i < s.length(); i++) {
    if (s[i] == '\\' && i + 1 < s.length()) {
      char n = s[i + 1];
      switch (n) {
        case '"': out += '"'; break;  case '\\': out += '\\'; break;
        case '/': out += '/'; break;  case 'n': out += '\n'; break;
        case 'r': out += '\r'; break; case 't': out += '\t'; break;
        default:  out += n; break;
      }
      i++;
    } else out += s[i];
  }
  return out;
}

void vSetStatus(const char* s) {
  strncpy(g_vStatus, s, sizeof(g_vStatus) - 1);
  g_vStatus[sizeof(g_vStatus) - 1] = 0;
}

// PCM → WAV → Groq Whisper STT(在 task 上跑,阻塞沒關係)
String vTranscribe() {
  uint32_t audioBytes = vRecCount * 2;
  if (audioBytes == 0) return "";
  WiFiClientSecure client;
  client.setInsecure();
  client.setTimeout(12000);
  if (!client.connect("api.groq.com", 443)) { vSetStatus("STT 連線失敗"); return ""; }

  const char* boundary = "----GTXVoiceBoundary";
  String head1 = String("--") + boundary + "\r\nContent-Disposition: form-data; name=\"model\"\r\n\r\nwhisper-large-v3-turbo\r\n";
  String head2 = String("--") + boundary + "\r\nContent-Disposition: form-data; name=\"language\"\r\n\r\nzh\r\n";
  String head3 = String("--") + boundary + "\r\nContent-Disposition: form-data; name=\"response_format\"\r\n\r\njson\r\n";
  String head4 = String("--") + boundary + "\r\nContent-Disposition: form-data; name=\"file\"; filename=\"a.wav\"\r\nContent-Type: audio/wav\r\n\r\n";
  String tail  = String("\r\n--") + boundary + "--\r\n";
  uint32_t wavLen  = 44 + audioBytes;
  uint32_t bodyLen = head1.length() + head2.length() + head3.length() + head4.length() + wavLen + tail.length();

  client.printf("POST /openai/v1/audio/transcriptions HTTP/1.1\r\n");
  client.print("Host: api.groq.com\r\n");
  client.printf("Authorization: Bearer %s\r\n", GROQ_API_KEY);
  client.printf("Content-Type: multipart/form-data; boundary=%s\r\n", boundary);
  client.printf("Content-Length: %u\r\n", bodyLen);
  client.print("Connection: close\r\n\r\n");
  client.print(head1); client.print(head2); client.print(head3); client.print(head4);

  // 44-byte WAV header
  uint8_t h[44];
  memcpy(h, "RIFF", 4); uint32_t v = 36 + audioBytes; memcpy(h + 4, &v, 4);
  memcpy(h + 8, "WAVEfmt ", 8); v = 16; memcpy(h + 16, &v, 4);
  uint16_t u = 1; memcpy(h + 20, &u, 2); memcpy(h + 22, &u, 2);
  v = VREC_WAV_RATE;     memcpy(h + 24, &v, 4);
  v = VREC_WAV_RATE * 2; memcpy(h + 28, &v, 4);
  u = 2; memcpy(h + 32, &u, 2); u = 16; memcpy(h + 34, &u, 2);
  memcpy(h + 36, "data", 4); memcpy(h + 40, &audioBytes, 4);
  client.write(h, 44);

  // PCM 分塊送
  uint8_t* p = (uint8_t*)vRecBuf;
  uint32_t remain = audioBytes;
  while (remain > 0) {
    size_t n = remain > 4096 ? 4096 : remain;
    client.write(p, n);
    p += n; remain -= n;
    vTaskDelay(1);   // 每塊讓出 CPU:TLS 加密+上傳連續佔核心 0 會餓死
                     // IDLE0 觸發 task WDT 重啟(2026-06-12 實測)
  }
  client.print(tail);

  unsigned long t0 = millis();
  while (!client.available() && millis() - t0 < 12000) vTaskDelay(10 / portTICK_PERIOD_MS);
  String full = "";
  while (client.available()) { full += client.readString(); vTaskDelay(1); }
  client.stop();
  if (full.length() == 0) { vSetStatus("STT 無回應"); return ""; }
  if (full.indexOf("200") < 0 && full.indexOf("\r\n") > 0) {
    vSetStatus("STT HTTP 錯誤"); return "";
  }
  int k = full.indexOf("\"text\":\"");
  if (k < 0) { vSetStatus("STT 無結果"); return ""; }
  int s = k + 8, e = s;
  while (e < (int)full.length()) {
    if (full[e] == '\\' && e + 1 < (int)full.length()) { e += 2; continue; }
    if (full[e] == '"') break;
    e++;
  }
  String text = vJsonUnescape(full.substring(s, e));
  // 清標點(Mode10_Test 老坑)
  text.trim();
  String punct = "。,!?,.!?;:、 \"'";
  while (text.length() > 0 && punct.indexOf(text[text.length() - 1]) >= 0)
    text.remove(text.length() - 1);
  return text;
}

// 文字 → Llama → action JSON
String vParseLlama(const String& userText) {
  if (userText.length() == 0) return "";
  WiFiClientSecure client;
  client.setInsecure();
  client.setTimeout(10000);
  if (!client.connect("api.groq.com", 443)) { vSetStatus("LLM 連線失敗"); return ""; }

  String body = String("{\"model\":\"llama-3.3-70b-versatile\",\"messages\":["
    "{\"role\":\"system\",\"content\":\"你是無人機語音指令解析器。把使用者的中文輸入翻成 JSON。可用 action: takeoff(起飛)、land(降落)、move(移動,要 direction: up/down/left/right/forward/back 跟 duration_sec 1-10)、stop(停止/懸停)、spin(轉馬達,要 motor: 1-4)。聽不懂回 {\\\"action\\\":\\\"unknown\\\"}。只回 JSON。\"},"
    "{\"role\":\"user\",\"content\":\"起飛\"},{\"role\":\"assistant\",\"content\":\"{\\\"action\\\":\\\"takeoff\\\"}\"},"
    "{\"role\":\"user\",\"content\":\"降落\"},{\"role\":\"assistant\",\"content\":\"{\\\"action\\\":\\\"land\\\"}\"},"
    "{\"role\":\"user\",\"content\":\"停下來\"},{\"role\":\"assistant\",\"content\":\"{\\\"action\\\":\\\"stop\\\"}\"},"
    "{\"role\":\"user\",\"content\":\"向前飛三秒\"},{\"role\":\"assistant\",\"content\":\"{\\\"action\\\":\\\"move\\\",\\\"direction\\\":\\\"forward\\\",\\\"duration_sec\\\":3}\"},"
    "{\"role\":\"user\",\"content\":\"轉一號馬達\"},{\"role\":\"assistant\",\"content\":\"{\\\"action\\\":\\\"spin\\\",\\\"motor\\\":1}\"},"
    "{\"role\":\"user\",\"content\":\"") + vJsonEscape(userText) + "\"}],"
    "\"response_format\":{\"type\":\"json_object\"},\"temperature\":0.1}";

  client.print("POST /openai/v1/chat/completions HTTP/1.1\r\n");
  client.print("Host: api.groq.com\r\n");
  client.printf("Authorization: Bearer %s\r\n", GROQ_API_KEY);
  client.print("Content-Type: application/json\r\n");
  client.printf("Content-Length: %d\r\n", body.length());
  client.print("Connection: close\r\n\r\n");
  client.print(body);

  unsigned long t0 = millis();
  while (!client.available() && millis() - t0 < 10000) vTaskDelay(10 / portTICK_PERIOD_MS);
  String full = "";
  while (client.available()) { full += client.readString(); vTaskDelay(1); }
  client.stop();
  if (full.length() == 0) { vSetStatus("LLM 無回應"); return ""; }
  int ck = full.indexOf("\"content\":\"");
  if (ck < 0) { vSetStatus("LLM 無結果"); return ""; }
  int s = ck + 11, e = s;
  while (e < (int)full.length()) {
    if (full[e] == '\\' && e + 1 < (int)full.length()) { e += 2; continue; }
    if (full[e] == '"') break;
    e++;
  }
  return vJsonUnescape(full.substring(s, e));
}

// 從 action JSON 抽欄位 → 寫共享變數
void vEmitAction(const String& json, const String& transcript) {
  // 容錯解析:Llama 有時回美化 JSON(冒號後有空格/換行),
  // 不能假設 "key":"value" 緊貼 → 找 key 後再找冒號、再找下一對引號
  auto field = [&](const char* key) -> String {
    String pat = String("\"") + key + "\"";
    int i = json.indexOf(pat);
    if (i < 0) return "";
    int c = json.indexOf(":", i + pat.length());
    if (c < 0) return "";
    int q1 = json.indexOf("\"", c + 1);
    if (q1 < 0) return "";
    int q2 = json.indexOf("\"", q1 + 1);
    if (q2 < 0) return "";
    return json.substring(q1 + 1, q2);
  };
  String act = field("action");
  char buf[48];
  if (act == "takeoff")      { g_vAction = 1; g_vSpeak = 1; snprintf(buf, sizeof(buf), "「%s」→起飛", transcript.c_str()); }
  else if (act == "land")    { g_vAction = 2; g_vSpeak = 2; snprintf(buf, sizeof(buf), "「%s」→降落", transcript.c_str()); }
  else if (act == "stop")    { g_vAction = 3; g_vSpeak = 3; snprintf(buf, sizeof(buf), "「%s」→懸停", transcript.c_str()); }
  else if (act == "move") {
    g_vAction = 4;
    String dir = field("direction");
    g_vDirX = g_vDirY = g_vDirZ = 0;
    if (dir == "forward") g_vDirY = VOICE_PITCH_FWD;
    if (dir == "back")    g_vDirY = -VOICE_PITCH_FWD;
    if (dir == "right")   g_vDirX = VOICE_ROLL_RIGHT;
    if (dir == "left")    g_vDirX = -VOICE_ROLL_RIGHT;
    if (dir == "up")      g_vDirZ = +1;
    if (dir == "down")    g_vDirZ = -1;
    int di = json.indexOf("\"duration_sec\":");
    g_vDur = (di > 0) ? (uint8_t)json.substring(di + 15).toInt() : 2;
    snprintf(buf, sizeof(buf), "「%s」→移動 %ds", transcript.c_str(), g_vDur);
  }
  else if (act == "spin") {
    g_vAction = 5;
    int mi = json.indexOf("\"motor\":");
    int m = (mi > 0) ? json.substring(mi + 8).toInt() : 1;
    if (m < 1 || m > 4) m = 1;
    g_vMotor = (uint8_t)m;
    g_vSpeak = (uint8_t)(3 + m);   // 4~7 = motor1~4
    snprintf(buf, sizeof(buf), "「%s」→轉%d號馬達", transcript.c_str(), m);
  }
  else { g_vAction = 0; g_vSpeak = 8; snprintf(buf, sizeof(buf), "「%s」→聽不懂", transcript.c_str()); vSetStatus(buf); return; }
  vSetStatus(buf);
  g_vFresh = true;
}

// ---- 語音 task 主體(核心 0)----
void voiceTask(void* arg) {
  bool wifiStarted = false;
  for (;;) {
    if (!g_vMode10) { vTaskDelay(100 / portTICK_PERIOD_MS); continue; }

    // WiFi 連線(第一次進 mode 10 才連,之後保持)
    if (!wifiStarted) {
      vSetStatus("WiFi 連線中...");
      WiFi.mode(WIFI_STA);
      WiFi.setTxPower(WIFI_POWER_8_5dBm);
      WiFi.begin(WIFI_SSID, WIFI_PASS);
      wifiStarted = true;
    }
    if (WiFi.status() != WL_CONNECTED) {
      static unsigned long lastTry = 0;
      if (millis() - lastTry > 8000) { WiFi.disconnect(); WiFi.begin(WIFI_SSID, WIFI_PASS); lastTry = millis(); }
      vSetStatus("等待 WiFi...");
      vTaskDelay(300 / portTICK_PERIOD_MS);
      continue;
    }

    if (!g_vPTT) { vSetStatus("就緒:按住左肩鈕說話"); vTaskDelay(50 / portTICK_PERIOD_MS); continue; }

    // --- 錄音(按住期間)---
    vSetStatus("錄音中...");
    vRecCount = 0;
    i2s_channel_enable(micRx);
    static int32_t raw[256];
    while (g_vPTT && g_vMode10 && vRecCount < VREC_MAXSAMP) {
      size_t br = 0;
      if (i2s_channel_read(micRx, raw, sizeof(raw), &br, 80 / portTICK_PERIOD_MS) == ESP_OK) {
        int n = br / 4;
        for (int i = 0; i < n && vRecCount < VREC_MAXSAMP; i += 2) {   // 2:1 降採樣 32k→16k
          int32_t s = raw[i] >> 16;
          if (s > 32767) s = 32767;
          if (s < -32768) s = -32768;
          vRecBuf[vRecCount++] = (int16_t)s;
        }
      }
    }
    i2s_channel_disable(micRx);
    if (!g_vMode10) continue;

    // 太短 / 太弱不上傳
    if (vRecCount < VREC_WAV_RATE / 4) { vSetStatus("太短,再試一次"); vTaskDelay(800 / portTICK_PERIOD_MS); continue; }
    int32_t maxAmp = 0;
    for (uint32_t i = 0; i < vRecCount; i += 8) {
      int32_t a = vRecBuf[i]; if (a < 0) a = -a;
      if (a > maxAmp) maxAmp = a;
    }
    if (maxAmp < 100) { vSetStatus("訊號太弱,再試一次"); vTaskDelay(800 / portTICK_PERIOD_MS); continue; }

    // --- STT + 解析 ---
    vSetStatus("辨識中...");
    String text = vTranscribe();
    if (text.length() == 0) { vTaskDelay(800 / portTICK_PERIOD_MS); continue; }
    vSetStatus("解析中...");
    String json = vParseLlama(text);
    if (json.length() == 0) { vTaskDelay(800 / portTICK_PERIOD_MS); continue; }
    vEmitAction(json, text);
  }
}

// ---- 主迴圈端 UI ----
void drawVoiceStatic() {
  tft.fillScreen(TFT_BLACK);
  tft.fillRect(0, 0, 240, 32, TFT_MAROON);
  tft.setFont(&fonts::efontTW_24);
  tft.setTextColor(TFT_WHITE, TFT_MAROON);
  tft.setCursor(14, 4);
  tft.print("Mode 10 語音控制");
  tft.setFont(&fonts::efontTW_14);
  tft.setTextColor(TFT_LIGHTGREY, TFT_BLACK);
  tft.setCursor(5, 296);
  tft.print("按住左肩鈕說話,搖桿一動即手動");
}

void enterVoiceMode() {
#if ENABLE_MUSIC
  musicStop();        // 錄音時不放音樂(回授 + I²S 雙工單純化)
#endif
  vProg = VP_NONE;
  drawVoiceStatic();
  g_vMode10 = true;
}

void exitVoiceMode() {
  g_vMode10 = false;
  g_vPTT    = false;
  vProg     = VP_NONE;
  // WiFi 保持連線(下次進來免等);要省電再說
}

void voiceModeUi() {
  static char lastStatus[48] = "";
  static VProg lastProg = VP_LAND;   // 故意不同,首次必畫
  static unsigned long lastTele = 0;

  if (strcmp(lastStatus, g_vStatus) != 0) {
    strncpy(lastStatus, g_vStatus, sizeof(lastStatus));
    tft.fillRect(0, 50, 240, 60, TFT_BLACK);
    tft.setFont(&fonts::efontTW_24);
    tft.setTextColor(TFT_CYAN, TFT_BLACK);
    tft.setCursor(8, 60);
    tft.print(lastStatus);
  }
  if (vProg != lastProg) {
    lastProg = vProg;
    tft.fillRect(0, 130, 240, 40, TFT_BLACK);
    tft.setFont(&fonts::efontTW_24);
    tft.setTextColor(vProg == VP_NONE ? TFT_WHITE : TFT_GREEN, TFT_BLACK);
    tft.setCursor(8, 138);
    tft.printf("%s  油門 %d", vProgName(), data.throttle);
  }
  if (millis() - lastTele > 500) {   // 遙測 2Hz 更新
    lastTele = millis();
    tft.fillRect(0, 190, 240, 30, TFT_BLACK);
    tft.setFont(&fonts::efontTW_16);
    tft.setTextColor(teleOK ? TFT_LIGHTGREY : TFT_RED, TFT_BLACK);
    tft.setCursor(8, 196);
    if (teleOK)
      tft.printf("R%+.1f P%+.1f 高 %.1fm", tele.roll / 10.0f, tele.pitch / 10.0f, tele.altitude_dm / 10.0f);
    else
      tft.print("飛機未連線");
  }
}
#endif  // ENABLE_VOICE_MODE10


// ============================================================
// 常駐選單(任何 mode TFT 下方 30px 區域常駐顯示)
//
// 開啟:#define ENABLE_PERSISTENT_MENU 1
// 進入:肩鍵 L 長按 1 秒
// 操作:+ - 切換項目,OK 進入該功能,返回 退出
// 項目:音樂、亮度(預留,MSP2806 LED 直連 3V3 無法軟控)、系統資訊
//
// 設計上跟 mode 0 的 PID 選單分開:那是「設定」,常駐選單是「附屬功能」
// ============================================================
#if ENABLE_PERSISTENT_MENU
enum PMItem { PM_MUSIC, PM_BRIGHTNESS, PM_INFO, PM_COUNT };
const char* PM_NAMES[PM_COUNT] = { "音樂", "亮度", "系統資訊" };

bool          pmActive       = false;
int           pmCursor       = 0;
unsigned long pmShoulderDown = 0;   // 用來偵測長按

void persistentMenuUpdate() {
  bool shldL = (digitalRead(SHOULDER_L) == LOW);
  if (shldL) {
    if (pmShoulderDown == 0) pmShoulderDown = millis();
    else if (millis() - pmShoulderDown > 1000 && !pmActive) {
      pmActive = true;
      // TODO:暫停其他 UI 重畫,畫常駐選單
    }
  } else {
    pmShoulderDown = 0;
  }
  // pmActive 時 + - 改 cursor,OK 進入該功能,返回 退出
  // TODO
}

void persistentMenuDraw() {
  // 在 TFT 底部畫常駐選單
  // TODO:fillRect 區域 + 畫 PM_NAMES[pmCursor]
}
#endif


// ============================================================
// ============================================================
//        以上 feature 旗標都 0,以下空函式不會被呼叫
// ============================================================
// ============================================================
