avav10985/flightflight/測試程式/遊戲/NES_Test/NES_Test.ino

// ============================================================
// NES_Test — 手把跑 NES 模擬器(arduino-nofrendo)
//
// === 需要的函式庫(git clone 到 Documents/Arduino/libraries)===
//   arduino-nofrendo(moononournation)
//   Arduino_GFX    (moononournation)
//
// === SD 卡 ===
//   根目錄放一個 .nes ROM(會自動找第一個)。
//   ⚠ 版權:請用 homebrew 免費遊戲測試。
//
// === 操作 ===
//   右搖桿上下 = 上/下   左搖桿左右 = 移動
//   右肩鈕 = A   按鍵叢「+」= B(左肩備用 B)
//   按鍵叢 OK = Start   按鍵叢 返回 = Select
//
// === 硬體 ===
//   全部沿用手把現有接線,不用改線
// ============================================================

#include <esp_wifi.h>
#include <esp_task_wdt.h>
#include <SPI.h>
#include <SD.h>
#include "hw_config.h"

extern "C"
{
#include <nofrendo.h>
}

SPIClass spiSD(HSPI);   // SD 獨立 SPI3(同 Ground_TX:SCK15 MISO47 MOSI17 CS0)

int16_t bg_color;
extern void display_begin();
extern void display_message(const char *msg);

void setup()
{
  // Serial 最先(USB 模式除錯用;hwcdc 要等列舉)
  Serial.begin(115200);
  delay(1500);
  Serial.println("=== NES_Test boot ===");

  // 顯示初始化:畫面變深灰 = 有跑到這(電池模式除錯用)
  display_begin();
  display_message("display OK");

  // 上次重啟原因:抓「圖標出現又消失」是不是崩潰重開迴圈
  {
    esp_reset_reason_t rr = esp_reset_reason();
    const char* rs = (rr == ESP_RST_POWERON) ? "poweron" :
                     (rr == ESP_RST_PANIC)   ? "PANIC!" :
                     (rr == ESP_RST_TASK_WDT)? "TASK WDT!" :
                     (rr == ESP_RST_INT_WDT) ? "INT WDT!" :
                     (rr == ESP_RST_BROWNOUT)? "BROWNOUT!" :
                     (rr == ESP_RST_SW)      ? "sw-reset" : "other";
    char buf[40];
    snprintf(buf, sizeof(buf), "last reset: %s", rs);
    display_message(buf);
    delay(800);   // 給時間看清楚
  }

  esp_task_wdt_deinit();  // 模擬器主迴圈會佔滿 CPU,關看門狗
  display_message("wdt off");

  // MAX98357A 開聲音(平常拉低靜音,模擬器要出聲)
  pinMode(PIN_AMP_SD, OUTPUT);
  digitalWrite(PIN_AMP_SD, HIGH);
  display_message("amp on");

  // SD:獨立 SPI3 @20MHz,掛載到 /fs 讓 nofrendo 用 C fopen 讀 ROM
  display_message("SD init...");
  spiSD.begin(15, 47, 17, 0);
  pinMode(0, OUTPUT);
  digitalWrite(0, HIGH);
  if (!SD.begin(0, spiSD, 20000000, FSROOT))
  {
    Serial.println("SD 掛載失敗");
    display_message("SD mount failed!");
    while (1) delay(1000);
  }
  display_message("SD OK");
  FS filesystem = SD;

  // 找根目錄第一個 .nes
  File root = filesystem.open("/");
  char *argv[1];
  bool foundRom = false;
  static char fullFilename[256];
  if (root)
  {
    File file = root.openNextFile();
    while (file)
    {
      if (!file.isDirectory())
      {
        char *filename = (char *)file.name();
        int len = strlen(filename);
        if (len > 4 && strstr(strlwr(filename + (len - 4)), ".nes"))
        {
          foundRom = true;
          sprintf(fullFilename, "%s/%s", FSROOT, filename);
          Serial.println(fullFilename);
          argv[0] = fullFilename;
          break;
        }
      }
      file = root.openNextFile();
    }
  }

  if (!foundRom)
  {
    Serial.println("SD 根目錄找不到 .nes ROM");
    display_message("No .nes ROM on SD root!");
    while (1) delay(1000);
  }

  display_message("ROM found, NES start!");
  delay(500);
  Serial.println("NoFrendo start!");
  nofrendo_main(1, argv);
  Serial.println("NoFrendo end!");
}

void loop() {}
