avav10985/flightflight/(commit log)

2026-05-16 第一版嘗試
2026-05-16 新增初版電路
2026-05-17 新增完整電路圖、電源擴充板、紀錄整理
    - drone_schematic_full.png：完整版含 GPS / BMP280 / VL53L0X / 影像
    - breakout_pcb.png：仿市售模組風格電源擴充板（含 I²S 預留）
    - export_conversation.py 加 --clean 與 --since 旗標
    - 對話紀錄三段去重，零重疊
2026-05-20 飛控陀螺儀除錯與對話第 4 部分
    - Drone_FC_Gyro.ino 加 ENABLE_NRF24/ESC 條件編譯與原始感測值除錯輸出
    - 加入使用者新版 6 通道發射/接收電路圖
    - 對話紀錄第 4 部分（接線、姿態驗證、I²C 分組討論）
2026-05-24 新增接線指南、擴充板移除蜂鳴器、忽略截圖
    - 接線指南.md：14 章 + 2 附錄，涵蓋安全、分階段接線、軟體流程、待辦清單
    - breakout_pcb 移除蜂鳴器輸出改為預留（語音回應現階段不做）
    - .gitignore 加上 Windows 截圖檔名 pattern
2026-05-24 分階段程式：Gyro / Manual / PID 三段獨立檔
    - Drone_FC_Gyro：階段 1 純陀螺儀讀取（去除 NRF24/ESC/PID 程式碼）
    - Drone_FC_Manual：階段 2 手動油門控制（含 NRF24 + ESC）
    - Drone_FC_PID：階段 3 PID 自穩 + 序列埠即時調參
    - 開機統一加陀螺儀偏移自動校正（300 筆平均）
2026-05-25 西西又改
2026-05-25 PID 調參完成 + 軸對齊 + 水平基準 + aux2 觸發校正
    - MPU6050 軸對齊：accRoll 用 +X，accPitch 用 -Y，gRoll/gPitch 對應翻號
    - 開機自動水平基準校正（解決 MPU6050 沒裝水平）
    - PID 增益寫死：Kp_rp=2.0、Ki_rp=0.02、Kd_rp=0.5、Kp_y=1.5、Ki_y=0.02
    - aux2 邊緣觸發重新校正（不用拔 USB / 鍵盤打字）
2026-05-25 新增 Drone_FC_Full 完整版（BMP280 / GPS / VL53L0X 預留）+ 對話第 6 部分
    - Drone_FC_Full.ino：在 PID 基礎上加 ENABLE_BMP280 / ENABLE_GPS / ENABLE_VL53L0X 三組旗標
    - 三組感測器先寫好初始化、讀值、debugPrint 顯示，未整合進 PID
    - aux2 觸發校正、PID 增益已寫死最佳值
2026-05-25 停止追蹤 Claude Code 本機設定
    .claude/settings.local.json 會被 Claude Code 自動修改，
    加入 .gitignore 避免噪音 commit。
    本機檔案保留（git rm --cached）。
2026-05-26 一些測試
2026-05-26 GPS 加衛星 SNR + 藍牙輸出、ESP32-CAM 飛行版
    - GPS_Test：解析 $GPGSV 顯示每顆衛星 PRN + 訊號強度
    加 BluetoothSerial（裝置名 GPS_TEST_D32），手機 App 可看
    - ESP32CAM_Flight：Station 模式連固定熱點、QVGA 流暢、失敗退回 AP、LED 狀態指示
    - 對話紀錄第 7 部分
2026-05-27 刪除過時 FlightController、新增程式說明、ESP32-CAM 即時調畫質、擴充板移除 LED
    - 刪 Drone_FlightController（已被 Drone_FC_Full 取代）
    - 新增 程式說明.md：4 支飛控程式 + 測試程式完整說明報告
    - ESP32CAM_Flight 加網頁即時調解析度/畫質（不用重燒）
    - 擴充板 PCB 移除 LED + 1kΩ（不裝），只留 C1/C2
2026-05-27 雙向遙測 + ESP32 地面站 + Mode 2 搖桿 + 接線圖
    - Drone_FC_PID：NRF24 改雙向 ACK，回傳遙測（姿態/電量/武裝），
    可接收地面傳來的 PID 參數，加電池監測（GPIO34）
    - Ground_TX：固定翼佈局改成四軸 Mode 2，加 REV_xxx 方向反轉設定
    - Ground_TX_ESP32：新地面站（雙搖桿 + 雙向 NRF24 + LCD 2004A + PID 選單）
    - drone_wiring2.png / ground_wiring.png：兩端完整接線圖
2026-05-27 對話紀錄第 8 部分
2026-05-28 程式說明更新：雙向遙測、ESP32 地面站、電池監測、進度同步
    - Drone_FC_PID 補上 NRF24 雙向 ACK 遙測、收 PID 參數、電池電壓監測
    - 地面端拆成 Nano 備援版與 ESP32 主力版（LCD + PID 選單 + 接腳表）
    - 系統架構圖改為雙向通訊 + ESP32 地面站
    - 進度表同步：ESP32-CAM 即時調畫質完成、GPS 衛星數待提升
2026-05-28 新增進度確認表（程式/硬體/實測三欄）
    合併原本散在程式說明與接線指南的進度記錄，單一來源追蹤。
    飛機端 MPU6050/NRF24/ESC 已標實測完成。
2026-05-28 新增手把系統規格：9 模式 + 肩鍵 yaw + 拆彈簧油門 + 電阻階梯
    ESP32 主力地面站改版設計藍圖（待硬體接好再實作）：
    - 兩個 3 段開關組 9 模式（00 校準/安全、01 角度自穩、02~08 未設定）
    - yaw 移到 L/R 肩鍵（±60°/s）、油門搖桿拆彈簧純當油門
    - 開機須先切到 00 才解鎖（仿真實遙控器）
    - 選單按鈕走類比電阻階梯、選單僅在 mode 00 進入
    - 含接腳分配、NRF24 封包改動、飛機端要改的函式
2026-05-28 對話紀錄第 9、10 部分
    第 9 部分：5/27 18:23→5/28 15:35（舊 session 未記尾段）
    第 10 部分：5/28 15:36 起本次對話（進度表、手把系統規格）
    已掃描無隱私資料。
2026-05-31 新增 手把V2_討論摘要.md：跳過 V1 直接做 V2 的硬體規劃
    - 使用者已備齊：ESP32-S3-N16R8 + MAR2406 TFT + SD 模組 + I²S 語音元件
    - 定案決定：手把不做電池監測、LCD_RST 接 3V3、SD 共用 NRF24 SPI、分 V2-A/V2-B 階段
    - V2-A 完整腳位分配（26 腳，舒服）
    給接手對話讀的延續文件。
2026-06-01 飛機端改 9 模式封包：mode/flags + 開機 LOCK + 進 mode 0 校正
    封包 aux1/aux2 改成 mode/flags：mode 0=安全/校準、mode 1=手動自穩、
    mode 2~8 預留未實作。新增 safetyReleased 開機鎖（需先切 mode 0
    解除才允許武裝），校正改由「進 mode 0 邊緣」觸發（取代舊 aux2）。
    mode 1~8 中只有 mode 1 已實作可飛；mode 2~8 一律拒武裝。
    為手把 V2-A 的 9 模式 + 肩鍵 yaw + 拆彈簧油門架構準備封包對齊。
2026-06-01 跳過 V1，直接做 V2-A 手把：ESP32-S3 + MAR2406 並列 TFT
    2026-05-29 討論定案跳過 V1（30-pin WROOM + 2004A 字元 LCD），
    直接做 V2-A：ESP32-S3-N16R8 + MAR2406 2.4" 320×240 並列 8-bit
    ILI9341 TFT。Ground_TX_ESP32 從 LiquidCrystal_I2C 改寫成 LovyanGFX
    （per-sketch config，免改 library），腳位全換到 S3 對應。
    新增：
    - 手把接線總表_V2.md：完整逐 pin 接線表 + 元件對元件對照 + 11 顆
    電阻 + 4 顆電容 + AB/C 板分配
    - make_handle_v2_layout.py + handle_v2_a_board_layout.png：
    9×15cm 橫向 A 板走線示意圖
    - Ground_TX_Test：輸入測試 sketch（搖桿/開關/按鈕逐組驗證）
    V1 文件（手把系統規格.md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
2026-06-01 ESP32-CAM 加固定 IP + mDNS，WiFi 帳密搬到 secrets.h
    固定 IP 10.160.190.50（依手機熱點 10.160.190.99 gateway 設定，
    旗標 USE_STATIC_IP 可關回 DHCP）；mDNS 名稱 dronecam.local，
    IP 變了還連得到。WiFi 帳密從 .ino 搬到 ESP32CAM_Flight/secrets.h
    （已 gitignore），AP 備援改成非敏感的 DroneCAM/drone1234。
    .gitignore 加上：
    - secrets.h / **/secrets.h（WiFi 帳密等機密）
    - .claude/（整個資料夾，含 settings.json，避免本機路徑進 git）
2026-06-01 停止追蹤對話紀錄/，改本機保留不進 git
    對話紀錄是本機開發筆記，包含日常對話內容，不適合放公開 repo。
    .gitignore 加上「對話紀錄/」整個資料夾。本機檔案保留，git 不再追蹤。
    注意：過去 commit（第 5/8/9/10 部分）已在 git 歷史裡，
    本次只阻止未來 + 移除目前追蹤，**不清除歷史**。
    若要徹底從歷史移除需 git filter-repo + force push（不可逆）。
2026-06-01 手把架構升級：C 板當被動元件樞紐（全部電阻 + 肩鍵集中過去）
    把 11 顆電阻全部從 B/A/TFT 轉接小板搬到 C 板，B 板從此沒電阻；
    肩鍵實體鎖在外殼上半部、訊號終點移到 C 板，B 板也沒肩鍵了。
    連接方式：
    - A↔C：26 條杜邦線（4 組排針:電源3 + TFT11 + SPI/SD4 + B訊號8）,
    方便整片 A 板拔下來燒/換,不用拆 TFT
    - C↔B：11 條排線（多 1 條因為選單鈕「非 3V3 腳」變各自獨立拉
    到 C 板的電阻網,少 2 條因為肩鍵搬走）
    C 板現在的元件：TFT MAR2406 + 11 顆電阻 + 2 顆肩鍵終點 + 排針/排座
2026-06-02 Drone_FC_PID_legacy 加 WiFi Debug AP:免線看即時遙測
    飛機端開 WiFi AP「DroneDebug」(密碼 drone1234,channel 1 避開 NRF24
    ch100 不會干擾),用瀏覽器連 192.168.4.1 即時看:
    - Roll / Pitch / YawRate 角度
    - Throttle 數值 + 對應 PWM
    - ARMED 狀態
    - PID 三軸輸出(rollOut / pitchOut / yawOut)
    - 當前 PID 增益(Kp/Ki/Kd)
    - MAX_ANGLE / MAX_YAWRATE 設定
    每 0.3 秒自動 refresh,免接 USB 線就能調 PID。
    適合在外面只有手機/筆電的情況下飛飛機 + 看數據。
2026-06-02 TFT 改 MSP2806 SPI 直立:省 9 隻 GPIO + 排針整齊
    買了 MSP2806 2.8" SPI ILI9341 取代原本 MAR2406 並列 8-bit:
    - 並列 11 隻 GPIO（D0~D7+RS/WR/CS）→ SPI 只剩 2 隻獨立腳（CS=48、DC=21）
    - SCK/MOSI/MISO 跟 NRF24/SD 共用同一條 SPI 匯流排
    - GPIO 11~18 全部釋出（可給 V2-B 或其他擴充）
    - A↔C 杜邦線從 26 條降到 17 條
    - 排針單排 14 隻 2.54mm，完全對齊洞洞板，免做 TFT 轉接小板
    - 沒有 MAR2406 那個 5V 電平轉換臨界值問題
    程式變更（Ground_TX_ESP32.ino）：
    - LGFX class 從 Bus_Parallel8 改 Bus_SPI（bus_shared=true）
    - setRotation(0) 直立 240×320
    - drawFlight 重排：頂部模式列 + 三段大字姿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
2026-06-02 手把接線總表_V2.md:把 §一~§九 殘留的 MAR2406 全數更新成 MSP2806
    之前的 commit 只改了開頭幾節（§〇 簡表、§〇 元件對元件、§四 供電半段）,
    這次把詳細段也對齊新硬體:
    - §一 材料清單：MAR2406 標註備用,新增 MSP2806 主用
    - §二 完整腳位表：GPIO 11~18 / 47 標「釋出」,21 改 DC、48 改 CS
    - §三 TFT 細節：整段改寫成 MSP2806 SPI 14 隻排針
    - §四 供電圖：TFT VCC 改走 3V3 軌（推薦）,RESET 用 R10 上拉
    - §九.1/9.2 左右 22 隻 pin：原 TFT D0~D7 / WR 全部改「釋出」標籤
    - §九.6 TFT 細節：MAR2406 → MSP2806（單排排針,免轉接小板）
    - §九.7 SD 卡座：標籤對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
2026-06-02 註明 MSP2806 是全尺寸 SD 座(不是 microSD)
    實際看過 MSP2806 才發現它的 SD 卡座是全尺寸 SD(32×24mm,
    相機那種大的),不是 microSD。要用 microSD 卡的話必須先插
    轉接卡。
    對程式跟接線完全無影響(對 ESP32 來說都只是「一張 SD 卡」),
    只是焊接/使用時要知道這個前提,免得買錯卡或忘記轉接卡。
2026-06-02 手把 SD 改用獨立 microSD 模組(避開 MSP2806 全尺寸 SD 頂搖桿)
    MSP2806 板上的 SD 座是全尺寸 SD(32×24mm),卡會凸出去頂到搖桿,
    所以改用獨立 microSD 卡模組(之前那顆預備的),放在 C 板上。
    變更:
    - C 板元件清單加 microSD 卡模組
    - §九.7 改寫成「microSD 卡模組(放 C 板,獨立模組)」
    - §三 TFT 細節:板上 SD 卡座標「不用,留空」
    - §〇 SD 卡座那段:標明 MSP2806 內建 SD 不用,改走獨立模組
    - 把「JINHUA」這個店名拿掉(改成通用 ESP32-S3 N16R8 描述)
    對程式完全沒影響:CS=GPIO 0、SCK/MOSI/MISO 共用,
    跟之前用 TFT 內建 SD 一模一樣。
    是否實際接 SD 模組由使用者後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
2026-06-02 SD 卡改成兩個選項擇一(MSP2806 內建 SD 或獨立 microSD 模組)
    使用者:可能還是會用 MSP2806 背面的 SD 座,先把兩個都規劃進去
    等試裝後再決定哪個。
    - §〇 SD 那段:改成「A 案:MSP2806 內建全尺寸 SD」+
    「B 案:獨立 microSD 模組」二擇一,共用 SCK/MOSI/MISO,
    只 CS 二擇一接到 GPIO 0。⚠️ 兩個 CS 都接會打架。
    - §三 TFT 細節:板上 SD 座從「不用」改成「二選一」。
    - §五 元件清單:microSD 模組從必選改選用,加備註說明擇一。
    - §九.7:重寫成「兩個選項擇一接 CS」,A/B 各列腳位表。
    - 加「先佈線、後決定」做法:兩條 CS 都先預留接點,試裝後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
2026-06-02 左搖桿 X 軸接回 GPIO 10:當作可選 yaw 來源(預設仍肩鍵)
    使用者要把左搖桿的 X 軸(VRx)從原本「不接」改成接 ADC,
    跟肩鍵之間二選一當 yaw 控制:預設用肩鍵,程式選單可切換到
    左搖桿 X 軸。實際選單 UX 等手把實體做好再加。
    接線變動:
    - 左搖桿 VRx → ESP32-S3 GPIO 10(ADC1_CH9)
    - A↔C 杜邦線 17 → 18 條(多 1 條左 X)
    - C↔B 排線 11 → 12 條(多 1 條左 X)
    - 腳位 26 → 27 隻
    - V2-B I²S 保留腳 5 → 4 隻(剛好夠 BCLK/WS/DIN/DOUT)
    - 沒加任何電阻 / 電容 / 模組
    更新檔:
    - 手把接線總表_V2.md:〇/二/三/9.1/9.8/9.9/9.10/9.11/9.12/9.13/9.16/9.19
    - 手把V2_討論摘要.md §4 腳位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
2026-06-02 TFT MSP2806 從 C 板搬到 B 板:訊號走 4 條副排線
    使用者:螢幕本來就要裝在前面板,跟搖桿同一片(B 板)。
    TFT 14 隻排針的訊號用獨立 4 條副排線從 B 拉到 C 板,
    不擠原本的 12 條主排線。
    架構變動:
    - C 板:從「電阻中繼樞紐 + TFT」變「純電阻中繼 + 訊號分歧點」
    - TFT MSP2806 + 1×14 母排座移出 C 板
    - 多 1 個 4 條副排線接座(對 B)
    - 11 顆電阻全留 C 板,但 R10(原 RESET 上拉)變備用無功能
    - B 板:從「純輸入」變「前面板 = 輸入 + TFT」
    - 加 1×14 母排座(插 MSP2806 排針)
    - 多 1 個 4 條副排線接座(對 C,給 TFT 訊號)
    - 增加 MSP2806 螢幕本體(從 C 搬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
2026-06-02 TFT MISO 加回來:副排線 4 → 5 條
    使用者問了「省掉的線功能是甚麼」之後決定 MISO 還是要接。
    功能:LovyanGFX init 時讀 TFT 晶片 ID 確認是 ILI9341,
    debug 時可以分辨是訊號問題還是 panel 問題。
    1 條的代價值得。
    R10 那邊維持備用(RESET 直接接 B 板 3V3 軌不變)。
    電源全部用 3V3 軌維持跟訊號同位準(別接 5V,
    免得踩 ILI9341 的 HIGH 門檻 0.7×VCC = 3.5V 邊緣)。
    - 手把接線總表_V2.md:〇/二/三 TFT/9.6/9.16/副排線表
    全部從「4 條 CS/DC/SCK/MOSI」改成「5 條 + MISO」
    - 材料清單:5 條短排線
    - TFT VCC 註記從「3V3 或 5V 都可」改成「必須 3V3,不要 5V」
    Co-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
2026-06-02 R10 加回實際功能:副排線 5 → 6 條 (多 RESET)
    使用者:反正也沒差,把 R10 接回去當 TFT RESET 上拉。
    RESET 線路:
    - B 板 TFT RESET → 副排線 #6 → C 板 R10 一端
    - R10 另一端 → C 板 3V3 軌(10kΩ 上拉)
    - 平常拉高 = 不重置
    - 保留未來加 GPIO 控制 RESET 的彈性
    副排線變動:5 → 6 條
    - #1 CS
    - #2 DC
    - #3 SCK
    - #4 MOSI
    - #5 MISO
    - #6 RESET (新)
    11 顆電阻全部恢復實際功能(R10 不再是備用)。
    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
2026-06-02 V2-B I²S 改用釋出腳 11-14:兩條 debug 都保留
    使用者抓到計畫遺漏:MSP2806 SPI 換掉 MAR2406 並列後,
    GPIO 11~18 全部釋出,但 V2-B「擇一犧牲 debug」的舊規則沒更新。
    事實上 9 隻釋出腳遠多於 I²S 需要的 4 隻,根本不必犧牲。
    I²S 新指派(用 MSP2806 SPI 換來的釋出腳):
    - GPIO 11 = BCLK
    - GPIO 12 = WS / LRCLK
    - GPIO 13 = DOUT (到 MAX98357A DIN)
    - GPIO 14 = DIN (從 INMP441 SD)
    Debug 序列埠都活著:
    - GPIO 19/20 = native USB CDC (USB-C 直接接電腦)
    - GPIO 43/44 = UART0 (CH-340 USB-C)
    真正釋出可用 5 隻:GPIO 15、16、17、18、47(給 V2-C/D)
    V2-A 27 隻 + V2-B 4 隻 = 31 隻,還剩 5 隻可擴充。
    -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
2026-06-02 SD 定案用獨立 microSD 模組:不再二擇一
    使用者決定:就用獨立 microSD 模組(放 C 板)。MSP2806 內建
    全尺寸 SD 座永遠空著別插卡(卡凸出去會頂到旁邊的搖桿)。
    更新:
    - 〇 元件清單:microSD 模組從「選用/二擇一」改成「定案」,
    說明 MSP2806 內建 SD 座空著不用
    - 三 SD 卡接法:整段重寫,移除 A 案/B 案的兩個選項
    - 三 TFT 細節:板上 SD 卡座改成「永遠空著別插卡」
    - 9.7 SD 卡逐 pin 接法:只剩獨立 microSD 模組一個版本
    - 9.16 TFT 訊號清單:板上 SD CS 改成「不接」
    - 9.1/9.2 ESP32 對外腳:GPIO 0 描述改為直接接獨立 microSD CS
    - 一 材料清單:MSP2806 SD 座加註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
2026-06-02 加 TFT LED PWM 背光控制:GPIO 15,副排線 6→7 條
    使用者:背光想要可以調亮度(LED PWM 控制)。
    選 GPIO 15 (釋出腳裡第一個,LEDC PWM 5kHz/8-bit)。
    線路變動:
    - A↔C 杜邦:18 → 19 條(多一條「TFT LED PWM」)
    - C↔B 副排線:6 → 7 條(多一條 LED 訊號)
    - TFT LED 從「B 板 3V3 軌常亮」改成「副排線 #7 → C 板 → A 板 GPIO 15 PWM」
    - V2-A 用 17 → 18 個 GPIO
    - 釋出腳:5 → 4 個(15 被用掉,剩 16/17/18/47)
    程式:
    #define TFT_LED_PIN 15
    ledcAttach(TFT_LED_PIN, 5000, 8); // 5kHz, 8-bit
    ledcWrite(TFT_LED_PIN, 200); // 0~255 控亮度
    PWM 頻率 5kHz 在副排線上不會有 EMI 問題,LED 板上又有限流電阻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
2026-06-03 GPIO 2 ↔ GPIO 10 對調:左搖桿訊號集中右側、右搖桿集中左側
    使用者觀察:之前 GPIO 1/2 都在 ESP32 右側但分屬左右搖桿、
    GPIO 4/10 都在左側也分屬左右搖桿,線路會跨來跨去。
    對調 GPIO 2 和 GPIO 10 後規律變清爽:
    ESP32 右側 = 左搖桿訊號 (throttle=GPIO 1 + yaw=GPIO 2)
    ESP32 左側 = 右搖桿訊號 (pitch=GPIO 10 + roll=GPIO 4)
    兩隻都是 ADC1(GPIO 2=ADC1_CH1、GPIO 10=ADC1_CH9),電氣等效,
    只是物理位置不同。對程式來說只是 pin define 換一下,
    LovyanGFX/搖桿讀取邏輯完全不變。
    接線/排線 #編號不變(只是訊號到 ESP32 後面接的 GPIO 不同):
    - A↔C 杜邦的「左 X」訊號 →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
2026-06-03 IMU 校準系統改版:NVS 持久化 + 拆 quick/full + 動作偵測
    之前 calibrateGyro() 每次開機重做 1.5 秒,而且把 gyro 偏移和
    水平基準(level)校在一起,「地面也不平」的時候會把地面歪度
    寫進 levelOffset。
    新設計把校準拆成兩種:
    1. 快速 calibrateGyroQuick() — 0.3 秒,60 取樣
    - 只算 gyro 漂移(每次開機都會變)
    - 不動 levelOffset
    - 觸發時機:開機 / 進 mode 0 那瞬間 / aux2 邊緣(legacy)
    / Serial "cal"
    2. 完整 calibrateFull() — 1.5 秒,300 取樣
    - gyro + level 都重算
    - 觸發時機:首次開機(NVS 沒資料)/ flags bit0 邊緣(V2)
    / Serial "calfull"
    兩種都會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
2026-06-03 飛機端加 GPS (GY-NEO6MV2) + telemetry 擴展 + status 分位元
    兩版同步:
    - Drone_FC_PID.ino (V2 協定)
    - Drone_FC_PID_legacy.ino (V1 6-byte 協定)
    GPS 整合:
    - 接 ESP32 UART2:GPIO 16(RX2)←GPS TX、GPIO 17(TX2)→GPS RX
    - 9600 baud (NEO-6M 預設)
    - TinyGPSPlus 解析 NMEA
    - 開機就啟動,持續餵 readGPS(),不管哪個 mode 都讀
    - 5 秒沒新資料 → gps_fix 變 false(顯示 ---)
    - 冷啟動 30~120 秒,天線朝天
    Telemetry 擴展 (Drone_FC_PID.ino 才有, legacy 沒 ACK 回傳):
    - 10 bytes → 18 bytes
    - 新增 satCount (uint8)、lat_e7 / lon_e7 (int32,經緯度 ×10^7)
    - status byte 從只放 armed 改成多 bit:
    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
2026-06-03 Drone_FC_Full 升級到 PID 等級:成為最終版主程式
    把 Drone_FC_PID(2026-06-04 commit 9c14959 的版本)所有改進
    完整移植到 Drone_FC_Full,並保留原 Full 的 BMP280 / VL53L0X
    骨架。Full 從此是「燒上飛機的最終版本」,PID 維持當前主力試飛。
    完整移植進 Full 的功能(原本 Full 沒有的):
    - V2 9 模式封包 (mode / flags / paramID / paramVal)
    - safetyReleased + 9-mode arming logic (modeFlyable / disarm)
    - NRF24 雙向 ACK Payload + Telemetry struct (18 bytes)
    - IMU NVS 校準系統 (loadCalibration / saveCalibration / clearCalibration)
    - 校準拆 quick / full + 動作偵測 + status 旗標
    - 電池監測 (PIN_BAT_ADC=34, BAT_DIVIDER=4.0)
    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
2026-06-03 修正 mode 編碼前後不一致 + Telemetry 兩端對齊
    對話紀錄裡明確寫過 mode 是「兩個 3 段開關組合的兩位數編碼」
    (SW_A 十位 + SW_B 個位, 9 個離散值 00/01/02/10/11/12/20/21/22),
    但程式碼裡到處還寫成「0~8 連續整數」。多次被使用者糾正過。
    這次徹底整理。
    ## Bug A:手把 mode 編碼公式錯
    Ground_TX_ESP32.ino line 411:
    byte mode = readSwitch3(SW_A) * 3 + readSwitch3(SW_B); // ← 錯
    改成:
    byte mode = readSwitch3(SW_A) * 10 + readSwitch3(SW_B); // 對
    之前撥到 SW_A=1/SW_B=0(預期 mode 10 語音), 手把實際送 byte 3,
    飛機端收到的數值跟使用者設計的 mode 對不上。
    ## Bug B:MODE_NAME[9] 陣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
    [Drone_FC_Full.ino, Ground_TX_ESP32.ino]
2026-06-03 Drone_FC_Full 加 Mode 02 GPS 導航數學 + 狀態機骨架(暫不真飛)
    可以「直接寫的程式部分」:純數學 + 狀態機,不依賴 hardware,
    Serial 印計算結果讓使用者驗證。**不會啟動 mode 02 飛行**——
    modeFlyable() 仍只接 mode 01,撥到 mode 02 飛機不 arm。
    加進來的內容:
    ## 資料結構
    - struct Waypoint {double lat; double lon; float alt; bool active;}
    - targetWP / homeWP 兩個 global
    - enum NavState (IDLE/CRUISE/APPROACH/LANDING/LANDED/FAILED)
    - navState global
    ## 純數學函式
    - haversineDistance(lat1, lon1, lat2, lon2) → 米
    - bearingDegrees(lat1, lon1, lat2, lon2) → 度(0~360,北=0)
    - angleDiffDeg(target, current) → -180~+180
    #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
    [Drone_FC_Full.ino]
2026-06-05 Ground_TX_ESP32 補三項硬體對齊:GPIO 2↔10 swap + LED PWM
    V2-A 硬體做好了要試燒,程式補上之前討論過但沒進去的硬體改動。
    維持最小變動,不加常駐選單 / 音樂 / yaw 子選單那些(等試燒
    通了再加,避免一次塞太多 debug 不到)。
    ## 改動
    1. **J_PITCH 從 GPIO 2 改 GPIO 10**(對應接線表的 GPIO 2↔10 swap):
    - 右搖桿 Y(pitch)現在在 ESP32 左側 #16
    - 之前撥右搖桿 pitch 會讀到 GPIO 2(沒接東西)變垃圾值,現在對
    2. **加 J_LEFT_X = GPIO 2**(左搖桿 X 軸,可選 yaw):
    - 只 #define 不讀也不送(Mode 01 yaw 子選單還沒實作)
    - 之後加母選單時可以直接 analogRead(J_LEFT_X)
    3. **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
    [Ground_TX_ESP32.ino]
2026-06-05 撤回 TFT LED PWM 設計:MSP2806 LED 直接接 3V3 軌常亮
    試燒驗證(2026-06-06):
    - MSP2806 LED 腳跟 VCC 量電阻**不通**(內部沒連)
    - LED 接 GPIO 15 + ledcAttach PWM **背光不會亮**
    - LED 直接拉 3V3 軌 → 背光正常亮
    結論:MSP2806 這款 LED 設計是「使用者外接電源」型,不是
    「PWM 控電晶體」型。所以 commit 046e2b9 加 LED PWM 是錯的,
    撤回。
    ### Ground_TX_ESP32.ino
    - 刪掉 `ledcAttach(PIN_TFT_LED, 5000, 8)` + `ledcWrite(PIN_TFT_LED, 200)`
    兩行(無效程式)
    - 刪掉 `#define PIN_TFT_LED 15`
    - 註解寫清楚 LED 直接接 3V3 軌、GPIO 15 回歸真正釋出
    ### 手把接線總表_V2.md
    - 副排線 7 條 → **6 條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
2026-06-05 LGFX 配置改用 tyty 證實能跑的寫法(pin_rst=16, miso=-1)
    對話紀錄 ref: 使用者燒 tyty/tyty.ino 成功點亮 MSP2806 TFT(ILI9341),
    要求我們的 Ground_TX_ESP32.ino LGFX 配置照 tyty 寫法清理。
    ## 改動(LGFX class 設定)
    | 項 | 之前 | 之後(同 tyty) |
    |--|--|--|
    | pin_miso | 40 | **-1**(不接,反正用不到 readback) |
    | pin_rst | -1(passive R10 上拉) | **16**(GPIO 主動驅動 hardware reset) |
    | memory_width | 沒設 | **240** |
    | memory_height | 沒設 | **320** |
    | dummy_read_pixel | 8 | (移除,用預設) |
    | dummy_read_bits | 1 | (移除,用預設) |
    ## 保留不動(我們共用 SPI 必要)
    - pin_sclk = 38, pin_mosi = 39(跟 NRF24/SD 共用)
    - pin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
    [Ground_TX_ESP32.ino]
2026-06-05 加 Ground_TX_Test_TFT:tyty 寫法 + 我們的腳位,獨立 TFT 測試
    使用者要求:把 tyty 裡面的腳位改成我們用的腳位獨立測試 TFT。
    從 tyty/tyty.ino 改寫,**LGFX 配置一模一樣只換腳位**:
    | 腳 | tyty | 本檔(我們手把) |
    | SCK | 8 | 38 |
    | MOSI | 18 | 39 |
    | MISO | -1 | -1 |
    | DC | 17 | 21 |
    | CS | 15 | 48 |
    | RST | 16 | 16 (同 tyty) |
    bus_shared = false(獨立測試,不共用 SPI),其他全照 tyty。
    不含 NRF24 / SD / 搖桿 / 開關等其他功能,純驗證:
    - LGFX 配置在我們手把腳位下能跑
    - TFT VCC 焊接修好後能正常 init 顯示
    - pin_rst = 16 主動驅動 RESET 配置正確
    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
2026-06-05 TFT setRotation 0 → 2:實體上下顛倒翻轉
    試燒驗證:TFT 接好亮起來後畫面整個顛倒。
    原因:MSP2806 的「LCD 邏輯第 0 行」在我們手把安裝方向上是
    「下面」,所以 rotation 0 看起來像上下顛倒。改 rotation 2 翻 180°
    讓畫面方向跟使用者視角一致。
    兩個檔同步:
    - Ground_TX_ESP32.ino:setRotation(2)
    - Ground_TX_Test_TFT.ino:setRotation(2)
    LovyanGFX setRotation 對應:
    0 = 0° (預設,LCD 原始方向)
    1 = 90° (橫向)
    2 = 180° (上下顛倒,我們用這個)
    3 = 270° (橫向,反方向)
    如果之後手把外殼裝反 / TFT 反裝,只要改這個數字即可,
    完全不用動電路。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
2026-06-05 手把:模式上下對調 + 選單死區加寬 + UI 全面中文化
    試燒實機驗證後三個 bug 修 + 一個改善:
    ## 修 1:模式 mode 上下對調
    readSwitch3() 把 v > 2730 跟 v < 1365 對應的回傳值對調。
    原本上=0/下=2,實體上下顛倒,改成上=0/下=2(交換邏輯)。
    之前:撥到下出 mode 0 → 飛機進安全模式
    之後:撥到上才出 mode 0(符合手把方向)
    ## 修 2:PID 選單游標自己跳
    handleMenuCursor() 死區從 55/200 加寬到 15/240。
    原因:搖桿物理中位偏離 ADC center,靜止時讀值落在 55~200 範圍
    觸發誤判,游標自動往下跑。
    之前:輕微偏中也會跳游標
    之後:要把搖桿推到接近底才動游標,靜止不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
    [Ground_TX_ESP32.ino]
2026-06-05 關掉 ESP32-S3 板上 WS2812 RGB LED(GPIO 48 跟 TFT CS 共腳)
    使用者反應 ESP32-S3 板上很亮的 RGB LED 一直亮影響使用,
    記得之前燒程式時這個 LED 是熄的,所以是軟體可控的。
    WS2812 RGB LED 在 ESP32-S3 開發板上通常接 GPIO 48(跟我們 TFT CS
    同一隻)。在 tft.init() 之前送一次 neopixelWrite(48, 0,0,0) 把
    LED 關掉,然後 GPIO 48 切換成 SPI CS 給 TFT 用。WS2812 會保持
    上次的狀態(關),除非有別的訊號用 WS2812 的時序(~1.25µs/bit)
    寫進新顏色。
    SPI CS 切換速度很快(納秒級),WS2812 不會誤判成顏色指令,
    所以可以共存。
    如果使用者的板上 RGB LED 不在 GPIO 48,改 neopixelWrite() 第一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
2026-06-05 加 Voice_Test:一次驗證 INMP441 + MAX98357A + 喇叭 + SD + TFT 四件
    使用者裝完 V2-B 語音模組後要試運作,寫了一支獨立測試程式
    一次驗證:
    - INMP441 麥克風收音
    - MAX98357A 放大 + 喇叭出聲
    - SD 卡讀寫
    - TFT 顯示 + 按鈕導航
    - ESP32 I²S 全雙工(BCLK/WS 共用,DIN/DOUT 各自)
    ## 操作邏輯
    - 肩鍵 L: 開始錄音 / 停止錄音(自動上限 30 秒)
    - + / -: 在 SD 檔案清單上下移動游標
    - OK: 播放選中的檔
    - 返回: 停止播放 / 重新掃描 SD
    ## 技術重點
    ### I²S 配置(I2S_NUM_0 全雙工)
    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
2026-06-06 修編譯錯誤:efontTW_20 不存在,改用 efontTW_24
    LovyanGFX 的 efontTW 系列只有 10 / 12 / 14 / 16 / 24 五種大小,
    沒有 efontTW_20。前一次 commit b395780(中文化)誤用了不存在的
    名稱,Voice_Test.ino 編譯時報錯:
    error: 'efontTW_20' is not a member of 'fonts';
    did you mean 'efontTW_24'?
    兩個檔案都修:
    - Ground_TX_ESP32.ino(4 處)
    - Voice_Test.ino(3 處)
    efontTW_20 全部改成 efontTW_24(本來想用中等字級但沒有,
    直接用大的)。字會稍微變大但 32px 標題列跟 46px 選單列都
    還塞得下。
    [Ground_TX_ESP32.ino, Voice_Test.ino]
2026-06-06 加 INM_Test:純粹單獨測 INMP441 麥克風是否還活著
    照 jmaker blog 概念(https://blog.jmaker.com.tw/esp32-inmp441/)
    寫一支極簡單的測試,**只接 INMP441 + ESP32-S3**,別的什麼都
    不接(沒 TFT、沒 SD、沒 NRF24、沒 MAX98357A、沒搖桿等等)。
    腳位用我們手把設計:
    SCK = GPIO 11 (blog 是 26)
    WS = GPIO 12 (blog 是 22)
    SD = GPIO 14 (blog 是 21)
    ## 為什麼要這支
    使用者把 V2-B 接好後,接 INMP441 上電就 brown-out reset loop,
    拔掉 INMP441 就穩定 → INMP441 嫌疑最大。但我們之前一次接上
    所有元件無法確認是 INMP441 自己壞了,還是周圍接線有問題。
    這支測試把所有變數隔離,**只剩 INMP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
    [INM_Test.ino]
2026-06-06 加 SD_Test:極簡 SD 卡單獨測試程式
    使用者裝完 SD 模組(6 條線接 ESP32),Voice_Test 一直印
    「SD 掛載失敗」,但搞不清楚是接線、R11、卡本身、還是
    別的問題。Voice_Test 同時初始化 TFT/I²S 等東西,debug 訊息
    混雜難判讀。
    寫一支極簡測試,**只測 SD,沒別的**:
    - 列出實際用的 4 隻 GPIO (CS=0, SCK=38, MOSI=39, MISO=40)
    - 嘗試掛載 SD
    - 印出卡類型(MMC/SDSC/SDHC)+ 容量
    - 列出根目錄檔案
    - 寫入 /TEST.TXT 一行字 → 讀回印出來,驗證讀寫都 OK
    失敗的話 Serial 印出 5 個常見原因,讓使用者照順序檢查:
    1. R11 沒接(GPIO 0 浮空)
    2. SPI 線接錯腳
    3. SD 卡沒插模組
    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
2026-06-06 SD CS 改用 GPIO 47:右側可用且不需要上拉電阻
    使用者反應 GPIO 5 在 ESP32 左側,線要繞到對面 SD 模組(SPI 線
    都在右側)很麻煩,想改用右側的腳。
    ESP32-S3-N16R8 限制(右側):
    - GPIO 26~37 被 OCTAL PSRAM 永久佔用,不能用
    - GPIO 1/2 = 搖桿
    - GPIO 38/39/40 = SPI SCK/MOSI/MISO 共用
    - GPIO 41/42 = NRF24 CE/CSN
    - GPIO 21 = TFT DC
    - GPIO 43/44 = UART(會佔 Serial,不能拿)
    - GPIO 45/48 = strapping / TFT CS
    右側真正自由的只有 **GPIO 47**(以及 GPIO 0 但要 R11)。
    改 PIN_SD_CS:
    - Voice_Test.ino:5 → 47
    - SD_Test.ino:0 → 47
    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
2026-06-06 Voice_Test LGFX pin_miso 從 -1 改成 40:修 SD 共用 SPI 時掛載失敗
    使用者確認:
    - PIN_SD_CS = 47(commit a26cbdf 改的版本)
    - SD CS 實體線在 ESP32 GPIO 47
    - SD_Test(沒 LovyanGFX)可以掛載成功
    - 但 Voice_Test(有 LovyanGFX)SD 掛載失敗
    兇手:LGFX 配置 pin_miso = -1。
    原本想說 TFT 不讀 MISO 所以設 -1,但問題在共用 SPI 時:
    1. tft.init() 佔走 SPI2_HOST,內部把 MISO 註冊為「空」(GPIO 矩陣 不分配)
    2. SPI.begin(38, 40, 39, -1) 嘗試 重新註冊 MISO=40,但 SPI 已被 LovyanGFX 佔住,
    ESP-IDF GPIO 矩陣 可能拒絕重新映射
    3. SD.begin() 透過 SPI 讀資料,但 MISO 沒接到 GPIO 40 → 永遠收不到回應 → 掛載失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
2026-06-06 Voice_Test 改 init 順序:SD 先 / TFT 後,讓 SD 先佔 SPI 設定
    使用者試燒 commit ac9c1c6(pin_miso 改 40)依然 SD 掛載失敗。
    跟 SD_Test(沒 LovyanGFX)行為對比,只剩可能是 LovyanGFX 的
    tft.init() 先佔走 SPI peripheral,然後 SPI.begin() 重新註冊 MISO
    失敗。
    修法:**顛倒 init 順序**:
    - 之前:tft.init() → SPI.begin() → SD.begin()
    - 之後:SPI.begin() → SD.begin() → tft.init()
    這樣 SD 在 SPI 還沒被任何人佔的時候先註冊 MISO=40,正常掛載。
    之後 LovyanGFX 用 bus_shared=true 加入共用,SD 跟 TFT 都能用。
    副作用:tft.init() 之前不能在 TFT 上顯示「初始化中」訊息,
    改成只用 Serial 印。SD 失敗時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
2026-06-06 加 SPK_Test:純粹單獨測 MAX98357A + 喇叭
    使用者準備去買新 INMP441 + 磁力計,出門前想先確認手邊
    MAX98357A 跟喇叭沒燒,免得買回來才發現還有別的壞掉。
    寫一支極簡單測試,**只接 MAX98357A + 喇叭**:
    - 沒 TFT、沒 SD、沒 INMP441、沒按鈕
    - 程式內部產生 440 Hz(中央 A,「La」音)正弦波
    - 透過 I²S 推給 MAX98357A → 喇叭應該連續發出「嗶~」音
    腳位:
    BCLK = GPIO 11
    WS = GPIO 12
    DOUT = GPIO 13
    I²S 配置:
    - I2S_NUM_0,只用 TX,沒 RX
    - 16-bit slot mode(MAX98357A 接受 16/24/32 都行,16 最簡單)
    - slot_mask = BOTH(送 L+R 兩聲道讓 MAX98357A SD 浮空時的 mono mix 模式有滿幅輸出)
    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
2026-06-06 手把主程式套用 SD 測試結論 + 飛機端加 GY-271 磁力計骨架
    ## 手把 Ground_TX_ESP32.ino
    試燒一整天的結論整合進來:
    1. **LGFX pin_miso -1 → 40**:共用 SPI 時 SD 才拿得到 MISO
    試燒實證:不設 40,LovyanGFX 把 MISO 註冊為「無」,後續
    SPI.begin 重新分配 MISO 失敗,SD.begin() timeout 掛載失敗
    2. **PIN_SD_CS 0 → 47**:避開 BOOT 腳,不再需要 R11 上拉
    GPIO 0 是 BOOT 腳,沒上拉容易進燒錄模式;GPIO 47 是右側
    真正釋出腳,單純接 SD CS 用最方便
    3. **setup() 順序顛倒**:之前 TFT → SPI → SD,改成 SPI → SD → TFT
    TFT 先 init 會佔走 SPI peripheral,SD 後來加入拿不到正確設定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
2026-06-06 加 Mode 10/11/音樂/常駐選單/4顆 VL53L0X 全部骨架(ENABLE 旗標 = 0)
    使用者授權「不用問直接寫」,把之前討論過但還沒實作的 feature
    全部寫個骨架,用 ENABLE_XXX 旗標 = 0 編譯時不啟用。等硬體 / API
    key 齊全再改 1 就能跑。
    ## 手把 Ground_TX_ESP32.ino 加四個 feature
    ### Mode 11:PC 控制(USB CDC bridge)
    - ENABLE_PC_MODE11 旗標
    - PcCommand 13-byte struct(throttle/pitch/roll/yaw/mode/flags/paramID/paramVal)
    - pcBridgeUpdate():從 USB Serial 讀指令覆蓋 Signal、回送 Telemetry
    - PC 端 app 建議 Python + pyserial + pygame.joystick
    ### Mode 10:AI 語音控制
    - ENABLE_VOICE_MODE10 旗標
    - 需要 secrets.h(WIFI_SSID/PASS、W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
2026-06-06 Voice_Test 採樣率 16 kHz → 32 kHz,修 INMP441 BCLK 不到規格的怪雜訊
    使用者試錄音 + 播放,Voice_Test 跑得起來但「聲音很雜亂」。
    原因:INMP441 datasheet 規格 BCLK 範圍 1.45 ~ 3.27 MHz。
    我們之前用 16 kHz 採樣 + 32-bit slot mode 算出:
    BCLK = 16000 × 32 × 2 = 1.024 MHz ← 低於規格最小 1.45 MHz
    晶片在規格外工作行為不定,可能輸出怪雜訊。
    這也解釋為什麼 INM_Test 看 RMS 條會跳(資料有變化),
    但實際錄成 WAV 播出來是雜訊(信號失真)。
    修法:採樣率提高到 32 kHz:
    BCLK = 32000 × 32 × 2 = 2.048 MHz ✓ 在規格內
    副作用:
    - 檔案大小 × 2(從 32 KB/sec → 64 KB/sec)
    - 30 秒最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
2026-06-06 Voice_Test 兩個調整修雜訊:降增益 + 加大 DMA buffer
    提到 32 kHz 後使用者回報還是雜訊很多,32 kHz 改動不是真兇。
    ### 1. 錄音增益降低(>> 14 → >> 16)
    之前 >> 14 = 放大 4 倍,如果使用者說話大聲容易爆音 → 飽和裁切
    產生「沙啞 / 失真」雜音。
    改 >> 16 = 不放大,直接取 INMP441 24-bit 的高 16 bit。
    代價是錄音音量會小一點,但訊號乾淨不爆音。
    ### 2. I²S DMA buffer 加大(45ms → 128ms)
    預設 dma_desc_num=6 × dma_frame_num=240 = 1440 frames ≈ 45ms @ 32kHz
    TFT 每 250ms 重畫一次,如果重畫 + SD 寫入 卡到 SPI > 45ms,
    I²S RX DMA buffer 就會滿溢丟資料 → 喀啦喀啦的數位雜訊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
2026-06-06 加 Play_Test:純粹 SD → I²S → 喇叭 播放測試
    使用者證實:Voice_Test 錄的 WAV 拷貝到 PC 上播放是乾淨的,
    代表錄音端 OK,**雜訊出在 ESP32 端的播放**。
    寫一支極簡測試,**只測播放路徑**:
    - 不接 TFT(SPI 不會被 LovyanGFX 鎖)
    - 不接 INMP441(I²S RX 不啟用)
    - 不讀按鈕、不畫面
    - 開機就循環播放 SD 上 /REC_001.WAV
    如果這支播得乾淨 → 確認 Voice_Test 雜訊是「TFT/SD/I²S 互相搶
    SPI 跟 timing」造成
    如果還是雜訊 → 純播放路徑本身就有問題(MAX98357A 跟 SD 共用
    SPI 時序問題,或 32-bit slot 轉換有 bug)
    I²S 大 DMA buffer(8 desc × 512 frames = 128ms @32kHz)避免
    SD 讀延遲時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
    [Play_Test.ino]
2026-06-06 加 sketch.yaml 鎖定 ESP32-S3 開發板設定到 8 個 sketch 資料夾
    使用者反映:每次切換 sketch 都要重設 ESP32-S3 Dev Module 一堆選項
    (Partition Scheme、PSRAM、Flash 等),很煩。
    寫 sketch.yaml(arduino-cli 標準 profile 檔)鎖定 FQBN,Arduino IDE
    2.x 開啟 sketch 時會自動套用,完全不用手動進 Tools 設定。
    加到這 8 個 ESP32-S3 sketch 資料夾:
    - Voice_Test
    - INM_Test
    - SD_Test
    - SPK_Test
    - Play_Test
    - Ground_TX_ESP32
    - Ground_TX_Test_TFT
    - tyty
    FQBN 包含的設定:
    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
2026-06-06 加 Button_Test:全部手把輸入元件測試,順便校準階梯按鈕門檻
    使用者試 Voice_Test 時發現「按 - 鈕也會觸發 OK 鈕」,代表選單階梯
    按鈕的 ADC 門檻不對。寫一支測試專門 dump 所有輸入的原始 ADC 值,
    讓使用者照實際讀值修正門檻。
    測試對象(全部 V2-A 輸入):
    - SW_A 三段開關 GPIO 5
    - SW_B 三段開關 GPIO 6
    - 選單階梯 GPIO 7(類比 + / − / OK / 返回)
    - 肩鍵 L GPIO 8
    - 肩鍵 R GPIO 9
    Serial 每 200ms 印一行,例如:
    SW_A=中(2048) SW_B=上( 100) 選單=- (1900) 肩L=放 肩R=放 mode=01
    「- (1900)」這欄會用現有門檻判,加上實際 ADC 值。使用者按 -
    看實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
    [Button_Test.ino]
2026-06-06 Button_Test 加搖桿讀取(2 顆 × 2 軸 = 4 個類比輸入)
    使用者要求把搖桿也加進測試。
    新增 4 個類比讀取:
    - J_THROTTLE GPIO 1 左搖桿 Y(油門)
    - J_LEFT_X GPIO 2 左搖桿 X(可選偏航)
    - J_ROLL GPIO 4 右搖桿 X(翻滾)
    - J_PITCH GPIO 10 右搖桿 Y(俯仰)
    輸出格式合併成一行(寬但完整):
    A=中(2048) B=上( 100) 選單=無( 50) 肩L=放 肩R=放 |
    左[Y油門=2048 X偏航=2050] 右[X翻滾=2030 Y俯仰=2055] | mode=01
    每個搖桿軸:
    - 中位約 ~2048(電位器分壓中點)
    - 推到底約 4095 或 0(看方向)
    - 死區應該在 ±200 內(搖桿物理中位偏移)
    可以用來確認:
    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
2026-06-06 階梯按鈕門檻取中點 + 搖桿 J_ROLL/J_PITCH 對調對應實際接線
    ## 1. 階梯按鈕門檻調整(取中點而不是邊界)
    使用者試燒實測:
    - + 量到 3810~3850(舊門檻 >3250)
    - − 量到 2640~2690(舊 >2415)
    - OK 量到 1910~1940(舊 >1665)
    - 返回 量到 1160~1200(舊 >640)
    舊門檻邊界靠近實測值,瞬間切換按鈕時可能掃到中間值誤觸。
    取「相鄰實測值的中點」當新門檻,邊緣最穩:
    - + > 3300(中點 3250 ~ 3850 → 取 3300)
    - − > 2300
    - OK > 1550
    - 返回 > 600
    3 個檔案同步:Ground_TX_ESP32.ino、Voice_Test.ino、Button_Test.ino
    ## 2. 搖桿 J_ROLL / J_PITCH 對調
    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
2026-06-07 手把試燒 4 修:返回鈕重畫 + 游標方向 + 飛行畫面 dirty flag 減閃爍
    使用者實機試燒 commit 14b5c39 後 4 個問題:
    ## 1. 返回 PID 鈕後 mode 區跑掉
    handleMenuButton 處理 BTN_BACK 只 fillScreen(BLACK),沒重畫
    飛行畫面的 navy 標題列跟 darkgrey 底部列 → 變黑底白字看起來怪。
    fix:改成呼叫 drawFlightStatic()。
    ## 2. PID 選單推下,游標往上跑
    handleMenuCursor 用 centerMap(..., false),沒套 REV_PITCH,
    跟飛行 mode 的 pitch 方向不一致 → 推下 raw ADC 小 → p < 15
    → menuCursor-- (上) 跟使用者直覺反了。
    fix:改成 centerMap(..., REV_PITCH) 跟飛行 mode 同方向。
    ## 3. 主畫面閃爍
    drawFlightDyn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
    [Ground_TX_ESP32.ino]
2026-06-07 加 飛機接線總表.md(V2 速查格式,跟手把接線總表 同風格)
    使用者要求「跟之前(手把接線總表_V2)那樣給接線表全部」,寫飛機端
    速查格式的接線文件,以下用途:
    - 跟舊版 接線指南.md(737 行階段教學) 互補:舊版講「怎麼接 +
    驗證流程」,新版講「對照查 GPIO/元件 即得接線」
    - 加 2026-06-06 後的新元件:GY-271 磁力計、VL53L0X×4(從 2 顆擴
    到 4 顆對應 Mode 02 設計)
    - 跟 手把接線總表_V2.md 同風格(架構速覽、腳位表、各元件、共線)
    內容:
    - 〇 安全規則(0 階段就要遵守的 6 條)
    - 〇 全系統架構速覽(電池 → ESC + buck → ESP32)
    - 一、ESP32 38 隻腳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
2026-06-07 飛機 GPS GPIO 16/17 對調:對應使用者實際接線
    使用者試燒前先按實際飛機端佈線方便,把 PIN_GPS_RX 跟
    PIN_GPS_TX 兩個 GPIO 編號對調:
    - 原:PIN_GPS_RX = 16, PIN_GPS_TX = 17(對應 ESP32 預設 RX2/TX2)
    - 新:PIN_GPS_RX = 17, PIN_GPS_TX = 16
    ESP32 UART 透過 GPIO matrix 可以指定任何 GPIO 當 RX/TX(不受
    預設 TX2/RX2 標籤限制),Serial2.begin(9600, SERIAL_8N1, RX, TX)
    兩個參數會自動指派。
    接線:
    GPS TX → ESP32 GPIO 17(ESP32 接收)
    GPS RX ← ESP32 GPIO 16(ESP32 傳送)
    UART 依然交叉(GPS TX 對 ESP32 RX、GPS RX 對 ESP32 TX),
    只是 GPIO 編號跟之前對調。
    - Drone_FC_Full.ino #define PIN_GPS_RX/PIN_GPS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
2026-06-07 I²C 速度從 400 kHz 降到 100 kHz:對應飛機 30cm 主幹保險
    使用者飛機機架大小限制,ESP32 → TCA9548A 主幹 杜邦線 約 30cm。
    I²C Fast mode 400 kHz 的電容預算約 400 pF,30cm 長線材 + 多個
    模組板上的上拉電阻 並聯 + 焊點 + 母排座,累計電容跟 EMI 干擾
    都比較吃力。
    把 Wire.setClock 改成 100 kHz(I²C Standard mode):
    - 電容預算更鬆(實際上 100 kHz 規格也是 400 pF,但邊緣較慢更
    能容忍 EMI 跟長線材)
    - 慢 4 倍,但對我們應用沒影響:
    - MPU6050 / BMP280 / GY-271 讀取頻率不變(都是 KB 級別資料)
    - VL53L0X 取樣率 30 Hz 還是夠用
    - 飛行控制迴圈 ~ 200 Hz,I²C 讀感測器約 5ms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
    [Drone_FC_Full.ino]
2026-06-07 GPS 從 UART2 預設腳(16/17)搬到 GPIO 32/33
    使用者按實際飛機端佈線方便,把 GPS 的 RX/TX 腳從 ESP32 預設
    TX2=17/RX2=16 換到 GPIO 32/33。
    ESP32 UART 透過 GPIO matrix 可以指定任何 GPIO 當 RX/TX,
    Serial2.begin(9600, SERIAL_8N1, RX, TX) 兩個參數會自動指派。
    接線(交叉,UART 必然):
    GPS TX → ESP32 GPIO 33(ESP32 接收)
    GPS RX ← ESP32 GPIO 32(ESP32 傳送)
    - GPIO 16/17 從「GPS UART」變回「釋出可用」,以後加擴充元件
    可考慮這兩隻
    - GPIO 32/33 從「ADC1 可用」變成「GPS UART 專用」
    - 兩者都是 ADC1 通道,GPS 不會去動 ADC 功能
    - Drone_FC_Full.ino PIN_GPS_RX = 33, PIN_GPS_TX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
2026-06-07 MPU6050 註明 5V 跟 3V3 都吃(GY-521 模組板上有 LDO)
    使用者反映既有的 MPU6050 接 5V 不是 3V3,我之前寫 3V3 太保守。
    常見的 GY-521 MPU6050 模組板上有 LDO(MIC5205 / AMS1117-3V3),
    VCC 輸入 3V3 跟 5V 都能用,模組會自動降壓給晶片。
    I²C 訊號:板上 SDA/SCL 上拉電阻接到內部 3V3(LDO 出來),
    不是接到 VCC,所以即使 VCC = 5V,I²C 線電位還是 3V3,
    跟其他接 3V3 的 I²C 元件(BMP280/GY-271/TCA9548A)共線安全。
    加註解提醒:只有「GY-521 模組」可以 5V,裸 MPU6050 IC 只能 3V3,
    超壓會燒晶片(InvenSense 規格 max VDD = 3.46V)。
2026-06-07 修編譯錯:debugPrint() 用舊的 distFront/distBack,改成 tofDist[] 4 顆陣列
    commit d6f4250 把 VL53L0X 從 2 顆(distFront_mm / distBack_mm)擴
    成 4 顆(tofs[4] / tofDist[4] 陣列),漏改 debugPrint() 裡一行
    還用舊變數名稱,使用者啟用 ENABLE_VL53L0X=1 編譯報錯:
    'distFront_mm' was not declared in this scope
    改成印 4 顆距離,標籤對應前中(C)、前左(L)、前右(R)、底部(D):
    | ToF C 123 L 456 R 789 D 234 mm
2026-06-07 debugPrint 頻率 200ms → 1000ms:debug 階段慢下來方便看 Serial
    使用者試燒回報「Serial 跑太快看不到」+「每 5 秒重啟」。
    為了讓使用者看清楚 reset 之前最後幾行訊息,把 debugPrint
    頻率從 5 Hz 降到 1 Hz。
    實際飛行時可能還要回 200ms 較高頻(姿態變化看得清楚),
    但 debug 階段 1 Hz 夠用。
    [Drone_FC_Full.ino]
2026-06-07 MAX98357A SD 改 GPIO 17 控制,休眠時消除「沙沙」雜訊
    使用者反映「手把喇叭有時會有噪音」+ 開機就持續「沙沙」+ TFT 也閃,
    代表 5V/3V3 軌雜訊耦合進 MAX98357A,而 D 類擴大機在 SD 浮空
    (預設 mono mix 模式)時就算 I²S 送 0,內部高頻切換還是會在
    喇叭輸出有持續沙沙。
    修法:MAX98357A SD(shutdown 控制)從浮空改成 ESP32 GPIO 17 控制,
    不播放時拉低 → 晶片進休眠 → 完全靜音 → 沒沙沙。
    MAX98357A SD 腳 → ESP32 GPIO 17(剛釋出可用)
    三個 ino 同步:
    ### Voice_Test.ino
    - PIN_AMP_SD = 17,setup 預設 LOW(休眠)
    - startPlay() 設 HIGH(啟用)
    - stopPlay() 設 LOW(休眠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
2026-06-07 MAX98357A SD 從 GPIO 17 改 GPIO 18:對應使用者接線
    使用者選擇接 ESP32-S3 GPIO 18(原本我寫 17),3 檔同步:
    - Voice_Test.ino PIN_AMP_SD 17 → 18
    - SPK_Test.ino 同上
    - Ground_TX_ESP32.ino 同上
    兩隻腳都是真正釋出可用,GPIO 18 也沒衝突。
2026-06-07 加 Drone_Test:飛機端元件獨立測試,不需要連手把
    使用者要求「不連遙控器就測試飛機端元件」。Drone_FC_Full 雖然
    也會印感測器讀值,但要 NRF24 連線才能完整跑(且模式機制複雜
    不適合單純 debug)。寫一支簡化版專門做飛機端 元件 驗證:
    ## 設計
    - **不啟用 NRF24**(排除手把通訊變數)
    - 全部感測器 init(MPU6050 / BMP280 / VL53L0X×4 / GY-271 / GPS / 電池 ADC)
    - 4 顆 ESC init,預設 PWM 1000(停)
    - 每秒自動印一行 IMU + Bat + GPS 衛星數(讓使用者看到「活著」)
    - Serial 指令觸發各種元件詳細讀值
    - Serial 指令手動控制 4 顆 ESC PWM(測馬達轉向用)
    ## Serial 指令
    - help /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
2026-06-07 Voice_Test 加 TFT cache,減少 TFT/SD 搶 SPI 造成的雜訊跟畫面閃
    使用者試燒實證:Play_Test(只 SD + I²S,沒 TFT)→ 乾淨;
    Voice_Test(TFT + SD + I²S)→ 雜訊大 + 螢幕閃。確認問題在
    TFT 跟 SD 搶 SPI2_HOST(雖然有 bus_shared = true,但 TFT 寫入
    時 SD 讀寫被擋,造成 I²S TX/RX underrun → 雜訊;TFT 寫入又
    被 SD 卡到 → 半成品畫面 → 閃)。
    修法:drawPlayDynamic / drawRecDynamic 加 cache,**只在秒數
    變化時才重畫**(每秒 1 次,不是每 250ms 4 次):
    - drawPlayDynamic:lastPlaySec 記錄上次秒數,playSecs 沒變就 return
    - drawRecDynamic:同 lastRecSec
    效果:
    - TFT 每秒只重畫一次倒數計時(其他 250ms 觸發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
2026-06-07 Drone_Test 加 I²C scan 指令:診斷 bus 共線問題
    使用者試燒 Drone_Test 後回報 BMP280/磁力計/VL53L0X 全部「未偵測到」,
    但「單獨都沒問題」→ I²C bus 共線後有元件把 bus 拉爆 或 沒接好。
    加 `scan` Serial 指令:掃描 0x01~0x7F,印有哪些 I²C 位址回應 + 標
    出對應元件(MPU/BMP/Mag/TCA),診斷 bus 狀態:
    - 找到 0 個 → SDA/SCL 沒接好 或 bus 整個短路
    - 找到 1 個 → 只 1 顆活(其他電源 / 接線問題)
    - 找到 多個 → init 程式碼問題(可能正在發生)
    使用者送 scan 後,從結果判斷下一步該拔哪個。
2026-06-07 加 BMP_Test / MAG_Test / TCA_Test:三個飛機端 I²C 元件單獨測試
    使用者 Drone_Test scan 結果只看到 MPU6050 0x68,
    其他 I²C 元件全部「未偵測到」。為了精準排查每顆,寫三個獨立
    測試,使用者一次只接一顆驗證:
    ## BMP_Test
    - 自動試 0x76 跟 0x77
    - I²C scan 看 BMP280 有沒有在線上
    - 每秒印氣壓 / 溫度 / 高度
    - 指令:scan、read
    ## MAG_Test
    - 自動偵測 HMC5883L(0x1E)或 QMC5883(0x0D)
    - 印 X/Y/Z raw + heading + 方位中文(北/東北/東...)
    - magcal 10 秒繞圈校準
    - 指令:scan、read、magcal
    ## TCA_Test
    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
2026-06-07 飛機磁力計加支援 QMC5883P(GY-271 新版,位址 0x2C)
    使用者 Drone_Test scan 找到 0x2C,我們之前 magDetect 只認 0x1E
    (HMC5883L)跟 0x0D(QMC5883),沒處理 QMC5883P(新版 GY-271
    2024 年後常見的版本)。
    加 0x2C 支援:
    ### 三種磁力計變體
    - HMC5883L(0x1E):Honeywell 原版,X→Z→Y、big-endian
    - QMC5883(0x0D):QST 舊複製版,X→Y→Z、little-endian、reg 0x00
    - QMC5883P(0x2C):QST 新版,X→Y→Z、little-endian、**reg 0x01**
    控制 reg 也不同(0x0A、0x0B、0x0D)
    ### 改動
    - 加 ADDR_QMC5883P 0x2C define
    - 引入 MagChip enum(MAG_NONE / MAG_HMC5883L / MAG_QMC5883 / MAG_QMC5883P)
    - magDetect() 依序試 0x1E、0x0D、0x2C,記錄到 magChip
    - magRead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
2026-06-07 Drone_Test 同步加 QMC5883P (0x2C) 磁力計支援
    跟 Drone_FC_Full commit 5b0fcbb 同步,Drone_Test 也加新版 GY-271
    晶片 QMC5883P 支援:
    - ADDR_QMC5883P 0x2C define
    - MagChip enum 取代 magIsQMC bool
    - magDetect 依序試 0x1E、0x0D、0x2C
    - magRead 用 switch(magChip) 處理三種 startReg + endian
    - I²C scan 標籤加 0x2C → QMC5883P
2026-06-07 Drone_Test 每秒自動印整合行 + 加 magcal 指令
    使用者要求「全部感測器一次列出來」,把每秒的自動印行從只有
    IMU/Bat/GPS 擴成「所有感測器整合一行」:
    R+5.5° P-3.4° | BMP 1003hPa +0.6m | Mag 309° |
    ToF C -1 L 554 R--- D--- | Bat 0.00V | GPS sat0
    每個欄位:
    - IMU:Roll / Pitch
    - BMP280:氣壓(hPa)+ 相對高度(m,起飛時 home 為 0)
    - 磁力計:heading(度,0=北 90=東 180=南 270=西)
    - 4 顆 VL53L0X:CH0 前中、CH1 前左、CH2 前右、CH3 底部(mm)
    沒接的印 -2,RangeStatus=4 (out of range) 印 -1
    - 電池電壓(沒接電池會顯示 0V,可忽略)
    - GPS 衛星數
    也加 magcal 指令:
    - 10 秒 50Hz 取樣繞圈,記錄 X/Y min/m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
2026-06-07 Drone_Test 訊息全面中文化:ToF → 雷射、Roll → 翻滾 等
    使用者要求「盡量用中文」,把 Drone_Test 的 Serial 訊息英文標籤
    全部改成中文:
    | 之前 | 之後 |
    |--|--|
    | ToF / VL53L0X | 雷射(VL53L0X 是型號保留) |
    | Roll | 翻滾 |
    | Pitch | 俯仰 |
    | Bat | 電池 |
    | BMP (label) | 氣壓 |
    | Mag (label) | 方位 |
    | GPS sat | GPS 衛星 |
    | FAIL | 沒接或壞了 |
    整合行:
    翻滾+5.5° 俯仰-3.4° | 氣壓1004hPa 高度+0.6m | 方位309.4° |
    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
    [Drone_Test.ino]
2026-06-07 NRF24 換新 PIPE+CHANNEL + 加 GPS course 餵 bodyYawEst(RTH 不靠磁力計)
    ## 1. NRF24 換新 PIPE + CHANNEL
    使用者反映既有的 0xABCDABCD71LL 是教學常見預設,別人也可能用,
    怕互相干擾。換新組:
    PIPE = 0x4E6F9C2D5B (40-bit 隨機,避開常見 0xABCD/E7/F0 系列)
    CHANNEL = 88 (避開常見 76 / 100)
    Drone_FC_Full.ino 跟 Ground_TX_ESP32.ino 同步,兩邊 PIPE 必須一致
    才能通訊。
    ## 2. GPS course over ground 加入 bodyYawEst
    使用者點出:RTH 不需要絕對磁北,只要知道飛機朝哪、家在哪
    方向,**算 yaw 差**就好。GPS NMEA 的 VTG sentence 飛行中
    直接給移動方位(course over ground),完全不用磁力計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
2026-06-07 飛機加飛行中 hover 自動校準 levelOffset(adaptive trim)
    使用者「以後直接給最好的方法」+ 提出:
    - MPU6050 沒裝得跟機架完全平行
    - 地板可能不平
    - 搖桿沒彈簧不能回中位(=不能用手動 trim)
    最好方法 = 飛行中自動學「真水平」(商業飛控標準作法,
    Betaflight / APM / PX4 都用這個)。
    ## 偵測穩定 hover
    readAttitude() 末加邏輯,5 個條件同時成立才算 hover:
    1. 已 armed
    2. 油門 130~200(典型 hover 範圍)
    3. yawRate < 5°/s(沒在轉)
    4. gyro roll/pitch 變化 < 5°/s(姿態穩)
    5. 加速度向量 ≈ 1G(15000~17500 ADU,沒在加速 / 減速)
    5 條件持續 > 3 秒 → 確認穩定 hover。
    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
2026-06-07 Drone_FC_Full:disarm 時把 hover auto-trim 學到的 levelOffset 存 NVS
    commit 9949df2 加了 hover 飛行中自動校準 levelOffset,但**只在
    這次飛行有效**。重開機後 levelOffset 回到 calfull 時的值,
    得重飛 30~100 秒讓自動校準重新到位。
    加 NVS 持久化:每次 disarm(降落或失聯)瞬間呼叫 saveCalibration(),
    把當前 levelOffset(含 hover 學到的修正)寫進 NVS。
    兩個觸發點:
    - disarm():正常降落觸發
    - failsafe():失聯觸發(已 armed 才存,避免每次重啟都寫 NVS)
    Serial 印 disarm 訊息時順便顯示存的 levelOffset 值,方便確認。
    完整自動校準流程(使用者完全不用做)：
    1. 第一次飛:calfull 一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
    [Drone_FC_Full.ino]
2026-06-08 Voice_Test:INMP441 跟 MAX98357A 改互斥啟用,徹底消除播放雜訊
    使用者實測:即使 MAX98357A SD 已改 GPIO 控制(commit 343e0ff),
    播放 WAV 還是有雜訊,但「只播放(Play_Test 那種無 INM 的程式)」
    是乾淨的。確認雜訊是 INMP441 通電時 SD 數位線
    持續輸出造成的 EMI 干擾 MAX 類比輸出。
    INMP441 沒有 shutdown 腳,只能斷電:把它 VDD 改成 ESP32 GPIO 17
    控制(release 17 後剛好可用)。ESP32 GPIO 能驅動 40mA,INMP441
    規格只吃 1.4mA,直接供電完全 OK。
    ## 接線變動(使用者要拉這一條)
    - INMP441 VDD 從 3V3 軌 → 移到 ESP32-S3 GPIO 17
    ## 軟體邏輯
    - setup:PIN_MIC_PWR(GPIO 17)OUTPUT,預設 HIGH(待機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
    [Voice_Test.ino]
2026-06-08 Voice_Test 改純軟體互斥(撤回 INMP441 VDD 接 GPIO 17 那條線)
    使用者點出關鍵盲點:Play_Test 也是 INMP441 通電 + 接 BCLK,
    但聲音乾淨。所以雜訊不是 EMI / 共軌 ripple,而是 **I²S RX DMA
    背景活動干擾 TX DMA timing**。
    差別:
    - Play_Test:只 i2s_new_channel(TX),沒 RX channel
    - Voice_Test:i2s_new_channel(TX + RX 雙工),RX DMA 一直在
    背景填 buffer(即使程式沒讀)→ 跟 TX DMA 搶記憶體 timing
    修法:用 i2s_channel_disable() 暫停閒置 channel 的 DMA(不刪
    channel,需要時 i2s_channel_enable() 立刻恢復):
    - startPlay():i2s_channel_disable(i2s_rx) 停 RX
    - stopPlay():i2s_channel_enable(i2s_rx) 恢復
    - startRec():i2s_channel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
    [Voice_Test.ino]
2026-06-08 Voice_Test + Play_Test:SD 失敗不卡死,進系統後才提示
    使用者反映「很多程式設定要先讀到 SD 才能進去,連系統都進不去」。
    SD 應該是「需要時才檢查」,不是 boot blocker。
    ## Voice_Test
    - 移除 setup() 末的 while(1) delay(1000)
    - SD 失敗只在 TFT 印紅字「SD 卡未接(可繼續用)」1.5 秒後繼續
    - 選單 / 按鈕 / 搖桿 / 開關都還能用
    - startPlay():檢查 sdOK,沒接時 TFT 紅字提示「先插 SD 卡再試播放」1.5 秒,回選單
    - startRec():同上,提示「先插 SD 卡再試錄音」
    - scanFiles() 本來就有 !sdOK guard,fileCount = 0,選單會顯示「(SD 沒檔)」
    ## Play_Test
    - 移除 while(1) delay(1000)
    - SD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
2026-06-08 修編譯錯:startRec 漏改的 drawMenu() → drawMenuStatic + drawMenuDynamic
    上次改成「不阻斷 SD」時 startPlay 有改對(replace_all=true),但
    startRec() 那段 drawMenu() 漏掉了,編譯報錯:
    'drawMenu' was not declared in this scope
    補上 drawMenuStatic() + drawMenuDynamic() 兩行(這個 sketch 沒
    drawMenu(),都是分 static / dynamic 兩個函式)。
    [Voice_Test.ino]
2026-06-08 加一鍵編譯+上傳腳本 burn.ps1 / burn.bat
    使用者反映 Arduino IDE 的 Tools 設定常常 reset(切 board / sketch
    都可能),每次都要手動重設 Partition Scheme / Flash Size / PSRAM
    等等,很煩。用 arduino-cli + sketch.yaml 一勞永逸。
    1. burn.ps1:PowerShell 腳本,take sketch 名 + (可選)COM port
    - 自動偵測 COM port(只有一個 ESP 連接時)
    - 多個板時列出讓使用者選
    - 沒找到 sketch 時列出所有可用的 sketch
    - 顯示編譯時間 + 成功/失敗訊息
    2. burn.bat:Bypass ExecutionPolicy 呼叫 burn.ps1
    3. Drone_FC_Full/sketch.yaml:LOLIN D32 profile
    - PartitionScheme=huge_app(3MB APP / 1MB SPIFFS,避免之後爆容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
2026-06-08 burn.bat 改成純 ASCII,避免 cmd 把中文 REM 註解誤認指令
    cmd code page 預設 Big5(zh-TW),burn.bat 內的中文註解(REM 行)
    被當 UTF-8 解析失敗,顯示成「'賜' 不是內部或外部命令」一堆。
    修法:
    - 刪掉所有中文 REM 註解
    - 加 chcp 65001 切到 UTF-8(handle 後續傳給 PowerShell 的 args)
    - 加 -NoProfile 避免使用者 PowerShell profile 干擾
2026-06-08 burn.ps1 改成純英文,避免 PowerShell 讀中文字串編碼錯誤
    PowerShell 5.x 讀 .ps1 預設用 ANSI(系統 code page),不會自動
    偵測 UTF-8,中文字串會被當 Big5 / 936 解析失敗,parse error。
    修法跟 burn.bat 一樣,把所有 Chinese 字串改 ASCII:
    - 訊息全英文
    - emoji 改 [+] / [!] / [OK] / [FAIL] / [ERROR]
    - 加 @() 包裝 Where-Object 結果,避免單一物件不能 .Count
    副作用:介面變英文。實際使用差別不大,反正使用者只看「OK 還是 FAIL」。
2026-06-08 burn.ps1 修 JSON 解析:arduino-cli 1.x 結果包在 detected_ports 裡
    使用者試燒回報「No COM board detected」但 arduino-cli board list
    明顯看到 COM3。問題在 JSON 結構,我寫的解析路徑錯了。
    arduino-cli 1.x board list --format json 回傳:
    {
    "detected_ports": [
    { "port": { "address": "COM3", ... }, "matching_boards": [...] }
    ]
    }
    之前的解析直接遍歷 $boardList,但實際應該遍歷
    $boardList.detected_ports。
    加 fallback 防止 arduino-cli 改回舊格式:
    if ($boardList.detected_ports) { use it } else { use root }
    板子未知(matching_boards 空)時就用 port.address,不要當錯誤。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
2026-06-08 sketch.yaml profile 從 esp32:esp32 3.3.8 升 3.3.9
    使用者反映:第一次跑 burn.ps1 時 arduino-cli 在下載 ESP32 core
    (因為 sketch.yaml 釘版本 3.3.8,使用者裝的是 3.3.9)。
    把所有 sketch.yaml 改成 3.3.9 對齊使用者環境,以後不會再觸發
    core 重裝。如果以後升 4.x 也只要一次性 sed 替換。
    11 個檔同時改:Button/Drone_FC_Full/Drone_Test/Ground_TX/
    Ground_TX_Test_TFT/INM/Play/SD/SPK/Voice/tyty。
2026-06-08 sketch.yaml 移除 FlashFreq option:ESP32 core 3.3.9 已廢
    使用者試燒回報:
    無效的 FQBN: 取得開發板 esp32:esp32:esp32s3: 無效的選項 'FlashFreq'
    ESP32 Arduino core 3.3.x 把部分 FQBN 選項簡化掉,FlashFreq 不再
    是有效屬性(由 FlashMode + 板子預設值決定)。
    11 個 sketch.yaml 全部移除 FlashFreq=80,改用板子預設(80MHz QIO 一樣)。
2026-06-08 sketch.yaml 移除 platforms: 區塊,不再觸發 profile 私有 cache 重裝
    使用者反映 burn.ps1 每次跑都會重新下載 ESP32 core(花 5~10 分鐘)。
    查清楚:sketch.yaml profile 有 platforms: 區塊時,arduino-cli 會
    **用 profile 私有 cache 重裝**該版本 core,而不是用全域已裝的。
    修法:移除所有 sketch.yaml 的 platforms: 區塊,只留 fqbn。
    arduino-cli 會用全域裝的 esp32:esp32 core(使用者已有 3.3.9)。
    未來升 4.x 也只要使用者全域 arduino-cli core upgrade 一次就好,
    不用修 sketch.yaml(因為沒釘版本)。
    副作用:profile 不再「自我描述」依賴版本,跨機器使用者環境
    可能不一致。但這是個人專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
2026-06-08 burn.ps1 改用 -b FQBN 模式,避開 profile 隔離(找不到全域函式庫)
    問題:arduino-cli 看到 sketch.yaml 有 default_profile 就會自動進
    profile 隔離模式,用 ~\AppData\Local\Arduino15\internal\... 私有
    cache,**完全不認使用者全域裝的 Arduino IDE 函式庫**(LovyanGFX、
    Adafruit_BMP280、TinyGPS+ 等等),導致:
    fatal error: LovyanGFX.hpp: No such file or directory
    修法兩步:
    1. 移除所有 sketch.yaml 的 default_profile 行(不再自動觸發 profile)
    2. burn.ps1 用 regex 自己讀 sketch.yaml 的 fqbn 行,改用 `-b $fqbn`
    呼叫 arduino-cli compile(不傳 --profile)
    - arduino-cli 用全域 ESP32 core(esp32:esp32@3.3.9,使用者已裝)
    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
2026-06-08 撤回 i2s_channel_disable(rx) 那段,使用者試燒後完全沒聲音
    之前理論:雙工模式下 RX DMA 背景跑會干擾 TX → 加 disable RX。
    但實證後完全沒聲音,推測 i2s_channel_disable 在 ESP-IDF Standard
    模式下會連帶停掉共用的 BCLK → MAX98357A 收不到時脈 → 無輸出。
    撤回 4 處 disable/enable 呼叫:
    - startPlay() i2s_channel_disable(i2s_rx)
    - stopPlay() i2s_channel_enable(i2s_rx)
    - startRec() i2s_channel_disable(i2s_tx)
    - stopRec() i2s_channel_enable(i2s_tx)
    保留:
    - MAX98357A SD 腳 GPIO 18 控制(這部分使用者實體有接線)
    - TFT cache(drawPlayDynamic / drawRecDynamic 只在秒數變化時重畫)
    下一步如果還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
2026-06-08 Voice_Test:RX channel 平常不啟用,只在錄音時啟用
    之前 i2s_channel_disable(rx) 在播放時觸發會把 BCLK 一起停掉 →
    MAX 無聲。撤回後雜訊回來。
    換策略:**RX 平常根本不啟用**,跟 Play_Test 一樣只有 TX 在跑 →
    播放完全乾淨。RX 只在 startRec 時臨時啟用,stopRec 時關掉。
    setup() initI2S:
    - i2s_new_channel + init_std_mode 兩個 channel 都做(handle 都拿好)
    - 只 i2s_channel_enable(i2s_tx),不 enable RX
    startRec:
    - i2s_channel_enable(i2s_rx) + delay 30ms 等穩定
    - 然後正常讀 INMP441
    stopRec:
    - i2s_channel_disable(i2s_rx) 關 RX(這時 TX 沒在 write 所以 BCLK
    停掉沒差;下次播放又會 enable_tx 重啟 BCLK)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
2026-06-08 加 Voice_Test2:用 ESP_I2S.h C++ 包裝改寫,徹底解雜訊
    使用者轉述另一個 AI 的建議,採用 Arduino-ESP32 3.x 官方推薦的
    I2SClass (ESP_I2S.h) 改寫 Voice_Test。保留 Voice_Test 不動方便對比。
    ## 核心改動
    跟 Voice_Test 對比:
    - #include <driver/i2s_std.h> → #include <ESP_I2S.h>
    - i2s_chan_handle_t → I2SClass i2s
    - i2s_new_channel + init_std_mode + channel_enable → i2s.setPins + i2s.begin
    - i2s_channel_read/write → i2s.readBytes / i2s.write
    ## 防雜訊雙工切換邏輯(關鍵)
    待機 ST_MENU:
    - i2s.end() → I²S 完全關閉,BCLK + WS 全停
    - INMP441 沒時脈 → 完全不輸出
    - MAX98357A SD 拉低 → 休眠
    - 結果:**完全靜音**
    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
2026-06-08 Voice_Test2:選單加右搖桿控制游標,連續推會加速捲動
    使用者反映 +/- 按鈕在選單反應怪、不好移動。改用右搖桿 Y 軸
    (GPIO 4 / J_PITCH)為主要控制,按鈕保留為備用。
    ## 行為
    - 推上(ADC < 1000):游標上
    - 推下(ADC > 3000):游標下
    - 中位:不動
    - 連續推會加速:
    - 前 500ms:350ms / 步(輕推一次只移一格)
    - 500ms~1500ms:200ms / 步
    - 超過 1500ms:80ms / 步(瀏覽長 list 用)
    ## 為什麼按鈕反應怪
    階梯按鈕在 GPIO 7 ADC,讀值在 PLUS/MINUS/OK/BACK 之間,雜訊
    可能讓按一次跳到別的判定。搖桿是大幅度推位,門檻在極端
    (< 1000 或 > 3000),不受雜訊影響。
    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
2026-06-08 Voice_Test2:清死碼 + 修按鈕 + 大幅優化選單 partial redraw
    使用者反映「四顆按鈕沒辦法好好發揮作用、系統卡卡的」。診斷:
    1. drawMenuDynamic 每次游標移動都全清 240×248 + 重畫 10 列
    → 每次 ~50ms TFT,搖桿連推時 60%+ CPU 在畫畫 → 卡卡
    2. readMenuBtn 沒去抖,ADC 雜訊讓鄰近按鈕互跳
    3. btnEdge 偵測「值變化」會把 PLUS→MINUS 算成 edge,誤觸發
    ## 修法
    ### A. 按鈕 3 票去抖動
    readMenuBtn 加 history[3],3 次連續同值才回報穩定值,~60ms 穩定。
    ADC 雜訊抖動會被擋下來變 BTN_NONE,等穩定才回真值。
    ### B. 按鈕邊緣偵測改「鬆開→按下」才 fire
    原本 (btn != lastB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
2026-06-08 Voice_Test2:搖桿選單上下對調(推上=游標上,推下=游標下)
    使用者試燒後反映方向相反。之前 joyUp=(joyY<1000)、joyDown=(joyY>3000),
    現對調:joyUp=(joyY>3000)、joyDown=(joyY<1000)。
2026-06-08 Voice_Test2:按鈕去抖改時間穩定法,+/- 加自動連發
    使用者反映:
    - 按 OK 常常變成播放 REC_001(代表 OK 沒按 OK 卻被誤觸發,
    或游標沒移動還停在 index 0)
    - 上下鍵也容易觸發播放(按 +/- 時偶爾觸發 OK)
    根本原因:之前 3-vote 去抖會被「按 + 的過程中 ADC 短暫停在
    OK 範圍剛好 3 次」騙過去 → 真的回報 BTN_OK → 觸發 startPlay。
    ### readMenuBtn 改成「時間穩定」+「樣本平均」
    - 每次讀 4 個樣本取平均 → 減少 ADC 雜訊
    - 同一個 raw 值要連續穩定 50ms 才成為 stableReading
    - 中間 transient 不會被當真,因為計時被重置
    ```
    candidate=BTN_NONE
    按 + 開始: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
2026-06-08 Voice_Test2:撤回 32-bit 嘗試,改加 btn debug 印列
    使用者點出聲音之前是好的,問題只是 OK 沒觸發。撤回 i2sStartTX 改
    32-bit 那段(沒必要動)。改加 Serial debug 在 btnEdge 觸發時印
    btn 值跟即時 ADC,看 OK 按下去實際是哪個 button + 讀到多少。
    懷疑:按鈕 ADC 值已飄移(之前測 OK=1925,可能現在落到 1500
    以下變 BACK 範圍),所以按 OK 真的觸發了 BACK(重新掃描)
    而不是 startPlay。
    debug 印出來後可以對應調整 threshold。
2026-06-08 Voice_Test2:OK / BACK button threshold 拉低,徹底解誤觸發
    使用者觀察「OK 觸發不了 + 還常自動跳回 001」= OK 被誤讀成
    BACK 的鐵證:按 OK → ADC 飄一點 → 程式判 BACK → BACK 邏輯
    觸發 scanFiles + cursor=0 → 畫面跳回 REC_001。
    原本 thresholds(剛好對齊使用者測過的 button ADC 中點):
    PLUS > 3300, MINUS > 2300, OK > 1550, BACK > 600
    margin 各約 ±300,實測會被環境噪聲 / 溫度 / 接觸電阻變化吃掉。
    拉低成:
    PLUS > 3000, MINUS > 2100, OK > 1200, BACK > 400
    每個 button 上下緣的 margin 變大:
    OK 範圍 1200~2100(寬 900,原本 1550~2300 只 750)
    BACK 範圍 400~1200(原本 600~1550 同樣 950 但低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
2026-06-08 加 mon.ps1:一鍵打開 Serial Monitor(配合 burn.ps1 使用)
    Usage:
    .\mon.ps1 # auto-detect COM, 115200 baud
    .\mon.ps1 COM7 # specify port
    .\mon.ps1 COM7 9600 # specify port + baudrate
    跟 burn.ps1 同樣的 COM 偵測邏輯,純英文避免編碼問題。
    Ctrl+C 結束。
2026-06-08 Voice_Test2:I²S TX 改 32-bit mode + 16→32 擴展(對齊 Voice_Test 原版)
    使用者試燒後反映播放完全沒聲音(OK 按鈕現在會正確觸發 startPlay,
    但喇叭沒響)。換用 Voice_Test 原版工作正常的 32-bit 配置:
    - begin() 用 I2S_DATA_BIT_WIDTH_32BIT(不是 16)
    - doPlayChunk 把 16-bit PCM 左移 16 變 32-bit MSB-aligned
    - i2s.write 寫 32-bit 緩衝(samples * 4 bytes)
    ESP_I2S.h 在 16-bit MONO STD 模式下,寫 16-bit PCM 跟 MAX98357A
    的 32-bit slot 期待對不上,可能 frame 沒對齊或音訊資料被吃掉。
    32-bit 配置跟 MAX98357A datasheet 推薦最匹配,Voice_Test 原版
    證實可用。
    加 debug 印:
    - i2sStartTX 印「I²S TX 啟動 32-bit M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
2026-06-08 burn.ps1 + mon.ps1:腳本內自動刷新 PATH,免使用者每次手動刷
    問題:winget 裝完 arduino-cli 後,**已開的 PowerShell session 不會
    自動更新 PATH**,使用者必須手動下:
    \$env:Path = [System.Environment]::GetEnvironmentVariable("Path","Machine") + ";" + ...
    關 VS Code / 重開 PowerShell 又會再遇到同樣問題,煩。
    修法:burn.ps1 跟 mon.ps1 開頭直接從註冊表讀 Machine + User PATH
    組合進 \$env:Path。腳本跑起來就會看到 winget 加進去的 path,
    arduino-cli 一定找得到。
2026-06-08 Voice_Test2:改回 duplex 一次性 init,放棄模式切換 end()/begin()
    使用者試燒回報雙重問題:
    1. 新錄的音檔都過小不能播(只 44 bytes 沒音訊資料)
    2. 第一次 OK 有聲音,錄完音後再播都沒聲音了
    根因:i2s.end() + i2s.begin() 在 ESP_I2S.h 切換 TX/RX 模式時
    不可靠。RX-only init 之後 readBytes() 沒讀到資料(可能 RX
    DMA 沒真正啟動),寫入錄音檔全部 0 bytes。然後切回 TX-only
    時 I²S 狀態爛了,播放也沒聲音。
    把 i2sStartTX / i2sStartRX / i2sStop 那套刪掉,改成:
    - setup() 一次 i2sInitOnce(),duplex 模式(BCLK/WS/DOUT/DIN
    4 隻腳全 set),32-bit MONO STD,**永遠不 end()**
    - startPlay / stop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
2026-06-08 修編譯錯:I2SClass::read() 沒有 (buf, size) overload,改回 readBytes
    剛改的 i2s.read((uint8_t*)raw, sizeof(raw)) 編譯不過:
    no matching function for call to 'I2SClass::read(uint8_t*, unsigned int)'
    candidate: 'virtual int I2SClass::read()'
    candidate expects 0 arguments, 2 provided
    ESP_I2S.h 的 I2SClass.read() 只有 0 引數版(返回一個 int 樣本),
    要多 byte 讀取必須用 Stream 繼承下來的 readBytes(char*, size_t)。
    duplex 一次性 init 後 RX DMA 持續跑,readBytes 不會 timeout
    被卡(之前怕 1 秒 block 的擔心,在「RX 真的在跑」前提下不存在)。
2026-06-08 Voice_Test2:i2sInitOnce 移到 drawMenu 之後,TFT 先確保顯示
    使用者反映 TFT 畫面顯示不出來。懷疑 i2sInitOnce 在 ESP_I2S.h
    duplex 模式下 begin() 有問題(可能 hang 或卡某種內部狀態),
    導致後續 drawMenuStatic + drawMenuDynamic 沒跑到。
    修法:把 i2sInitOnce() 從「TFT init 之後、drawMenu 之前」
    搬到「drawMenu 之後」。即使 i2s.begin 萬一卡住,使用者
    至少看得到選單畫面。
    如果還是看不到 TFT,問題在更上層(SPI / TFT 本身),
    不在 I²S。
2026-06-08 revert Voice_Test2 回 8964aa7(mode switching、TX 16-bit、RX 32-bit)
    使用者點出他記得「某個版本能正常放聲音」。Git log 看下來最可能
    是 8964aa7 那版(button threshold 修好之後,duplex 那串改之前)。
    那版配置:
    - I²S 用 mode switching:i2sStartTX / i2sStartRX / i2sStop
    - TX:setPins 設 DIN=-1(INMP441 不綁進 I²S),16-bit MONO STD
    - RX:setPins 設 DOUT=-1(MAX 不綁進 I²S),32-bit MONO LEFT
    - 待機:i2sStop 完全 end I²S,BCLK 停
    後來改 duplex(6d770a2)是想解決「錄完音後播放沒聲」,但反而
    讓 TFT 顯示也壞掉。轉了一圈不如先回到 8964aa7。
    已知問題(這版有):
    - BOD reset:MAX 播放電流尖峰讓 5V 軌 sag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
    [Voice_Test2.ino]
2026-06-08 Play_Test 補上 MAX98357A SD 腳控制(GPIO 18 拉高)
    使用者試燒 Play_Test 沒聲音。Play_Test 沒控制 MAX98357A SD 腳
    (GPIO 18),而我們之前已經把 MAX SD 從浮空改成 GPIO 18 軟體控制
    (commit 343e0ff)。Play_Test 沒同步更新:
    - 沒設 pinMode(18, OUTPUT)
    - 沒 digitalWrite(18, HIGH)
    結果:GPIO 18 default 是 input 浮空 → MAX98357A SD 腳浮空 → 視為
    shutdown(規格:< 0.16V 或 0.16~0.77V 都進 shutdown)→ 喇叭靜音。
    修法:setup 開頭 pinMode(18, OUTPUT) + digitalWrite(18, HIGH),
    Play_Test 整個跑都要 MAX 啟用。
    副作用:沒。Play_Test 沒錄音功能,MAX 一直啟用也沒影響其他元件。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
2026-06-08 Play_Test 消 boot 雜訊:MAX SD 預設低,I²S 穩定後才拉高
    使用者試燒 Play_Test 聲音正常,但啟動時有 pop 雜訊。原因:
    原本 MAX SD 在 setup 一開始就拉高,此時 I²S 還沒 init,
    DOUT 腳浮空 / 隨機,MAX 通電就吃到隨機訊號 → 喇叭聽到 pop。
    1. setup 開頭 MAX SD = LOW(休眠保護)
    2. I²S init 完
    3. 預灌 4 批靜音 sample 進 DMA buffer(BUF_SAMPLES * 4 sample = ~64ms 靜音)
    4. delay 20ms 等 buffer 穩定
    5. 才把 MAX SD = HIGH 啟用
    這時 MAX 醒來看到的是穩定的 0 訊號,不會 pop。
    證實硬體完全 OK:Play_Test 能播 → MAX98357A 跟喇叭都沒事,
    之前 Voice_Test「炸音」是程式 bug 觸發的瞬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
    [Play_Test.ino]
2026-06-08 Play_Test:DMA buffer 加大 4 倍,消除咖咖咖 underrun click
    使用者試燒 Play_Test 重放錄音時聽到「咖咖咖」叫好幾聲。Play_Test
    沒 TFT 沒按鈕,只有 SD → I²S,還會 click → SD 卡偶爾讀比 16ms
    慢一拍,I²S TX DMA 緩衝空了就吃到垃圾,喇叭聽到 click。
    修法:加大 DMA + 加大 SD 讀塊,吸收 SD 慢讀延遲。
    DMA 緩衝:
    - 之前:8 desc × 512 frame × 4 byte = 16 KB = ~128 ms
    - 現在:16 desc × 1024 frame × 4 byte = 64 KB = ~500 ms
    SD 讀塊:
    - 之前:BUF_SAMPLES = 512(每次讀 1024 bytes = 16ms audio)
    - 現在:BUF_SAMPLES = 1024(每次讀 2048 bytes = 32ms audio)
    讀塊翻倍 + 緩衝放大 4 倍 → SD 偶發 ~100ms 慢讀也能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
2026-06-08 revert Play_Test DMA buffer 加大,先回原設定
    DMA 緩衝加大到 500ms 反而導致檔尾資料在 DMA buffer 內留太久,
    seek 重播時 DMA 繼續放舊資料 → 使用者聽到「最後一個音會重複」。
    回到原始 128ms buffer 設定:
    dma_desc_num = 8
    dma_frame_num = 512
    BUF_SAMPLES = 512
    回到原本「咖咖咖」狀態,但至少沒有「重複」問題。咖咖咖本身要靠
    **檔案無破洞**才能徹底解決,不是 DMA 大小能控制的。
    下一步:讓使用者拿 SD 卡到電腦播 REC_001.WAV,確認檔案本身有
    沒有 click。如果電腦放也有 → 重錄;如果電腦乾淨 → 程式問題。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
    [Play_Test.ino]
2026-06-08 SPK_Test 套上 MAX98357A boot pop 修法
    設定 MAX SD 在 I²S init 之前先拉低、init 完 delay 20ms 後才拉高,
    避免 boot 瞬間喇叭聽到 pop。跟 Play_Test 同步。
2026-06-08 SPK_Test 加大 DMA buffer 解 underrun click
    使用者試燒 SPK_Test 純正弦波都有「咖咖咖蹦蹦」雜音,代表 I²S
    TX underrun(不是 SD / 不是 WAV 內容),是 DMA buffer 不夠大。
    預設 6 × 240 frame = 90ms 太小,稍微有點 CPU 抖動就 underrun。
    加大到 8 × 480 frame = 240ms,給 sine 產生 + i2s_channel_write
    留更多餘裕。
2026-06-08 SPK_Test 改 32kHz × 32-bit,跟 Play_Test 一致
    之前 SPK_Test 用 16kHz × 16-bit × 2 slot,BCLK 算下來只 512 kHz,
    低於 MAX98357A datasheet 規格最低 800 kHz。雖然使用者後來發現
    雜音真正主因是 USB 接地迴路(拔 USB 就乾淨),但 BCLK 過低
    本身也是隱患,趁機統一到 Play_Test 的配置。
    改動:
    - SAMPLE_RATE: 16000 → 32000
    - slot 寬度:16BIT → 32BIT
    - loop 內 sine 算完 int16,左移 16 變 32-bit MSB-aligned 送 I²S
    - buf 型別:int16_t → int32_t
    新 BCLK = 32000 × 32 × 2 = 2.048 MHz ✓ 規格內
    副作用:無實際影響(USB 雜音問題是另一回事)。
2026-06-08 Voice_Test2 錄音 debug:加印 readBytes 結果 + 拉長 RX wakeup + 縮短 timeout
    使用者最後一個沒解掉的問題:Voice_Test2 mode switching 錄音
    出來的檔案不能播(只有 44 byte header)。
    3 個小改動診斷 + 改善:
    1. **拉長 i2sStartRX 後的 delay**:30ms → 200ms
    給 ESP_I2S.h 內部 RX DMA buffer 充分時間填滿(預設 1 秒 timeout
    太久 + 之前 delay 太短),200ms 應該足夠 INMP441 wakeup + DMA 預填。
    2. **i2s.setTimeout(50)**:把 readBytes 預設 1000ms timeout 砍到 50ms
    loop 不會被卡死,即使 RX 真的沒資料也快速 return 0。
    3. **印前 5 次 readBytes 結果**:`[rec] readBytes X / Y` 看 RX 真的
    有沒有給 byte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
2026-06-08 修編譯錯:g_recDbgCount 宣告位置移到 globals 區,startRec 才看得到
2026-06-08 Voice_Test 改回 RX/TX 一直都開:錄音 + 播放都能用
    使用者實證 Voice_Test「能錄不能放」+ Voice_Test2「能放不能錄」。
    Voice_Test 不能放是因為 stopRec 的 i2s_channel_disable(rx) 把共用的
    BCLK 一起停了,之後 i2s_channel_write(tx) 沒時脈出去 → MAX 無聲。
    修法:setup 同時啟用 TX 跟 RX,startRec / stopRec 不再 enable/disable。
    duplex 一直跑,BCLK 永遠在 → 錄 + 放都能用。
    USB 雜訊用「拔 USB 跑電池」解(已驗證),不要用 RX enable/disable
    這條路(會壞掉 BCLK)。
2026-06-08 Voice_Test 按鈕邏輯移植 Voice_Test2 修法(去抖 + threshold + edge)
    使用者試燒 Voice_Test 後反映按鈕「變回以前互相觸發」的樣子,
    因為 Voice_Test 沒套用 Voice_Test2 那邊的去抖改進。同步過來:
    readMenuBtn:
    - 4 樣本平均消 ADC 雜訊
    - 50ms 時間穩定才回報(transient 不會被當真)
    - threshold 拉低:PLUS > 3000、MINUS > 2100、OK > 1200、BACK > 400
    (原本 OK > 1550 太接近 BACK,飄一點就誤判)
    btnEdge 條件:
    - 改成 (lastBtn == BTN_NONE && btn != BTN_NONE)
    - 只在「鬆開→按下」瞬間 fire,鄰近 button 互跳不會誤觸發
    沒移植自動連發,Voice_Test 沒搖桿,用按鈕一直按沒辦法,等未來
    有人實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
2026-06-10 飛機接線總表加 ESP32-CAM 段落(電源從 ESC BEC,影像用手機看)
    - ESP32-CAM 不接主 5V 軌,從 ESC BEC 獨立拿電(避免拖累主系統)
    - 影像暫時用**手機瀏覽器**看(0 程式)
    - 未來可選擇加手把 TFT 顯示(要寫 100~150 行)
    - WiFi 跟 NRF24 都在 2.4 GHz 有互擾,短飛沒感
    接線就 2 條:5V 從 ESC BEC、GND 共軌。
    程式不用動(用既有的 ESP32CAM_Flight)。
    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
2026-06-10 ESP32CAM_Flight 加 FORCE_AP_MODE 旗標,預設直接用 AP(免 secrets.h)
    使用者反映「連不到 CAM」,源頭是 secrets.h 設的 SSID/密碼跟現在
    熱點對不上,所以 STA 連 20 秒失敗後才掉回 AP,中間延遲大 +
    新電腦 / 不同地點要重設 secrets.h 才能用。
    加 #define FORCE_AP_MODE 1(預設打開):
    - 直接跳過 STA 試連
    - 開機 2 秒進入 AP 模式 "DroneCAM" / "drone1234"
    - IP 192.168.4.1
    - 任何手機 / 任何地點都能用,**不用管 secrets.h 內容**
    未來要連自己固定熱點(STA 模式),把 FORCE_AP_MODE 改 0 就行,
    原本邏輯保留在 #else 區塊。
    使用流程(用 AP 模式):
    1. CAM 通電(從 ESC BEC 或 USB)
    2. 等 5 秒
    3.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
2026-06-10 Drone_FC_Full 加 NRF24 init debug 印,確認模組死活
    使用者試燒後 Serial 印到「[3] ESC 初始化」就停了,沒看到
    「[4] NRF24 listening」→ NRF24 init 過程中卡住或失敗。
    加兩行 debug:
    - [3.5] NRF24 radio.begin() ... OK/FAIL
    - [3.5] NRF24 chip connected: YES/NO
    如果 chip connected = NO → NRF24 模組沒回應 SPI,可能:
    1. 100µF 電容沒焊 / 冷焊
    2. CE/CSN/SCK/MISO/MOSI 接線錯
    3. 模組壞了
    4. 3V3 軌不夠
    從 Serial 印的 OK/FAIL 1 秒能判斷模組好壞,不用拆裝就知道方向。
    [Drone_FC_Full.ino]
2026-06-10 Ground_TX_ESP32 加 NRF24 init + TX 統計 debug
    跟飛機端對稱,加 NRF24 init debug:
    - [*] NRF24 radio.begin() ... OK/FAIL
    - [*] NRF24 chip connected: YES/NO
    main loop 加 TX 統計,每秒印一次:
    - [NRF] TX ok=X fail=Y (1 秒內) | mode=NN throttle=NNN
    從 Serial 看:
    - 手把 NRF24 init OK 嗎?
    - 手把每秒成功送出 ok=幾次、失敗 fail=幾次
    - mode 跟 throttle 是不是正確讀到搖桿值
    對通正常時:50Hz × 1秒 = 50 次 TX,大部分 ok,少數 fail。
    完全 fail = 50 → 飛機沒在 listen 或天線/距離問題。
    [Ground_TX_ESP32.ino]
2026-06-10 Ground_TX_ESP32 加 setup 開頭 2 秒 delay,讓 USB CDC 列舉完才 print
    使用者試燒後 mon.ps1 看 Serial 只看到 boot ROM,後面手把
    程式自己印的東西完全沒出來。原因:ESP32-S3 用 native USB
    CDC 做 Serial,Serial.begin 後 host 需要時間列舉 USB CDC
    裝置,如果立刻 Serial.print,送出去的字元沒有人收到 → 印
    丟掉。
    修法:Serial.begin 後 delay(2000) 等 USB 列舉,然後印 banner
    「=== 地面站 V2-A 啟動 ===」確認 Serial 通了。
    對使用體驗影響:開機慢 2 秒,可接受。
2026-06-10 Ground_TX_ESP32 改 while(!Serial) 等 USB CDC 真的連上才印 banner
    之前用 delay(2000) 假設 host 端已經準備好,但 ESP32-S3 USB CDC
    列舉時間因環境不同 1~5 秒都有可能,固定 delay 太死板。
    while (!Serial && millis() - t0 < 3000) delay(10);
    delay(200);
    意思:
    - 等 Serial(USB CDC)真的偵測到 host 連接,最多 3 秒
    - host 接著就立刻過(不浪費時間)
    - host 沒接也照樣 3 秒後超時繼續(避免無 USB 跑不下去)
    - 額外 200ms 緩衝給 host 端 buffer 準備
    加 Serial.flush() 強制把 banner 送出,別躲在 TX queue。
    如果還是看不到 banner,問題可能在 Serial.begin 或之前的 global
    init,需要進一步排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
2026-06-10 Ground_TX_ESP32 把 NRF24 init 狀態顯示到 TFT(不靠 Serial)
    USB CDC 在使用者 ESP32-S3 上有問題,Serial 看不到。把 debug 訊息
    搬到 TFT 上,使用者直接從螢幕看 NRF24 init 是否成功。
    開機 3 秒顯示:
    地面站 V2-A 啟動
    NRF24 begin: OK / FAIL (綠 / 紅)
    chip connected: YES / NO (綠 / 紅)
    PIPE = 0x...
    CHAN = 88
    SD: 已掛載 / 未接
    3 秒後進飛行 UI...
    之後 delay(3000) 才 drawFlightStatic 進飛行畫面。
    驗證 NRF24 對通直接看飛機端 Serial(USB-UART chip 沒 CDC 問題):
    - 飛機 Serial 印「Thr=128」就是手把有送
    - 看不到代表 NRF24 沒對通
    [Ground_TX_ESP32.ino]
2026-06-10 NRF24 PA Level 從 MAX 降到 HIGH:避免 TX 電流尖峰 brown-out
    使用者:SD 模組電源拔掉後 NRF24 init OK 了,但手把進飛行 UI 後
    一直重啟 → NRF24 TX 在 PA_MAX 時電流尖峰 ~115mA,讓 3V3 軌 sag,
    觸發 brown-out。
    降到 PA_HIGH:
    - 輸出功率少 6dB(2 dBm 降到 -4 dBm)
    - TX 電流從 ~115mA 降到 ~50mA
    - 對短距離(< 50m)沒差
    - 穩定性高很多
    兩邊同步:
    - Ground_TX_ESP32: PA_MAX → PA_HIGH
    - Drone_FC_Full: PA_MAX → PA_HIGH
    兩端必須一致,如果只改一邊,另一邊 ACK 可能對不上。
    未來要長距離飛(> 100m)再考慮:
    - 加電容(NRF24 VCC ↔ GND 加 470µF 或 1000µF)
    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
    [Drone_FC_Full.ino, Ground_TX_ESP32.ino]
2026-06-10 ENABLE_SD = 0 預設停用 SD,飛行測試不受 SD 模組干擾
    使用者:SD 模組干擾太多,先停用。
    Ground_TX_ESP32:
    - 加 #define ENABLE_SD 0(預設停用)
    - SD init 用 #if ENABLE_SD 包起來
    - 停用時:跳過 SD.begin、GPIO 47 不操作、sdOK = false
    - 印「SD 停用(ENABLE_SD = 0)」確認
    手把接線總表_V2.md:
    - SD 段落加警告:SD 模組搶 SPI bus 拖爆 NRF24,暫時拔 VCC
    - 長期解法:換不含 level shifter 的 3V3 直連 SD 模組
    未來要用 SD(錄音 / 音樂播放)再改 ENABLE_SD = 1,
    但要先確認 SPI 干擾問題解掉。
2026-06-10 NRF24 PA Level 降到 MIN:ESP32 內部 LDO 撐不住 PA_HIGH 尖峰
    使用者量到 3V3 輸出降到 3.2V → 接近 LDO 極限 + PA_HIGH 50mA
    尖峰讓 3V3 sag 到 brown-out 線下 → 重啟 loop。
    PA_MIN ~ 7mA 尖峰,LDO 完全撐得住。距離 ~10m 對桌面測試夠。
    兩端同步 MIN(必須一致):
    - Ground_TX_ESP32 PA_HIGH → PA_MIN
    - Drone_FC_Full PA_HIGH → PA_MIN
    實機飛行(需要 > 50m)要做的:
    - NRF24 VCC 並聯 470µF 或 1000µF 大電容
    - 或加獨立 AMS1117-3V3 LDO 給 NRF24 專用
    - 然後改回 PA_HIGH 或 PA_MAX
    [Drone_FC_Full.ino, Ground_TX_ESP32.ino]
2026-06-10 6_Channel_Transmitter(舊 Nano 手把)大改:對應新 Drone_FC_Full
    使用者要用舊手把(Arduino Nano + NRF24,沒螢幕)測對通,作為
    新 ESP32-S3 手把以外的備案。
    跟新 Drone_FC_Full(commit 2a12a85)對齊全部 NRF24 參數:
    | 設定 | 舊 | 新 |
    | PIPE | 0xABCDABCD71 | **0x4E6F9C2D5B** |
    | CHANNEL | 100 | **88** |
    | AutoAck | false | **true** |
    | AckPayload | 不啟用 | **enable** |
    | PA Level | MAX | **MIN**(配對) |
    Signal struct 從 6 bytes 擴成 11 bytes:
    byte throttle/pitch/roll/yaw (4)
    + byte mode/flags/paramID (3)
    + float paramVal (4)
    = 11 bytes
    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
2026-06-10 Drone_FC_Full PID + MAX_ANGLE 降到保守初始值(輕推搖桿馬達不狂轉)
    使用者反映新手把連到飛機後,輕推搖桿就馬達狂轉。原因:
    - MAX_ANGLE = 30°:搖桿推到底 → 目標傾角 30°,差距大 → PID 重拳修正
    - Kp_rp = 2.0:對誤差反應太強
    降到保守值,實際飛起來再用 Serial 指令加大:
    | 參數 | 舊 | 新 | 用途 |
    |--|--|--|--|
    | MAX_ANGLE | 30° | 15° | 最大目標傾角(自穩) |
    | MAX_YAWRATE | 90°/s | 45°/s | 最大 yaw 角速度 |
    | Kp_rp | 2.0 | 1.0 | Roll/Pitch P 增益 |
    | Ki_rp | 0.02 | 0.01 | Roll/Pitch I 增益 |
    | Kd_rp | 0.5 | 0.3 | Roll/Pitch D 增益 |
    | Kp_y | 1.5 | 0.8 | Yaw P 增益 |
    | Ki_y | 0.02 | 0.01 | Yaw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
    [Drone_FC_Full.ino]
2026-06-10 Telemetry 換掉 battery_mV,改放 altitude_dm + heading(顯示到 TFT)
    使用者:電池不裝,要顯示 GPS 高度方位。
    Telemetry struct 變動(兩邊同步):
    舊(18 bytes):
    int16_t roll, pitch, yawRate
    uint16_t battery_mV ← 移除
    uint8_t status, satCount
    int32_t lat_e7, lon_e7
    新(20 bytes,還在 32 byte NRF24 ACK 限制內):
    int16_t roll, pitch, yawRate
    int16_t altitude_dm ← 新增,decimeter,±3276.7m
    int16_t heading ← 新增,×10°,0=北 900=東
    uint8_t status, satCount
    int32_t lat_e7, lon_e7
    飛機端 buildTelemetry:
    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
2026-06-10 加 secrets.h.example 範本(公開,給新電腦/新使用者建 secrets.h 用)
    使用者在新電腦 git clone 後編譯 ESP32CAM_Flight 報錯:
    fatal error: secrets.h: No such file or directory
    因為 secrets.h 含 WiFi 帳密,CLAUDE.md 規則禁止進 git
    (此規則優先於使用者「commit 上去」的指令),所以這檔本機建。
    加範本 secrets.h.example:
    - 提供 #define WIFI_SSID_VAL / WIFI_PASS_VAL 結構
    - 註解寫清楚:複製成 secrets.h 後填真實值
    - 提醒 FORCE_AP_MODE = 1 時 dummy 也能編
    ESP32CAM 接到了新電腦的人:
    copy secrets.h.example secrets.h
    (用記事本改 SSID/密碼 或 留 dummy)
    → Arduino IDE 編譯就過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
2026-06-10 加 HeadTrack_Test:手機 IMU → 飛機 WiFi → 2 顆 servo(頭追原型)
    使用者要快速試頭追,不用加 IMU 硬體。用手機內建 IMU + 飛機端
    WiFi AP + 瀏覽器 DeviceOrientation API。
    ## 工作原理
    1. 飛機 LOLIN D32 開 WiFi AP「HeadTrack / head1234」
    2. 手機 WiFi 連 HeadTrack
    3. 瀏覽器開 http://192.168.4.1
    4. 網頁 JS 用 DeviceOrientationEvent 讀手機 alpha/beta/gamma
    5. 每 50ms POST 給 /o?a=X&b=Y&g=Z
    6. 飛機解析 → 映射到 servo 角度 → 寫 PIN_PAN/TILT_SERVO
    ## 接線
    - Pan servo PWM → GPIO 16(GPS 搬走後釋出)
    - Tilt servo PWM → GPIO 17(同上)
    - Servo VCC → 5V 軌(buck OUT,SG90 約 250mA peak)
    - Servo GND → 共地
    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
2026-06-10 HeadTrack_Test 頁面:Android 自動 attach,iOS 才需要按按鈕授權
    使用者試燒後反映「進頁面後不能按授權」。可能:
    1. Android 不需 requestPermission,但原本程式邏輯要點按鈕才 attach
    2. iOS 在非 HTTPS 下 requestPermission 可能 throw error
    改成分裝置處理:
    - window.onload 偵測 DeviceOrientationEvent.requestPermission 函式存不存在
    - 不存在(Android / 多數)→ 直接 attach + 隱藏按鈕
    - 存在(iOS 13+)→ 顯示按鈕等使用者點 + 授權
    UI 改進:
    - 加 #log 顯示「收到事件: N 次」(實時看 JS 有沒有觸發)
    - requestPermission 失敗印錯誤訊息到 status
    - 按鈕背景綠色比較明顯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
    [HeadTrack_Test.ino]
2026-06-10 HeadTrack 頁面 JS:不靠 onload + 加診斷訊息 + 5 秒沒事件提示換瀏覽器
    使用者試 Android 進頁面後一直「等待事件」,Android 按鈕也沒
    被隱藏 → window.onload 沒生效 / 或 Chrome HTTP 環境封鎖 sensor。
    - 直接在 script 結尾立刻執行偵測 + attach,不用 window.onload
    - setStatus / setLog 函式統一更新 UI
    - 立刻顯示「偵測:DOE=true reqPerm=false」(看是 iOS 還 Android)
    - 5 秒沒收到事件 → 提示換 Firefox / DuckDuckGo 或 chrome://flags
    背景:Chrome Android 96+ 在 HTTP 環境**封鎖 DeviceOrientation**,
    事件不會 fire 即使 listener 已 attach。
    - Firefox Android 通常仍允許
    - DuckDuckGo Browser 也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
2026-06-10 HeadTrack 加方案 A 滑桿(不靠 sensor),確認 servo pipeline 通
    使用者 Chrome Android 封鎖 sensor 不能讀 IMU,加兩個大滑桿備案:
    - Pan 滑桿(-60~+60)→ /o?a=值 → 飛機 pan servo
    - Tilt 滑桿(-60~+60)→ /o?b=值 → 飛機 tilt servo
    - 30Hz 送一次(限制 oninput 速率)
    意義:
    - 確認 WiFi → ESP32 → servo 那條 pipeline 真的通(獨立 sensor 問題)
    - 滑桿一拖 servo 跟著動 = pipeline OK,sensor 是另外的問題
    - 之後解 sensor 問題(換 Firefox 或加 HTTPS),IMU 自動駕駛 servo
    UI 分兩個區塊:
    - 方案 A:滑桿(永遠能用)
    - 方案 B:手機 IMU(瀏覽器允許才能用)
2026-06-10 HeadTrack 改用 beta+gamma 而非 alpha,符合手機橫放直觀
    之前 alpha → pan 是「指南針方位」,絕對方向,飛機飛起來轉身 servo
    會亂跑,不直觀。
    - γ(gamma,左右傾)→ pan servo
    手機橫放面對你,左右傾就是左右轉相機
    - β(beta,上下傾)→ tilt servo
    手機前後傾就是上下轉相機
    不用 alpha(那條保留 Mode 02 GPS 飛 yaw 對齊用)。
    如果實測方向相反(手機左傾結果 servo 右轉),把該軸 constrain 後
    乘 -1 即可。先燒看看哪個方向是正的。
    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
2026-06-10 Ground_TX_ESP32 PID 預設值同步飛機新保守值(1.0 / 0.01 / 0.3 / 0.8 / 0.01)
    使用者發現手把 PID 選單預設值還是舊的高值(2.0/0.02/0.5/1.5/0.02),
    跟飛機新預設(1.0/0.01/0.3/0.8/0.01)不一致 → 使用者進選單按 OK
    就會把舊高值覆蓋飛機新值,馬達又狂轉。
    同步成保守值,飛起來再用 +/- 慢慢加大調整。
2026-06-10 手把 mode0 選單加校準按鈕 + 飛機 PID 持久化 NVS
    手把:
    - params[] 加 3 個動作項目:保存PID(102) / 快速校準(100) / 完整校準(101)
    - N_PARAM 5 → 8,選單行高 46 → 30 塞下 8 列
    - isAction 項目:OK 觸發、paramVal 當 pulse counter、顯示 GO 不顯示數值
    飛機:
    - 開機 loadPIDFromNVS():把上次手把調過的 5 個 PID 從 NVS 讀回來
    - savePIDToNVS():paramID 102 觸發
    - applyCommand 加 case 100/101/102:呼叫 calibrateGyroQuick / calibrateFull / savePIDToNVS
    - dedup 用 (id, val) 配對:相同就不再做,避免動作重複觸發 + Serial 洗版
    操作流程(都不用接電腦了):
    - 模式 00 + OK → 進選單
    - 推搖桿選項目,+/- 改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
2026-06-10 修 PID 選單離開再進空白 bug
    drawMenuDynamic 用 static lastCursor / lastVal[] 跳過沒變動的列,
    但 drawMenuStatic 已經把畫面清掉了 → 第二次進來看似沒變,結果什麼都沒畫。
    加 g_menuDirty 旗標,drawMenuStatic 設 true,
    drawMenuDynamic 強制重畫一輪後再清掉。跟 g_flightDirty 同樣手法。
    [Ground_TX_ESP32.ino]
2026-06-10 MAX_ANGLE 15° → 20°(中等響應,室內外都還 OK)
2026-06-10 Mode10_Test Phase 1:PTT 按鈕錄音到 PSRAM
    獨立 sketch,不動現有 Ground_TX_ESP32。先驗證錄音 pipeline。
    - 左肩鈕(GPIO 8)按住開始、放開停止
    - 16kHz mono int16(Whisper 標準格式)
    - PSRAM buffer 10 秒上限 = 320KB
    - 沿用 Voice_Test 的 I2S RX 設定(32-bit slot >> 16)
    - Serial 印 samples / 時長 / max / rms,自動判斷訊號太弱/正常/爆音
    下個 Phase:WiFi + Groq Whisper API。
2026-06-10 .gitignore 加上 不可上傳/(第三方參考專案 / 含敏感資料)
2026-06-10 修飛行畫面姿態數值偶爾消失 bug
    切到未實作 mode (02/12/22) 再切回實作 mode (00/01) 時,
    block change 觸發 fillRect 清掉主體區,但 tele.roll/pitch/yawRate
    若沒變化就不會進值重畫分支,結果只有 label 沒有數字。
    block 變化處加 g_flightDirty=true,強制下面值檢查重畫。
    跟 drawFlightStatic / drawMenuStatic 同樣手法。
    [Ground_TX_ESP32.ino]
2026-06-10 移除已搬進不可上傳/ 的檔案
    舊 Nano 手把(6_Channel_Receiver/Transmitter)、6 通道 PDF + jpg、
    舊 RX/TX 照片、tyty 都搬到 不可上傳/ 資料夾(本地保留參考、
    不進版控)。
    不可上傳/ 已加入 .gitignore (11e9f7b)。
2026-06-10 Mode10_Test Phase 2:加 WiFi + Groq Whisper STT
    放開肩鈕後自動上傳 PCM 到 Groq Whisper API,辨識中文文字印 Serial。
    - 自製 44-byte WAV header(16kHz/mono/16bit)
    - multipart/form-data 手刻,streaming 寫 TLS 不全部塞 RAM
    - 跳憑證驗證(嵌入式裝不下 CA cert)
    - whisper-large-v3-turbo + language=zh,延遲 ~1~2 秒
    - 粗糙 JSON parse 抓 "text" 欄位(後續換 ArduinoJson 再說)
    secrets.h.example 提供範本,真檔 secrets.h 由使用者本機建立,
    已在根 .gitignore 排除(**/secrets.h)。
2026-06-10 Mode10_Test:WiFi TX 功率降到 8.5dBm 避免 brown-out
    預設 19.5dBm TX 瞬間吸 ~300mA,手把 3V3 LDO 撐不住,
    連線過程就 brownout 反覆重啟。降到 8.5dBm 約一半電流。
    桌面測試距離夠用。
    長期硬解見 memory handle-3v3-power-upgrade。
    [Mode10_Test.ino]
2026-06-10 Mode10_Test:WiFi TX 降到 2dBm + 關 brown-out(暫時)
    8.5dBm 還是 brown-out 重啟,降到 2dBm 並暫時關掉
    brown-out detector 看晶片能不能撐過電壓瞬間 dip。
    危險:正式版要拿掉 RTC_CNTL_BROWN_OUT_REG=0,
    硬體穩定後 (TFT 改 5V 或加外部 LDO) 再恢復 detector。
    [Mode10_Test.ino]
2026-06-10 Mode10_Test:用 REG_CLR_BIT 正確關 BOD,S3 上 WRITE 整 reg 沒效
2026-06-10 加 WiFi_Min_Test 最小 WiFi 連線測試 sketch
    只做 WiFi.begin + 印心跳,沒有 I2S / PSRAM 配置 / 其他干擾。
    從手把模組拆下單獨測 ESP32-S3,確認晶片本身能不能撐 WiFi。
    若這支也 brown-out → 換 USB 線/埠/充電器,排除供電。
    [WiFi_Min_Test.ino]
2026-06-10 WiFi_Min_Test:每步加 print 找死掉位置 + setTxPower 移到 begin 後
2026-06-10 WiFi_Min_Test:極簡版,連 BOD/setTxPower 都拿掉
2026-06-10 WiFi_Min_Test:改 AP 模式廣播 ESP32_TEST,完全跳過 secrets/熱點變數
2026-06-10 WiFi_Min_Test:加 classic ESP32 (38-pin) profile 當對照組
2026-06-11 INM_Test:IDE auto-format(純空白調整,無功能變動)
2026-06-11 Mode10_Test:加 TFT 顯示狀態 + 辨識結果
    電池供電架構(LD1117 不接 USB)下,USB 拔掉就看不到 Serial,
    所以把所有狀態跟最後辨識的文字顯示在 TFT 上。
    新增 TFT 顯示:
    - 標題列 Mode 10 語音
    - 中間狀態:開機中 / WiFi 連線中 / 就緒 / 錄音中 / 上傳中 / 完成 / 失敗
    - 下方辨識結果區:Groq Whisper 回的文字
    沿用 Ground_TX_ESP32 的 LovyanGFX ILI9341 配置(SPI2_HOST,
    SCK 38 / MOSI 39 / MISO 40 / CS 48 / DC 21 / RST 16)。
2026-06-11 Mode10_Test:TFT setRotation(0) → (2) 翻 180°,跟其他 sketch 同向
2026-06-11 Mode10_Test Phase 3:Groq Llama 解析文字成 JSON 指令
    辨識文字後再呼叫 llama-3.1-8b-instant 把中文翻成結構化 action。
    新增:
    - LLM_SYSTEM_PROMPT 定義 action 集合:takeoff/land/move/stop/mode/unknown
    - parseCommandWithLlama():POST 到 /chat/completions,response_format=json_object
    - jsonEscape / jsonUnescape:處理 JSON-in-JSON 嵌套字串
    - extractAction:從 LLM 回的 JSON 抽 action 欄位
    流程:錄音 → STT → 文字 → Llama → action → TFT 顯示 → action
    Phase 4 接 NRF24 override 用得到這個 action。
2026-06-11 Mode10_Test:拿掉 2dBm 限制,新硬體架構不需要壓 TX 功率
2026-06-11 Mode10_Test:加底部 hint 提示「按肩鈕重試」
    辨識失敗、訊號太弱、LLM 失敗、成功 都會在 TFT 底部顯示提示,
    讓使用者知道隨時可以再按肩鈕說下一句,不會看起來像當機。
    新增 tftHint() / tftClearTranscript() helpers。
    startRec 額外清掉上一輪辨識文字,視覺上知道是新一輪。
2026-06-11 Mode10_Test:Llama 換 70b + 加 few-shot 例子
    8b instant 太笨,「起飛」對不到 takeoff 一直回 unknown。
    - 模型:llama-3.1-8b-instant → llama-3.3-70b-versatile(中文強)
    - messages 加 5 組 few-shot 範例(起飛/降落/停/向前/切模式)
    - 延遲多 ~1 秒可接受
2026-06-11 Mode10_Test:LLM 換成 Google Gemini 2.0 Flash
    STT 維持 Groq Whisper(穩定免費)
    LLM 從 Groq Llama 換成 Gemini 2.0 Flash:
    - 中文理解更強
    - 免費額度 15 RPM / 1500 RPD 夠用
    - 延遲 ~1 秒,比 Llama 70b 稍快
    API 差別:
    - Gemini key 走 query string (?key=...) 不是 Header
    - request body 用 contents/parts 結構,不是 messages
    - response 抽 candidates[0].content.parts[0].text
    secrets.h 新增 GEMINI_API_KEY 欄位(AIzaSy... 開頭)。
    使用者已有 Google AI Studio 帳號。
2026-06-11 Mode10_Test:WiFi TX 降 8.5dBm + 失聯自動重連
    2S buck 架構下 WiFi TX 預設 19.5dBm 尖峰電流會打掛電源軌,
    錄音時就重啟。
    軟體解:
    - TX 功率回到 8.5dBm(範圍仍夠用,峰值電流降 30%+)
    - 上傳前呼叫 ensureWiFi() 確認連線,失聯就重連
    - 連不上時 TFT 顯示「WiFi 失聯」,不卡死
    硬體解(留給使用者):buck OUT 跟 GND 並 470µF 以上電容,
    吸收 WiFi TX 瞬間尖峰,讓電壓不掉。
2026-06-11 Mode10_Test:開機立刻拉 MAX98357A SD = LOW 消雜訊
    SD 腳浮空時 MAX98357A 隨機啟動,放大 I2S bus 上的時脈雜訊,
    喇叭出沙沙 / 卡卡聲。
    setup() 一開始就把 PIN_AMP_SD (GPIO 18) 設 OUTPUT + LOW,
    強制 amp 靜音。Phase 5 接 TTS 時才在播放前拉 HIGH、播完拉 LOW。
    memory max98357a-boot-pop-fix 早記過這個做法。
    [Mode10_Test.ino]
2026-06-11 Mode10_Test:全 Google 路線,Gemini 一次完成 STT + 解析
    捨棄 Groq Whisper(程式碼用 #if 0 暫留),改成把錄音 base64
    編碼後直接送 Gemini 2.0 Flash 的 inline_data,讓它同時做:
    1. 語音轉文字
    2. 解析成 action JSON
    回傳 JSON 格式:{"transcript":"<中文>","action":"<動作>"}
    優點:
    - 一次 API call(原本兩次)
    - 延遲降低
    - 只用一個服務(Google)免費額度 15 RPM / 1500 RPD
    成本:
    - 錄音要 base64 編碼(+33% size)
    - PSRAM 多用 ~200KB(WAV + base64 buffer 暫存)
    - 上傳資料量大一點
    新函式:
    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
2026-06-11 Mode10_Test:Gemini 失敗時 TFT 顯示具體錯誤,方便 debug
    g_geminiErr 紀錄各失敗階段的錯因(TLS 失敗 / 無回應 / HTTP
    狀態碼 / 無 text 欄位 / Gemini message 錯誤訊息),
    TFT 「失敗:XXX」直接顯示。
    電池模式看不到 Serial 也能判斷。
2026-06-11 Mode10_Test:換 gemini-2.0-flash-lite,免費限額 15 → 30 RPM
    連續測試容易撞 429 Too Many Requests。Lite 版限額多一倍,
    模型稍淺但解析語音指令完全夠用。
2026-06-11 Mode10_Test:退回 Groq Whisper + Llama 雙服務,避開 Gemini 429
    Gemini 撞 429 (Too Many Requests),改 Lite 還是撞,
    免費 project 額度直接打滿,15-30 RPM 都禁不起連續測試。
    退回:
    - STT: Groq Whisper Large v3 Turbo(20 RPM, 7200 RPD)
    - 解析: Groq Llama 3.3 70B(30 RPM,中文 OK)
    Gemini 程式碼用 #if 0 包起來暫存,額度有需要再回頭看。
    g_geminiErr 改名 g_lastErr,共用錯誤顯示。
2026-06-11 Mode10_Test:Whisper 文字清標點 + unknown 時 TFT 顯示 Llama 真實 JSON
    問題:Whisper 辨識「起飛」對但 Llama 回 unknown,看不出原因。
    - 進 Llama 前清掉前後空白 + 常見中英文標點(避免「起飛。」對不到「起飛」)
    - unknown 時 TFT hint 直接印 Llama 回來的 JSON 前 40 字,
    可以立刻看出是 prompt 沒理解、還是 extractAction 沒抓對欄位
    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
2026-06-11 Ground_TX:ENABLE_SD 重新打開,新電源架構下重測 SPI bus 共存
    SD VCC 接 buck 5V 軌。開機 TFT 會顯示 NRF24 begin / chip
    connected / SD 掛載三個狀態,chip connected=NO 代表 level
    shifter 還是搶 bus,就改回 0。
2026-06-11 新增 docs/ 報告網站:互動架構圖 + 開發故事線(GitHub Pages 用)
    單頁深色主題網站,給課堂報告 / 專題發表投影用:
    - 數字總覽:192 提交 / 28 sketch / 9 模式 / 3 顆 ESP32
    - 互動系統架構圖:手把/飛機/雲端三欄,點元件顯示功能+踩坑故事
    - 開發故事時間軸:4 月啟動 → 飛控三階段 → 遙測 → 手把 V2
    → 整合除錯 → 電源之戰 → Mode 10 語音,點標題展開細節
    - 電路圖圖庫(點圖放大)+ 未來計畫卡片
    - 純 HTML/CSS/JS 無相依套件,離線也能開
    啟用方式:GitHub repo Settings → Pages → main branch /docs。
2026-06-11 docs 改版:正式技術報告風格,移除舊電路圖
    依使用者要求從「開發故事」改為企業級技術報告:
    - 10 節編號結構:摘要 / 規格總覽 / 架構 / 硬體設計 / 通訊協定
    / 飛控軟體 / 語音子系統 / 測試驗證 / 未來工作 / 參考資料
    - 內容全部從現行程式碼撈實際數據:腳位表(手把 S3 + 飛機)、
    Signal/Telemetry 封包欄位表、互補濾波 0.98/0.02、PID 增益、
    X 型混控公式、mode 編碼表、NRF CH88
    - 新畫兩張 SVG 圖:雙 LDO 電源架構圖、Mode 10 辨識管線圖
    (取代過時的 PNG 接線圖,docs/img 移除)
    - 問題解決紀錄改正式 issue 表(I-01~I-08:根因/處置/狀態)
    - 參考資料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
2026-06-11 docs 拆分多頁 + 補程式架構 + 模式/PID/校準大幅擴充
    依回饋改版:
    - 單頁太長 → 拆 6 頁:index(封面/摘要/規格/章節卡)、
    architecture(互動圖+程式架構+通訊協定)、hardware(電源+腳位)、
    control(模式/PID/校準,最厚一章)、voice、testing
    - 共用樣式抽到 style.css,每頁有上下頁導覽
    - 新增 A.2 程式架構:主程式+28 單元測試雙層策略、
    飛控 50Hz 主迴圈資料流 SVG(圖 A-1)、地面站 dirty-flag
    繪製策略、功能旗標、secrets.h、NVS 持久層
    - C 章大幅擴充(使用者指明最麻煩的部分):
    - 武裝安全鏈 4 層表(開機 LOCK/模式白名單/油門條件/失聯)
    - PID 調參歷程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
2026-06-11 docs 對齊作業評分項目:作品功能/實驗設計/作品展示
    依評分表(功能 40% / 實驗設計 40% / 展示 20%)補強:
    - index 新增「作品功能」章:7 項功能總覽表,內文引用
    參考資料 [1]-[4](連到 E.5)滿足「至少引用 2 個來源」
    - hardware 新增 B.0「材料選擇與組裝方式」:7 項材料選型
    理由表 + 組裝方式(三板架構/洞洞板/佈線迭代/Python 產圖)
    - control 新增程式碼節錄附說明 ×2(互補濾波、混控,
    含逐段白話解說)滿足「程式碼需附說明」
    - testing 改名「作品展示與驗證」:
    - E.1 實機展示(media-grid 結構就緒,照片影片待補)
    - E.2 發現與分析(原問題表加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
2026-06-11 docs 勘誤 + 程式架構樹狀圖 + 應用價值改室外導向
    - 飛機主控更正:38-pin 開發板 → LOLIN D32(ESP32-WROOM-32),
    依 飛機接線總表.md(三處:index 規格表、架構圖節點、腳位表標題)
    - 螢幕尺寸更正:2.4" → 2.8" MSP2806(依 手把接線總表_V2.md,三處)
    - 錯字:響應過敏 → 響應過於靈敏
    - A.2.1 加專案樹狀圖(主程式模組分解 + 測試程式 + 文件/腳本),
    程式架構以樹狀呈現
    - E.3 應用價值改以室外為主:戶外定點巡檢、空拍紀錄排前,
    移除室內 / 居家場景描述
2026-06-11 加 README + VL53L0X 更新為 4 顆 + 未來工作補預定項目
    - README.md:repo 首頁介紹(系統組成/主要功能/倉庫結構/
    編譯需求/安全注意/開發狀態),連到 GitHub Pages 報告
    - 雷射測距 ×2 → ×4(使用者已全數裝上):index 規格表、
    架構圖節點與說明
    - E.4 未來工作補:雷射避障(硬體已就緒)、Mode 11 PC 控制、
    地面站體驗強化(常駐選單/音樂/TTS);定高項合併自動降落
2026-06-11 docs 首頁封面加網站 QR code(掃描即達 GitHub Pages 報告)
    報告投影時觀眾可直接掃碼在手機閱讀。封面改左右排版
    (文字左、QR 右),窄螢幕自動直排。
2026-06-11 Ground_TX:SD 搬到獨立 SPI3,腳位 SCK15/MOSI17/MISO3
    2026-06-12 實測確認:SD 模組 level shifter 在共用 bus 上
    不釋放 MISO,接上 NRF24 就死,跟電源無關(I-02 根因成立)。
    解法:SD 改用 S3 第二組 SPI(HSPI/SPI3)+ 專用三條線:
    - SCK = GPIO 15(真正釋出腳)
    - MOSI = GPIO 17(真正釋出腳)
    - MISO = GPIO 3(JTAG sel,平常無作用)
    - CS = GPIO 47(沿用)
    NRF24/TFT 留在原 38/39/40 bus 完全不動。
    使用者要重接 SD 模組三條線(SCK/MOSI/MISO 從共用 bus
    改到 15/17/3),VCC 維持 5V 軌。
2026-06-11 SD_Test 改寫:獨立 SPI3 新腳位 + 三段降速重試 + USB 供電說明
    - 腳位同步 Ground_TX 新配置:SCK15 / MOSI17 / MISO3 / CS47(HSPI)
    - 4MHz → 1MHz → 400kHz 自動降速嘗試,排除線長/雜訊問題
    - 掛載後印卡類型/容量 + 寫入測試 + 列根目錄
    - 重要:USB 測試時 SD VCC 要暫接板上 5V 腳(buck 軌只有
    電池模式有電),檔頭寫清楚
2026-06-11 SD_Test 加 TFT 顯示:電池模式測試,SD VCC 留 buck 軌不用改線
    電池模式才有周邊電但沒 Serial(供電互斥鐵律),
    所有結果改成 TFT 逐行顯示(show() 同步印 Serial + TFT)。
    掛載三段降速、卡資訊、寫入測試、根目錄全部上螢幕。
2026-06-11 SD 腳位修正:MISO 3→47、CS 47→0(GPIO 3 是接線總表標記避開的腳)
    手把接線總表_V2.md §二 明寫「避開:3、26~37、45、46」,
    GPIO 3 不可用(實測掛載也全失敗)。改回總表原始設計:
    - CS = GPIO 0(BOOT 腳,輸出閒置 HIGH 安全,C 板 R11 10k 上拉)
    - MISO = GPIO 47(原 CS 腳讓出)
    - SCK 15 / MOSI 17 不變
    SD_Test 與 Ground_TX_ESP32 同步更新。
    [Ground_TX_ESP32.ino, SD_Test.ino]
2026-06-11 docs:I-02 結案(SD 獨立 SPI3 + 換壞線後掛載成功)
    - I-02 補雙重根因(shifter 佔 MISO + VCC 線接觸不良 5V→1.8V),
    狀態改已結案
    - B.2 腳位表:SD 從共用 SPI 列移出,新增 SPI3 專用列
    (SCK15/MOSI17/MISO47/CS0)
    - SPI 共存 callout 補「已用 GPIO matrix 移至獨立 SPI3」
    - E.4 SD 項改為硬體已驗證、待實作功能
2026-06-11 Play_Test 改 SD 獨立 SPI3 腳位(SCK15/MOSI17/MISO47/CS0)
    跟 Ground_TX_ESP32 / SD_Test 一致。順手拔掉 neopixelWrite(48)
    —— 那是 devkit RGB LED 的腳,手把上 48 是 TFT CS,不該戳。
    播放邏輯(WAV 循環 + boot pop 消除)不動。
2026-06-11 Ground_TX:音樂功能上線(ENABLE_MUSIC=1,選單第 9 項播放/停止)
    Play_Test 驗證過的播放路徑整合進主程式:
    - initMusicI2S():I2S_NUM_0 TX @32kHz mono,大 DMA(8×512)
    + 預灌 silence 消 boot pop
    - musicUpdate():非阻塞餵料(timeout 0),DMA 滿就倒帶 SD 檔案
    位置立刻返回,絕不卡 50Hz 控制迴圈;每迴圈最多 32ms 音訊
    - musicToggle():選單觸發,優先播 /music/ 第一首,
    沒有就退回 /REC_001.WAV
    - MAX98357A SD 腳開機拉低,播放才開(消雜訊老規矩)
    - 選單加第 9 項「音樂」(id 200 本地動作,不送飛機),
    行高 30→26 塞進 40~280px
    WAV 規格:32kHz / 單聲道 / 16-bit PCM
2026-06-11 新增 Video_Test:SD MJPEG 影片 + WAV 聲音播在 TFT 上
    手把變小電視:
    - /video.mjp(MJPEG 連續 JPEG 幀,320×240 @20fps)+
    /video.wav(32kHz mono 16-bit)放 SD 根目錄
    - JPEGDEC 逐幀解碼 → LovyanGFX pushImage,螢幕轉橫向
    - 聲音當時鐘:用已餵入 I²S 的 PCM bytes 推算目標幀,
    解碼落後 >2 幀就只讀不解碼(跳幀)追同步
    - 幀緩衝 160KB 放 PSRAM;MJPEG 幀標記塊狀掃描(1KB chunk)
    - 播完自動循環;沒放 video.wav 就無聲用 millis 計時
    需要 Library Manager 裝 JPEGDEC(Larry Bank)。
    轉檔指令寫在檔頭(ffmpeg 兩條)。
2026-06-11 Ground_TX 音樂修卡頓:DMA 緩衝 128ms→190ms + 每圈餵料上限 32ms→128ms
    主程式 loop 比 Play_Test 忙(NRF24 失敗重試 ~10ms + TFT 動態
    重繪),原本緩衝撐不住偶發的長迴圈 → underrun 卡頓。
    - DMA:8×512 → 6×1023 frames(約 190ms 餘裕,24KB 內部 RAM)
    - musicUpdate 每圈 rounds 4→16(DMA 滿提前 return,不會拖迴圈)
2026-06-11 Video_Test:轉檔指令補 -f mjpeg(ffmpeg 不認 .mjp 副檔名)
2026-06-11 Video_Test:改直式播放 + 不編碼黑邊置中顯示 + 15fps
    螢幕是直立安裝,rotation 3→2(跟其他程式同向)。
    轉檔改 scale=240:-2(寬 240 高自動,不 pad 黑邊),
    程式用 jpeg.getWidth/Height 算偏移置中 → 解碼像素少 43%,
    配 15fps 解卡頓。
2026-06-11 Video_Test:SD 時脈 4→20MHz(降速 fallback)+ 轉檔指令通吃直橫式
    卡頓根因:SD 預設 4MHz 實際 ~400KB/s,影片+聲音 ~215KB/s
    太貼極限。獨立 bus + 短線直上 20MHz(失敗自動退 10/4MHz)。
    畫面切半根因:直式來源用 scale=240:-2 會變 240×426 超出螢幕,
    改 force_original_aspect_ratio=decrease 塞進 240×320。
2026-06-11 Ground_TX:Mode 20 媒體模式上線(SD 影片播放)
    Video_Test 驗證過的播放器移植進主程式:
    - SW_A=2 / SW_B=0(mode 20)→ 進媒體選單,列 /video/*.mjp
    - 右搖桿選檔、OK 播放、返回/OK 停止、模式開關撥走立刻退出
    - 同名 .wav 自動當聲音(聲音時鐘同步+跳幀);沒有就無聲
    - 聲音播完自動無縫切 millis 時鐘,影像不停
    - 安全:NRF24 照送 mode=20,飛機白名單擋掉自動 disarm;
    進入時自動停背景音樂(共用 I²S)
    - 幀緩衝 160KB PSRAM 首次進入才配置
    flag:ENABLE_VIDEO_MODE20(需 ENABLE_MUSIC + JPEGDEC 函式庫)
2026-06-11 Mode 20 媒體模式完整化:影音混合選單 + 播放控制鍵
    選單:
    - /video/*.mjp 與 /music/*.wav 混列,[影]/[樂] 標記
    - 右搖桿上下選、OK 播放
    播放中按鍵(影片音樂通用):
    - ↑/↓(+/-) 音量 ±10%,頂部顯示音量提示
    - →(OK) 暫停/繼續(靜音 + millis 時鐘補償暫停時長)
    - ←(返回) 退出回媒體選單
    - 模式開關撥走仍然立刻退出(最高優先)
    音樂播放共用 ENABLE_MUSIC 的 musicPlay/musicUpdate,
    專屬播放畫面顯示檔名與操作提示,播完自動回選單。
2026-06-11 Mode 10 語音控制接飛行鏈路(步驟 3 一次完成,雙端編譯驗證過)
    == 架構 ==
    語音管線(錄音→WiFi→Groq Whisper→Llama→action)跑核心 0
    獨立 task;主迴圈(核心 1)50Hz 控制完全不中斷。
    WiFi(≤2.472GHz)與 NRF CH88(2.488GHz)頻率錯開可共存。
    action 在主迴圈轉「虛擬搖桿」覆寫 Signal 封包 → 飛機端只改
    白名單一行,所有飛行安全機制原封不動。
    == 手把(Ground_TX)==
    - ENABLE_VOICE_MODE10=1:mode 10 專屬畫面(狀態/動作/遙測)
    - 左肩鈕 = PTT(mode 10 時 yaw 固定中立)
    - I²S 全雙工:micRx 與 musicTx 同 port 共 BCLK/WS @32kHz
    - 虛擬搖桿程式:takeoff(1.5s 升至懸停)/ hover / move(限時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
    [partitions.csv]
2026-06-11 媒體模式 20→12 + 修影片紅綠雜訊(setSwapBytes)
    - 使用者指定媒體模式搬到 mode 12(SW_A=1/SW_B=2),20 還回預留
    - 紅綠雜訊根因:主程式 TFT 沒設 setSwapBytes(true),JPEGDEC 的
    RGB565 little-endian 位元組顛倒。進媒體模式設、退出還原。
    - arduino-cli 重編譯通過
2026-06-11 語音 demo 模式:還不穩飛之前,語音控制改成單馬達輕轉
    使用者需求:能語音讓其中一顆螺旋槳輕輕轉就好,先不碰飛行。
    手把(VOICE_DEMO_SPIN=1,旗標關掉即回完整飛行映射):
    - 新 action spin:「轉一號馬達」→ {"action":"spin","motor":1}
    (prompt + few-shot 同步加)
    - demo 映射:起飛→轉1號 / 轉N號馬達→轉N號 / 降落・停→停轉
    - 經 paramID 110(轉,paramVal%10=馬達編號+pulse 防重複)
    / 111(停)送飛機,不碰虛擬搖桿
    - applyCommand 加 110/111:只在「未武裝 + 油門收底」受理
    - writeMotors 未武裝分支:指定馬達 PWM 1100 輕轉,3 秒自動停
    - 武裝後 demo 自動失效(armed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
2026-06-11 Mode 12 修卡頓 + 清單擴充捲動
    - 主程式 SD 也提到 20MHz(降速 fallback)— 之前只提了
    Video_Test,主程式還在 4MHz 餵不動影片才卡
    - 媒體清單上限 8→16,一頁 7 列自動捲動 + 右下 n/N 指示
    (影片+音樂合計超過 8 個時後面的會被吃掉)
2026-06-11 Mode 10 語音回應:辨識完成喇叭唸出「收到,起飛」等確認句
    技術:回應句是固定集合 → 預錄 WAV 放 SD /voice/,零延遲、
    不吃 API 額度、離線可用。檔案用 Windows TTS(Microsoft
    Hanhan zh-TW)生成 + ffmpeg 轉 32kHz mono s16,收在 repo
    sd_voice/ 方便重灌 SD。
    流程:語音 task 解析完設 g_vSpeak ID → 主迴圈(擁有 SD+I2S)
    用現成音樂管線 musicPlay/musicUpdate 非阻塞播放,50Hz 不受影響。
    8 句:收到起飛/降落/停止、轉一~四號馬達、聽不懂請再說一次。
    使用者要把 sd_voice/*.wav 複製到 SD 卡 /voice/ 資料夾。
2026-06-11 辨識中重啟除錯:開機畫面顯示重啟原因 + 預防性修補
    使用者回報語音辨識到一半自動重啟(WiFi TLS 上傳階段)。
    電池模式看不到 Serial → 開機狀態畫面加「上次重啟:XXX」,
    區分 BROWNOUT(電壓不足)/ PANIC(程式)/ WDT(看門狗)。
    預防性修補(兩個可能根因先堵):
    - 語音 task 堆疊 12288→16384(TLS+String 保險)
    - HTTP 回應接收迴圈加 vTaskDelay(1),防核心 0 IDLE 餓死
    觸發 task watchdog
    [Ground_TX_ESP32.ino]
2026-06-11 docs 更新:實機照片/影片上線 + 新功能同步
    - E.1 實機展示:7 張照片(飛機/手把/各模式畫面/PID 選單)
    + Mode 12 媒體模式展示影片(130MB 壓到 3.6MB,檔名轉英文)
    - 作品功能表:AI 語音改「單馬達展示可用」含語音回應;
    新增媒體播放(Mode 12)列
    - 模式表:10 展示可用、12 媒體模式已完成
    - voice 章新增 D.4 主程式整合:雙核心分工表、單寫者共享、
    I²S 全雙工、語音回應(預錄方案理由)、安全映射說明
    - 未來工作同步(語音銜接完成→改完整映射待解鎖)
2026-06-11 docs:D 章規格同步整合版(32kHz 取樣、指令表 mode→spin)
2026-06-11 修語音辨識中 task WDT 重啟(開機畫面確診:看門狗)
    根因:語音 task 在核心 0 上傳 512KB 錄音(TLS 加密 + 傳送)
    連續佔 CPU 超過 5 秒,IDLE0 餓死觸發 task watchdog 重啟。
    1. 上傳迴圈每 4KB 塊 vTaskDelay(1) 讓出 CPU(關鍵修正)
    2. 錄音 2:1 降採樣 32k→16k 上傳(I²S 時脈不動):
    資料量砍半、上傳時間砍半、Whisper 16kHz 完全夠用
    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
    [Ground_TX_ESP32.ino]
2026-06-11 docs:照片轉正 + 分配到對應章節
    - mode00/mode01/pid-menu/boot-screen 四張逆時針轉 90°(原檔
    螢幕文字橫躺)
    - 照片分配:架構章放飛機正面/俯視、硬體章放手把成品/開機
    自檢、飛控章 C.1 放兩張模式畫面、C.3.3 放 PID 選單
    - E.1 總覽圖庫保留全部
2026-06-11 docs:handle-front.jpg 轉正(天線朝上)
2026-06-11 照片快取破壞 + 圖庫去重 + 徹底解 task WDT 重啟
    - 照片其實已轉正,使用者看到的是瀏覽器/CDN 快取 → 五張
    轉過的圖網址加 ?v=2 強制更新
    - E.1 圖庫只留展示影片,照片已分置各章不重複,加說明指引
    - 語音 WDT 重啟二度發生 → setup 直接 esp_task_wdt_deinit():
    手把非飛行安全件,TLS 上傳佔核心 0 的本質問題等 ESP-SR
    本地辨識取代雲端後再開回 WDT
2026-06-11 新增 NES_Test(紅白機模擬器)+ 飛機端序列埠數據截圖入架構章
    NES_Test(arduino-nofrendo 移植,編譯通過 571KB):
    - 顯示:Arduino_GFX ILI9341 on SPI2(沿用手把腳位)
    - 聲音:MAX98357A 外部 I2S DAC(BCLK11/WS12/DOUT13)
    - SD:獨立 SPI3 掛載 /fs,自動找根目錄第一個 .nes ROM
    - 操作:右搖桿=十字鍵(軸向反相已處理)、右肩=A、左肩=B、
    按鍵叢 OK=Start、返回=Select
    - 硬體前提:右搖桿 X 要接到 GPIO 10(roll 預留線)
    - 需 git clone arduino-nofrendo + Arduino_GFX 兩個庫,
    且 nofrendo 的 memguard.c 要補 include(新 GCC 拒絕隱式宣告,
    本機已 patch;換電腦要重做,見 sketch 檔頭)
    docs:飛機端序列埠即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
2026-06-11 NES_Test 顯示層換 LovyanGFX 修白畫面
    Arduino_GFX 的 ILI9341 init 在我們板上不認(白畫面=背光有電
    但面板沒初始化)。display.cpp 全面改用 Ground_TX 驗證過的
    LovyanGFX 配置,逐行 myPalette 轉 RGB565 後 writePixels。
    .ino 拔掉 Arduino_GFX 依賴,錯誤訊息走 display_message()。
    編譯通過 571KB。
2026-06-11 NES_Test 左右改用左搖桿 X(GPIO 2,本來就接好)
    使用者指正:左搖桿 X 有接線。改用它當左右、右搖桿 Y 當上下,
    全部現有接線,不用接 GPIO 10。
2026-06-11 修 Mode 10 辨識亂回:麥克風 RX slot 改 LEFT-only
    RX 繼承了喇叭 TX 的雙 slot(BOTH)設定,INMP441 只在 LEFT
    slot 出資料,錄音 buffer 穿插垃圾 → Whisper 聽到雜訊,
    回幻覺文字 → Llama 判 unknown。RX slot_mask 改 LEFT。
2026-06-11 NES_Test 開機逐步診斷上螢幕(白畫面除錯)
    display 最先 init,之後每步在螢幕印進度(display/serial/wdt/
    amp/SD/ROM)。電池模式看不到 Serial,看畫面停在哪行就知道
    掛在哪。esp_wifi_deinit 順便移除(沒 init 過不必 deinit)。
2026-06-12 QRcode常駐右上角
2026-06-12 改進另一台電腦的 QR 常駐 + push 腳本
    - QR 從 top:12 移到 nav 下方(不壓導覽列),z-index 降到 nav 之下
    - 首頁拿掉重複的右上小 QR(封面已有 140px 大 QR 給投影掃描)
    - push_docs.ps1:commit 訊息原本寫死,改成參數化+時間戳預設;
    修 PowerShell \n 不換行問題;只檢查 docs/ 的變更
2026-06-12 NES_Test 加 sketch.yaml(burn.ps1 一鍵燒,排除 IDE 設定變因)
2026-06-12 NES_Test 診斷同步走 Serial(USB 模式抓開機崩潰)
2026-06-12 NES_Test:直式顯示 + 重啟原因診斷 + 暫關聲音切分崩潰
    - rotation 3→2 直式(NES 256 寬裁兩側各 8px → 240 全寬)
    - 開機顯示 last reset:圖標閃現又消失若是崩潰重開迴圈,
    第二輪會顯示 PANIC/WDT 抓到證據
    - HW_AUDIO 暫時註解:legacy I2S 驅動是崩潰頭號嫌疑,
    畫面穩定就確認是它,再correctly移植到新驅動
    [NES_Test.ino, display.cpp, hw_config.h]
2026-06-12 NES_Test:聲音移植 i2s_std 新驅動 + B 鍵改按鍵叢「+」
    - 切分測試確認 legacy I2S 驅動 = 崩潰兇手,sound.c 全面
    重寫成 i2s_std(行為照原版:每幀拉 callback,mono→stereo)
    - HW_AUDIO 開回來
    - 左肩鍵難按 → B 主力改按鍵叢「+」(可與右肩 A 同時按),
    左肩保留備用
2026-06-12 修語音永遠 unknown:JSON 解析不容忍 Llama 美化格式
    PC 端完整重現雲端管線抓到根因:
    - key 有效、Whisper 正常(回簡體「起飞」也沒關係)
    - Llama 對繁簡輸入都正確回 action
    - 但 Llama 有時回美化 JSON:{"action": "takeoff"}(冒號後
    有空格+換行),手把解析找的是 "action":" 緊貼格式 → 比對
    失敗 → 永遠 unknown
    vEmitAction 的 field() 改容錯:找 key → 找冒號 → 找下一對
    引號,不再假設格式緊湊。
2026-06-14 新增 Retro-Go 全主機模擬器 target(NES/GB/GBC/SMS/GG)
    使用者選全主機路線。Retro-Go(ESP-IDF)的自訂硬體 target:
    - config.h:腳位全沿用手把現有接線(顯示 SPI2、SD SPI3、
    MAX98357A I2S),輸入 = 雙搖桿 ADC 方向 + 按鍵叢 ADC(B/
    START/SELECT)+ 雙肩鈕(A / MENU)
    - env.py / sdkconfig:沿用官方 esp32-s3-devkit(同晶片、octal
    PSRAM、16MB flash,完全對上 N16R8)
    - 已在 clone 下來的 retro-go config.h 註冊 RG_TARGET_FLIGHTFLIGHT
    本資料夾是備份;README 寫完整安裝建置流程(裝 ESP-IDF 5.1 →
    放 target → rg_tool.py install)。ESP-IDF 未裝,無法在此預編譯
    驗證,需使用者裝好工具鏈後實機迭代(畫面方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
2026-06-17 Ground_TX:Mode 22 WiFi 環境掃描(被動診斷)
    使用者自己實驗室研究用。被動列出附近 WiFi AP:
    - SSID(隱藏顯示「隱藏」)、加密鎖頭、通道、RSSI
    - RSSI 上色(>-60 綠 / >-75 黃 / 更弱紅)
    - OK 重掃、+/- 捲動、模式開關撥走離開
    - 純被動 WiFi.scanNetworks,只「聽」不發射,合法
    - 用內建 WiFi,不加模組;UI 全中文
    - mode 22 不送 NRF(飛機 1 秒 failsafe 自動 disarm,安全)
    只整合合法的被動掃描;干擾/攻擊類(jammer/deauther/evil
    portal)不做 —— 對外發射會傷及第三方。編譯 +2KB,71%。
    [Ground_TX_ESP32.ino]
2026-06-17 進度.md 全面重建,對齊現況(2026-06-14)
    舊版停在 V2-A 早期(MAR2406 並列 TFT、無雙 LDO/語音/媒體/遊戲)。
    重建涵蓋:雙 LDO 電源、Mode 10 語音(辨識+回應+雙核心)、
    Mode 12 媒體、Mode 22 WiFi 掃描、SD 獨立 SPI3、VL53L0X×4 已裝、
    NES_Test + Retro-Go 全主機(實測 OK)、報告網站、v3 願景。
    三欄(程式/硬體/實測)+ 里程碑 + 未來版本。
2026-06-18 @ 手把校準畫面提示 + 參數抗丟包;FC 加 ESC 油門行程校準
    手把 Ground_TX_ESP32:
    - 校準狀態全畫面提示(drawCalOverlay):進 mode 0 / 選單校準時跳
    「校準中…」藍屏 → 成功綠屏 / 晃動失敗紅屏。FC 校準會阻塞不回
    telemetry,故由手把自身觸發時刻驅動,結束後讀 STATUS_CAL_FAILED 判成敗。
    - 參數重送窗口(g_paramHoldUntil 400ms):調 PID / 按校準後連送 ~20 包,
    抗 nRF24 偶發丟包;FC 端 lastID/lastVal 去重只套用一次。
    FC Drone_FC_Full:
    - 新增 esccal / esccalmin 兩個 Serial 指令做 SimonK ESC 油門行程校準,
    escCalActive 旗標讓校準期間主迴圈不碰馬達。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
2026-06-18 修校準結果誤報:飛機未連線時不顯示完成
    drawCalOverlay 結果改三態:校準視窗結束時若最近 1 秒收不到遙測(g_lastTeleMs),顯示灰屏「飛機未連線/校準未確認」,不再因 fail bit=0 就誤報「校準完成」。teleOK 收包處記錄 g_lastTeleMs。
    [Ground_TX_ESP32.ino]
2026-06-18 校準中畫面加進度條
    drawCalOverlay 校準中頁加綠色進度條(g_calBusyStart→g_calBusyUntil 時間比例),每 render tick 更新;文字層級調為 24/16/14。進度為手把端估計倒數(FC 校準阻塞無法回即時進度)。
2026-06-18 手把抗抖:搖桿 ADC 取樣平均+死區、姿態顯示加重畫門檻
    搖桿:analogReadAvg 12 次平均 + pitch/roll 中位死區(127±3)、油門底端吸 0,壓 ESP32 ADC 雜訊。姿態讀數:roll/pitch 變動<0.8°、yaw<2°/s 不重畫,消除靜止時感測雜訊閃爍(不影響真實值/控制)。
2026-06-18 PID 回傳:飛機把目前 PID 帶進 telemetry,手把開機同步+存檔確認
    Telemetry struct 兩端各 +5 個 int16(PID×1000,30→對齊32 bytes,仍≤ACK上限)。
    FC buildTelemetry 填入 Kp/Ki/Kd/KpY/KiY。
    手把開機第一筆遙測 syncPidFromTele() 把選單值同步成飛機實際 PID(防呆:舊韌體回傳0/超範圍則跳過);按保存PID跳綠屏確認並顯示飛機回傳值。
    解掉手把預設值要手動對齊飛機的老問題。
    ⚠️ 封包結構變動,FC 與手把必須一起重燒。
2026-06-21 清理:移除過時的舊韌體/示意圖/重複文件
    刪除被取代的舊飛控韌體(Gyro/Manual/PID/PID_legacy)、舊手把韌體(Ground_TX/Test/Test_TFT)、早期自動產生的接線/示意圖 + 產生器、重複過時文件(接線總表舊版/接線指南/V2討論摘要/系統規格)。保留 Drone_Test、Button_Test 及現役主韌體。
2026-07-04 整理:測試程式歸類到 測試程式/(飛機/手把V2/遊戲),主力韌體留根目錄
    git mv 保留歷史;README 倉庫結構同步更新。根目錄現為:Drone_FC_Full、Ground_TX_ESP32、Ground_TX_OOP、ESP32CAM_Flight、Retro_Go_flightflight + 文件。
2026-07-05 整理:文件歸 文件/、腳本歸 工具/
    根目錄僅剩主力韌體資料夾 + README/CLAUDE.md;README 倉庫結構同步。
2026-07-31 新增手把 OOP 版韌體 + Retro-Go 螢幕改直向
    Ground_TX_OOP/:2026-07-04 完成的多檔類別版手把韌體(原版 Ground_TX_ESP32 保留)
    FlightLink/Inputs/MainUi/MediaPlayer/VoiceAssistant/WifiScan/PcBridge/PersistentMenu
    secrets.h 由 .gitignore 擋住,附 secrets.h.example 範本
    Retro_Go_flightflight/config.h:
    螢幕 320x240 橫向 → 240x320 直向(MADCTL 0x68→0x08)
    按鍵重映射:A/B 拆成兩段 ADC 門檻、GPIO9 改 OPTION
    [partitions.csv]
2026-10-01 文件對齊程式碼:mode 編碼、ESC 250Hz、nRF24 ch88、Telemetry 32B
    - README / docs×3 / 文件×3 依韌體修正矛盾描述
    - CLAUDE.md / AGENTS.md 對話紀錄規則去掉舊機路徑
    - .gitignore 加 graphify-out/
2026-10-07 FC:ESC 與主迴圈鎖 250Hz、sketch.yaml 改 core 3 板名;新增 PID 調校與 Nano 對照組文件
    - ESC setPeriodHertz(250)(原 ESP32Servo 預設 50Hz),燒完須重做 ESC 行程校準
    - 主迴圈 250Hz 節拍鎖,debugPrint 新增實測 Hz 欄位
    - sketch.yaml FQBN 改 esp32:esp32:d32(core 3.3.x 改名)
    - 文件/PID調校步驟.md、文件/Nano對照組_接線與燒錄.md、測試程式/Nano對照組/
2026-10-11 文件:修正尚未自由飛行卻寫成可飛行/實飛的描述,數值對齊程式碼
    - README、index、control、architecture、testing:可飛行/實飛/飛行中等說法改為地面測試、PID 調校中
    - 調參歷程表改為程式註解有紀錄的事實(Kp 2.0→1.0、傾角/偏航上限下調),移除查無根據的實飛紀錄
    - 互補濾波時間常數 1–2 秒 → τ = α·dt/(1−α) ≈ 0.2 秒(250 Hz)
    - 飛控主迴圈標題 50 Hz → 250 Hz,註明 250 Hz 版尚未上機實測
    - 錄音規格統一為 32 kHz 取樣、降採樣 16 kHz、上限 8 秒 ≈ 256 KB
    - 懸停自學習:收斂時間常數 dt/0.0002,增益標註為尚待驗證的設計值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
2026-10-12 文件:語音改為「辨識完成、操控未實測成功」,README 飛行相關說法對齊現況
    - index、control、voice、testing、README:語音控制 → 語音辨識;移除「飛機馬達動作」「單馬達展示可用」「整合實測控制鏈路不中斷」等未經實測的說法
    - voice.html §D.4.2 標明映射程式已撰寫但尚未實測成功
    - README:姿態自穩飛行 → 姿態自穩控制、GPS 導航標註開發中、懸停自學習標註待驗證
